Gadil123/esp32-design/docs/30_g_v1_hardware_arrival_space_and_mic_assessment.md

# G-V1 到货第一轮：空间、MIC 与缩宽闸门（2026-10-19）

**第一阶段已完成；第二阶段实体改壳暂缓。机械基线仍是 `ee8ec9d`。不批准打印。** 本次从已合并 PR #3 的 main 新建独立 PR，仅增加实测输入、可复现的精确空间检查和真实 CAD 剖面。冻结前壳、后盖、BOOT/BAT_PWR/RESET、四金属安装件/螺丝、USB/TF、格栅与 E/Pocket OS 均未修改。没有为取得 PASS 删除原有失败工况。

最小决定：保留当前 99.60 × 77.86 × 12.369521mm 外形；保留正面单个 Ø1.5mm 孔为**有几何依据、尚未切入壳体的候选**，不建立导音管或新隔舱。需要先确认 MIC1 声口、完整电池出线包络及扬声器接线/承托，再实施可审查的局部改壳。CAD 能证明主体不碰撞，不能证明这些未知接口已经装得上或收音不退化。

## 依据与证据边界

已阅读 README、报告07/24/27/29及 [Issue #4](https://github.com/Gadil123/esp32-design/issues/4)。截至本次读取，Issue 无评论、无新增声口照片；用户本轮文字测量另列为输入。旧冻结文档保持原样，旧尺寸不被偷偷改写成实测事实。

- 用户电池主体 42.26 × 29.49 × 7.61mm；在统一坐标中取 **X29.49/Y42.26/Z7.61**，中心仍 X48.4/Y14.5。不是完整电池总成或厂家 CAD。
- 用户扬声器主体 30 × 20 × 6.5mm、线长约40mm。端子、出声口、线长量法及胶/泡棉仍未测定。
- 用户实测 Factory V1.1/小智：FRONT 朝用户、PCB下绝缘泡棉，30–40cm清晰，超过2m可对话但减弱；REAR朝用户30–40cm变闷。作为满意的裸板基准，**不是声口朝向证据，也不是可直接量化的装壳性能验收**。
- [官方硬件资料索引](https://docs.waveshare.net/ESP32-C5-Touch-LCD-2.8/Resources-And-Documents/)与只读仓库 `schematic/ESP32-C5-Touch-LCD-2.8.pdf`：MIC1符号标为MIC1，四引脚 VDD/GND/GND/DAT，经网络接到音频电路；没有可识别的实装麦克风料号、封装机械图或 PCB 声学钻孔图。ES8311 是编解码器，不能代替麦克风声口资料。
- 精确原始 STEP：逐层累积 occurrence 位姿后绕 Z 旋转180°，**USB +Y，FRONT +Z，REAR −Z，侧键/TF LEFT −X**。全部723物理实体进入实际 BRep 碰撞检查。电池/扬声器仅有主体尺寸，因此明确使用主体包络；不将它们称为精确配件 CAD。

## MIC1 与单孔候选

| 检查 | 结果与限制 |
|---|---|
| MIC1 实体 | X21.53527…24.13571、Y−0.30619…3.09415、Z−6.60000…−5.60200mm；只有6个平面 |
| 封装/实际声口方向 | 名义六面体安装在 PCB 背侧；**具体型号、内部声口位置、顶/底进声均 UNVERIFIED** |
| PCB声学孔 | 在封装中心 X22.83549/Y1.395 放置半径0.3mm穿板探针，实交体积0.45238916mm³，约等于1.6mm实心板段0.45238934mm³；**STEP中心未建通孔**。不是全区域钻孔扫描，不能据此宣称实物完全无孔 |
| 正面候选孔 | **X27.30/Y1.395，Ø1.5，沿 Z 穿过1.2mm前面板**；板、屏、配件不与孔切削体相交；孔与前壳真实交体积2.120575mm³ |
| 与屏幕关系 | 右侧玻璃名义边 X25.27附近；孔近侧边 X26.55，留约1.28mm横向距离；不是在触摸玻璃上开孔，不挤压玻璃 |
| 自然空气间隙 | Ø0.5几何探针从孔后 X27.3/Z−0.8 沿现有间隙到 Z−7.1，再向 X22.83549，止于 Z−6.85。三段对全部原板实体及实际冻结壳体/候选配件均无实交 |
| 到实际声口 | **UNVERIFIED**：以上仅到封装外侧，未接到已知声口。没有把探针实体做成导音管，也没有把空气连通等同于声学低损耗 |
| 手指遮挡 | 孔在 FRONT、玻璃右侧靠中部；右手拇指/手掌可能覆盖。需握持照片/录音实测，未声称可达性通过 |

因此选择 A 作为待核实的唯一候选，不推进 B。现有证据没有显示需要复杂声道；也不足以把“封装外侧空气可达”当作实际收音通路，**本轮没有盲钻壳体**。

需要补充：统一朝向带比例的 MIC1 正反面与侧面微距、可读顶标；确认封装表面声孔及对应 PCB 正面区域（如被屏幕覆盖则请厂家提供料号/封装与钻孔资料，不要求破坏性拆屏）；确认该孔与 PCB/屏幕间隙的关系。不得根据本轮接近实心的中心探针臆造底孔或断言顶进声。

## 电池 Z 向链与 XY 收益

| 从 REAR 到 FRONT | 数值/状态 |
|---|---:|
| 后盖外表面 Z | −11.35mm |
| 后盖主体 | 1.20mm候选，原版不改 |
| 后盖内底 Z | −10.15mm |
| 胶层 | 0.20mm候选，未实测 |
| 电池主体 Z | −9.95…−2.34mm，厚7.61mm实测 |
| 前舱面板内表面 Z | −0.50mm |
| 主体上方几何净空 | **1.84mm** |
| 原候选膨胀预留 | 1.00mm，非电池厂家规范 |
| 扣除该预留后的剩余量 | **0.84mm** |
| 保护板、焊点、折弯、连接器 | **未知，不填0，不保证能放进剩余量** |

主体和候选膨胀探针均不碰真实壳/原板；主体随旧后盖初次抬角路径也无碰撞。**不是电池完整包装可安装证明**；不能让胶层、公差或软包压缩来“吸收”不足。若保护板叠在主体上，需检查其真实总厚；若从端部伸出，需计入平面及弯线半径。保持现有后盖，未为未知厚度先改整机。

旧34×50mm主体占地1700mm²，新29.49×42.26mm占地1246.2474mm²，约减少26.7%；X节省4.51、Y节省7.74mm。现位置主体 X33.655…63.145、Y−6.63…35.63；这部分空隙可优先用于保护板/接头/线束，而不是直接删掉外壳。旧槽名义内框35×51mm，相对居中的新主体每侧X约2.755mm、Y约4.37mm；实际围框另有开口/截断。因此**旧托盘不再构成贴合定位**，当前检查只覆盖居中姿态，不证明滑移后的安全。后续需按完整配件包络局部缩围框，或验证适合软包的少量固定材料；不能依赖前后壳挤紧电池。

缩宽局部敏感性直接截取**真实右下卡扣接收座**：向内移2mm未碰扬声器/电池/其余前壳；向内移4mm与原扬声器围框相交17.1252mm³，见 `width_local_checks.json`。该测试没有重新设计卡扣、工具释放、止口、托盘或整机路径，**2mm仅局部可研究，不是完整97.6mm窄壳通过**。30mm宽扬声器也已大于新电池29.49mm，电池节省量不是机身收益上限的直接答案。

本轮推荐**实际缩宽0mm**；可先保留约0–2mm的保守后续研究范围，不承诺4mm。2mm仅约2%宽度收益，却需联动右侧扣/座/止口/托盘与拆盖工具，当前未知完整配件包络时不值得先做。待实物接头摆放确定后，可由释放出的平面空隙决定是否值得局部缩宽，不增加长度，也不扩展结构方案搜索。

## 扬声器承托、线束及局部隔离

- 格栅、前侧泡棉候选0.5mm（含胶）、后阻尼候选0.3mm（含胶）保留。扬声器主体6.8改为6.5mm用于评估，前出声面位置不变；新阻尼背面与旧四承托块留 **0.30mm间隙**。不能宣称已固定可靠，后续按实物决定局部承托高度或真实缓冲厚度，不能任意加泡棉挤紧。
- 当前扬声器围框和候选周边泡棉提供局部定位/接触区域，但围框出线缺口存在，PCB区与扩展仓也不是完整气密隔断。扬声器前缘密封若不连续，存在前后声学短路及内部空气耦合至 MIC1 的风险；结构连接也可能传振。**风险存在，程度未经声学实测**，不将开放间隙直接等同于已发生严重失效。
- 旧 MX0→扬声器条件路径的真实圆角中心线约 **79.46mm**，超过到货线长约40mm；原路线不适用于实际40mm引线。旧 MX1 电池路径约86.82mm也只是条件代理。插座−X开口由真实腔体推定；MX0/MX1功能对应、插头/极性、配件端出线点和可用线长未闭环。**不能据旧路线过长判定40mm在任何布置下都不够，也不能宣称已连得上。** 需实物插头照片/配件端位置后做最短实际走线，再验证开盖服务余量。
- 暂不新增完整隔舱或麦克风专用通道。最小后续措施优先核实扬声器真实出声口与完整前缘泡棉接触，再按明确漏声处局部封边/减振；保留出线，避开软包。电池和扬声器之间不增加专门 MIC 声道。没有把 AI Passport 作为内部气密结构证据。

## 自动检查结果及未关闭门槛

复用原整机检查，先确认重新生成前/后壳相对冻结实体对称差均为0mm³；不替换成旧G或E。新主体下：

- 723原板实体对壳与配件静态碰撞为空，安装部件间实交为空。
- 原板完整装入/反向拆出、43块真实后盖分区覆盖及连续拆盖路径、两浅扣单撬片顺序拆卸、四螺丝/工具、独立USB插头/TF卡/RESET针检查保留；名义几何闸门通过。
- **原始侧键失败保留**：止口0.20＋孔隙0.15＋候选打印凸点短0.30mm组合，BAT_PWR/BOOT仍差约0.055722/0.053803mm，`BLOCKED_CONDITIONAL_PRINT_FIT`。不猜开关行程，不改冻结按键。
- 名义最大厚12.369521mm、含既有后盖刚体游隙上界12.386283mm；没有把工艺偏差或电池/线束变形包含在保证里。
- PA12壁厚/凸点/卡扣、螺丝扭矩与蠕变、真实安装件/螺头、反复拆装、真实USB/TF、整体公差均未关闭。静态主体PASS不关闭完整接线、承托、装壳录音与制造门槛。

## 交付、复现及第二阶段退出条件

环境沿用报告24：项目 `.venv`、`requirements.lock.txt`、build123d，无GUI、不改官方文件。一条命令从原厂STEP重做本次评估：

```bash
./scripts/assess-g-v1-hardware.sh
```

输出在 [评估目录](../deliverables/g-v1-hardware-assessment/README.md)：JSON结果、MIC/电池Z剖面、PCB/电池/扬声器剖面、新旧同尺度布局。图来自真实 BRep 剖切；电池/扬声器色块是明确标识的主体包络。另在 `build/g-v1-hardware-assessment/assessment_NOT_RELEASED.step` 生成含完整723实体的查看装配，**不是改壳发行件，也不是可制造整机**。没有复制完整官方STEP进Git历史。查看模型回读727/727实体有效；授权下载命令见交付目录README，实际下载记录见 `download_verification.json`。

阶段二暂不产生“已修订”前后壳STEP/STL，避免把未确认声口/线束包装成已完成模型。原冻结STEP/STL与下载说明28继续有效。补齐以下信息即可定点推进，不需重新搜索结构：

1. MIC1声口和PCB实际通孔/间隙照片或实装料号资料，及推荐孔位置的握持遮挡检查。
2. 电池含保护板/封边/焊点的最大尺寸与出线方向；连接器、线束可用长度、弯折空间和厂家安全余量。
3. 扬声器出声面、端子/线端位置、40mm线长起止、实际插接到哪一个座、泡棉/胶/阻尼实厚及承托试放。
4. 后续实机与裸板在同固件、距离、说话音量/环境下比较 FRONT 30–40cm与>2m录音/对话；再加扬声器播放时串音、常用握持遮孔、开盖服务余量及反复装拆。收音不得明显退化；不凭一次对话或CAD宣布验收。

本次是针对信息缺口的工程闸门结果，不是打印许可；提交独立PR等待Reviewer，无合并、下单、固件或Pocket OS更改。
