Gadil123/esp32-design/docs/29_g_v1_design_freeze_and_hardware_handoff.md

# G-V1 首版 CAD 候选冻结与实物复测交接（2026-10-17）

> **状态：CAD DESIGN BASELINE FROZEN / HARDWARE PENDING / NOT PRINT APPROVED。** 用户认可目前 G-V1 的总体设计，本轮停止进一步按键/机壳外形迭代；待板件、电池和扬声器等实物到货测量后，再做少量有针对性的尺寸修订，尤其确认 MIC1 声学孔。这里的“冻结”只表示**保存可复现的设计基线**，不表示制造、功能、可靠性或最终下单获批准。

## 唯一当前基线（勿混用旧版 G 或方案 E）

- **基线提交：`ee8ec9d`**（PR #3，Task26）。后续此文档/README 的归档性变更不改变基线 CAD。
- **整机架构：** G-V1 深前壳 + 可拆后盖，Waveshare ESP32-C5-Touch-LCD-2.8 旋转到 USB 顶部（USB +Y；屏幕 FRONT +Z；原生侧键和 TF 在 LEFT −X）；屏幕与前框名义齐平，无玻璃压边。
- **按键：** KEY1/BAT_PWR 前壳一体 L 形 PA12 弹片；KEY2/BOOT 前壳一体圆角矩形弹片，参考长13×高3mm、有效梁11mm、厚1.2mm；RESET Ø2.2mm 卡针孔。**没有独立键帽。** 使用方位和局部止挡详见 [报告27](27_t0_g_v1_boot_rectangular_key_revision.md)。
- **固定：** 后盖两处对角浅卡扣 + 非锁定定位止口；四颗候选普通 M2.5×4 机螺丝从 REAR 外侧贯穿 PA12 承力座，连接原厂 PCB 金属 M2.5 螺纹安装件；先卸螺丝、再用一片约0.8mm塑料撬片顺序拆盖。
- **候选实体：** `deliverables/t0-g-v1-boot-rect/front_shell.step` / `.stl` 为**新版前壳**；后盖仍使用**未修改**的 `deliverables/t0-g-v1/rear_shell.step` / `.stl`。不能误用旧 `t0-g` 的12.9mm后盖、独立帽或四隐藏扣。
- **名义装配：** 官方原板 723 物理实体；完整 STEP **739/739 有效**，外包络 XY 99.60×77.86mm，名义厚度12.369521mm，含已建模后盖刚体游隙的上界12.386283mm。**通用制造公差、实物变形或翘曲不包含在这些保证中。**
- **完整 STEP：** 见 [私有下载及 FreeCAD 操作说明28](28_g_v1_private_download_freecad.md)。旧 `e805d38` 完整组装 ZIP `t0-g-v1-review-complete.zip` 与 Task26 新 ZIP `t0-g-v1-boot-rect-task26-viewer.zip` 保留。原板全723实体分组可显隐/视觉分解，GLB/Light STEP 是含代理的快速预览，**不能当精确装配净空证据**。Draft Release 的普通页面曾 404，使用已验证授权命令或服务器 SCP。

## 本轮已收敛 / 不再重复搜索

1. G-V1 结构方向及 BOOT 圆角矩形外形已被用户接受；BAT_PWR 保持 L 形；E/旧 G 等历史 CAD 与失败证据冻结保留。
2. 不继续讨论独立键帽、复杂按钮机构、精确到几十微米的纯软件过度优化、复杂 FEA 或重新开发 Viewer；后续仅由**实际尺寸和装配观察**驱动局部变化。
3. 当前仓库的 CAD 名义验证与 Reviewer 复审可以作为下轮对照基准，但不等于实际产品验收。

## 必须保留的未验证事实

| 条目 | 当前情况 | 到货后处理 |
|---|---|---|
| 两侧键触达 | 后盖止口0.20＋螺孔0.15＋凸点假设短0.30mm的组合下，KEY1/KEY2在参考止挡时尚差约**0.05572/0.05380mm**；`BLOCKED_CONDITIONAL_PRINT_FIT` | 实测按键触发、行程、按力、回弹，必要时局部调整凸点/止挡并重验双向装板，不能直接凭理论尺寸加长0.12mm |
| BOOT 新片 | 同材简化模型刚度约旧片1.5倍；根应变估算2.08%；力与寿命未知 | 实物感受、检查根部及止挡；不宣称 PA12 疲劳已验证 |
| 电池/保护板 | 34×50×5mm、0.2胶层与后盖1mm浅围框均属临时包络 | 实测外形、膨胀余量、保护板、连接器及出线方向 |
| 扬声器 | 30×20×6.8mm、泡棉和前壳围框/后盖支撑为候选 | 实测结构、喇叭出声面、线束与缓冲 |
| **MIC1** | 唯一麦克风；官方 STEP 不证明实际进声孔朝向，**尚未设经过验证的声路** | **先确认实际 MIC1 声孔与 PCB 朝向，录制裸板音频基准，再设计正确位置/形状的声孔或导音道，并装壳对比**，不盲开孔 |
| MJF/螺丝/装配 | 局部0.8–1.2mm薄壁、止口/扣间隙、4×1mm承力座；实物螺丝规格、线束和真实卡扣手感尚未验证 | 厂商审核前后壳 STEP/STL，轻拧实际螺丝、测试单撬片拆盖、真实线束余量和USB/TF插拔 |
| 最终尺寸 | 12.4mm仅设计名义目标，后盖可能受工艺偏差 | 实物验收、按厂家反馈局部修正；勿宣称成品尺寸确定 |

## 到货后如何继续

下一阶段统一跟踪 [Issue #4 · 到货后实测与 MIC1 声孔](https://github.com/Gadil123/esp32-design/issues/4)。请先拍正反面、侧键、MIC、原厂安装件、所购电池/喇叭和接口特写，并记录实际卡尺测量；**先收集实物证据，再开新的小 PR 修改**。保留本版原始 STEP/STL 以便新旧对照。

**此次 Git 归档不代替嘉立创 DFM 审核，不意味着用户已下单，也不触发提醒/未来自动开发。**
