Gadil123/esp32-design/docs/16_t0_d_local_passport_study.md

# T0 D：短边缘卡齿 + 后盖浅窝，局部装配闸门

**结论：BLOCKED，缺少 PCB 朝 FRONT（+Z）的保持反力。** 本轮只提交一个局部短齿配对与四安装位浅窝，不重写整壳、不回退螺丝或旧四弹性夹位。A/B/C、Pocket OS 文档保留；不合并、不打印，交原 PR #3 复审。

依据：[本轮唯一有效实施指令](https://github.com/Gadil123/esp32-design/pull/3#issuecomment-6214796520)，以及此前 C 复审。后者的“先失败就停止”原则仍适用，旧 C 刚性前环台装入失败没有被撤销。

## 一页证据表：仿结构分工，不从照片量尺寸

资料：[EEWorld 拆解](https://bbs.eeworld.com.cn/thread-1367442-1-1.html)、[与非网同一拆解](https://www.eefocus.com/article/2089827.html)。本轮成功读取与非网正文及图注；EEWorld 请求超时、内嵌照片返回拒绝访问，**没有冒充独立数齿或识别隐蔽承力面**。照片特征以本轮 Reviewer 已审阅的描述为依据；正文可以交叉核对免螺丝拆盖事实。

| 证据层次 | 可用事实 | 不能据此推定 | 本轮 CAD 处理 |
|---|---|---|---|
| 拆解正文/图注 | 后盖沿边缘撬开，无螺丝、无封壳胶；边缘有槽与凸台 | 所有槽都是同构卡扣、固定扣数或寿命 | 只建一对短齿/窗，不选整机扣数 |
| Reviewer 已看照片的记录 | 短边缘结构、圆形柱状结构可见 | 五柱均固定 PCB、七处均为弹性扣；柱下隐藏接触关系 | 浅窝仅是 T0 候选，不能写成复刻的原机板固定方式 |
| 工艺/板卡差异 | 原机定制 PCB/注塑；本机完整微雪板/MJF PA12 | 注塑的弹性、公差可直接移植 | 短齿刚体让位与材料能否实现分开报告 |
| 原始 STEP 可量测 | 原板四金属安装件、外周/背面、显示与 PCB 相对位置 | 金属螺纹孔是空 PCB 孔，玻璃可承夹紧力 | 外周浅窝、中心避空；不用玻璃承力 |
| 本轮实建几何 | 1.5mm 竖向短壁、0.7mm 齿、连续搭接边 | 是照片原尺寸；等于原 A 的 12mm 横梁 | 所有候选尺寸集中参数化，旧 A 不改 |

## 一个候选的实际结构与装拆边界

坐标仍是原始 STEP 累计 occurrence 后绕 Z 180°的刚性旋转：**FRONT +Z，REAR −Z，USB +Y**。FRONT 看原生键/TF 在左。名义玻璃/前框 Z=+0.70，后盖外面 −11.70、内面 −10.50；目标外形 99.60×77.86，局部实体最大厚度 12.40mm。这里只建板周开放前框、四个后盖承座块和右边缘一个配对，**没有完整 D 外壳，不能声称整机装配通过**。

短齿位于右边 X≈70.13、Y=−4，避免已保留的侧舱临时配件。接收壁厚 1.5，窗宽 5.6；后盖短壁厚 1.5、宽 5.0，齿向外伸 0.7，搭接间隙 0.3、实际保持重叠 0.4。前壳局部接收件向后延伸至 Z=−7.6，使窗下承力段达到 1.5；后壳对应边退至其后留 0.15 接缝。连续定位边在齿两侧延伸，不是另一组锁扣。

薄撬片候选厚 0.35、宽 2.0，从外侧接收窗接近，向内让齿 0.5；单扣退后局部 2.8 后才允许回弹。检查包括名义配对、退后 0.3 的保持交叠、自由端内移后的扣入/拔出扫掠及外部工具通道。**自由端内移采用刚体让位代理，不表示根部也可以平移，更不等于真实弹性变形已通过。** 根部固定、受力点至根约 4.6mm，简单悬臂估计表面应变约 5.3%；该短厚结构已超出可凭线性估计放行的范围，根部应力、实际扣入力、回弹与寿命均待验证。完整薄盖逐个开扣、保持前一处张缝未验证；不把一个扣的自由端让位升级为整盖可拆。

四浅窝使用原厂外径约 5.5 的金属安装件，背面 Z≈−9.50；后盖到该面仅约 1.00。环形承面中央 R1.6 避空，不插螺纹孔；窝壁厚 1.5、外周包覆高度 0.8，原件后端约 0.2 倒角使有效直壁配合约 0.6。沿用 C 的候选基准余量：左侧两窝径向 0.1、左上沿 Y 再放宽 0.3，右侧径向 0.3。没有过盈、胶粘或未知弹性预压。

## 唯一主要阻断：浅窝没有 +Z 反力

| 自由度/载荷 | 本候选真实作用 | 状态 |
|---|---|---|
| X/Y、绕 Z 转动 | 在金属外周仍位于浅窝内时，两分离左基准限制横向及偏转；右窝避空 | 有限游隙，0.1 配合未获工艺验证 |
| 向 REAR −Z、单侧倾转载荷 | 四环形背面承座提供单向支撑 | 名义接触；不向电池/玻璃施力 |
| **向 FRONT +Z** | **没有前挡或止退接触面；浅窝朝前开放** | **FAIL** |
| 开盖后的 PCB 保持 | 后盖移开即失去这些承座 | 不能声称 PCB 留在前壳可靠定位 |

完整官方模型的 X/Y 包络在开放前框通道内，可连续沿 Z 穿过，避免旧 C 预装前环台挡住屏幕。装入能通行同时也暴露保持问题：**后盖不动，整块 PCB/显示总成仍可向 FRONT 移动 0.4mm**，玻璃随之高出名义齐平面。对固定局部件向 −Z 作连续扫掠，等价检查原板向 +Z 的整个区间，保留环窝/开口真实空腔，不用实心包围盒填掉它们。零碰撞的逃逸反例足以否定“可靠三轴定位”，无需推到完全拔出才判失败。

前壳加挡块会重新涉及装入障碍，改用玻璃、键帽、插座、线束或电池挡住前移也不符合约束。**本轮不提出/搜索补救机构。** 侧键接触依赖板位置，故即使名义附件不碰，也不能关闭原有偏移/固定框风险或保证触发；未知开关行程不赋值。

序列记录在报告中：先置键帽→整板从 REAR 进入开放前框→浅窝随后盖就位→单个短齿扣合→检查闭合后板保持（失败）→局部撬片退齿/取盖与取板。键帽安装及原厂开关穿越、真实线束接插顺序、整盖逐个释放仍未验证。到本闸门停止，未把这个序列写成完整装配 PASS。

## 最小交付与复现

参数：[t0-d-parameters.json](../cad/t0/t0-d-parameters.json)；模型：[t0_d_study.py](../cad/t0/t0_d_study.py)；运行与图纸：[generate_t0_d.py](../cad/t0/generate_t0_d.py)。环境、原始只读 STEP 及 build123d 版本沿用 [T0 工程](11_cad_t0.md)。一条命令：

```bash
./scripts/generate-t0-d-study.sh
```

输出至 `build/t0-d` 和 [交付目录](../deliverables/t0-d/)：一组短齿/窗 CAD 剖面、一组四安装位/放板路径剖面、两份局部 STEP、最小检查报告。没有新小样系列、没有整壳 STL 或完整装配 STEP；有限交付遵循本轮指令。最终构建直接重读官方 STEP；全部原厂实体参与新增结构静态核查，USB/TF/MX、原有键帽、临时电池/扬声器/保护板/胶层/泡棉/阻尼/线束作为保留边界，不由本轮重新设计。

本次原始 STEP 重建完成：723 个原厂 solid 参与核查；新增承座/短齿配对与原板和上述临时附件未检出体积交叠。板周前框只是开放通道参照，尚未完成原生键/TF/USB 的外壳导向与开孔，**不将它计为接口已装配通过**。两份 STEP 回读分别为 2/12 个有效 solid，最大 Z 均为 12.400mm。单扣后拉 0.3mm 的保持交叠约 0.365mm³；退齿后的扣入/退出代理及外部工具净空无交叠。开放板通道四周名义包络余量均为 0.600mm；闭盖前移 0.4mm 的连续反例同样无干涉，因此可靠 Z 定位明确失败。

报告中的局部实体有效/名义净空通过不代表制造通过。黑色 MJF PA12 的 1.2 后盖、0.7 齿突出/0.1 齿尖平台、0.3 搭接间隙及 0.1 定位配合需商家和实物验证；0.3 间隙不能覆盖两个配对件各自的 ±0.3 参考误差。旧 USB 0.88 薄边、保护板 0.23 侧隙、MIC1 音口/录音、MX 身份与真插头、TF 弹出、侧键回弹等门槛保留，不扩大处理范围。

**退出：一个局部候选因缺少 PCB +Z 保持而停止；没有整机可装、可拆或可打印的通过结论。等待 Reviewer，禁止合并与打印。**
