Gadil123/esp32-design/docs/18_t0_g_recessed_full_wrap_cad_task.md

# T0 G：屏幕内沉的全包围深前壳＋嵌入式后盖（开发任务，2026-10-16）

> 用户已批准**开发并展示完整 G 候选**。本任务与 E 并列，不把 E 改成 G；E 的完整名义 CAD 已完成、留作回退与外观对照。对应 [Draft PR #3](https://github.com/Gadil123/esp32-design/pull/3)，本任务发布时 head `552fcf3fdea37b1cf5542549e643d3b19b2becf5`。G 不是已通过的设计，未获打印/合并批准。

## 0. 本轮范围与用户确认的结构

**只建模一条 G 主路线：** 
- **一体打印的深前壳** = 正面连续细边框 + 四周完整侧壁 + 右侧电池/扬声器仓前面板（含原六槽正面扬声器格栅）。盒口在 REAR；屏幕/原板从 REAR 方向垂直装入。
- **正面玻璃比外壳最高面下沉约 0.5mm**（设计目标，具体以真实板件尺寸链校准）。正面薄压边**仅适度盖住屏幕玻璃的非显示黑边**，尽可能形成隐藏黑框观感；不能遮挡有效显示/触控区域，也不能把玻璃作为承重/锁紧硬止挡。若官方 STEP 不包含可视区域边界，标明未证实并用保守候选，**不得凭空断言可盖住多少毫米黑边**。
- **后盖**是嵌入式、尽量平整的一片背板：**四颗从背面拧入原板自带的 M2.5 金属螺纹安装位的机螺丝**把原厂 PCB/屏幕总成锁在后盖局部承力座上。不是塑料自攻螺钉，不另加 M3 嵌件；不让螺丝穿透显示屏，也不把 PCB 作为外壳整体承力梁。
- **壳体合拢**：后盖周缘的浅**止口/插入凸缘**导向、前后壳接缝的**非玻璃承力硬止挡**控制闭合高度；后盖周缘的一体式**短弹性卡舌＋小倒钩**扣入深前壳**内壁卡槽**。外侧不设显眼侧面扣孔；后盖背部靠边留一处可从外部接近的塑料撬片入口。初始选取少量足够覆盖各边的扣位（约 3–4 处），**不要自动复用 E 的 5 短齿或 A 的 7 悬臂梁**；具体数目按真实装配布局确定且要说明。不要多方案搜索。
- **最大厚度硬上限由 E 的 12.4mm 放宽为 G 的 12.9mm**，包括原板、前壳、后盖、螺丝头、按键、临时配件等最大 Z 包络。当前 E 壳宽 `99.60mm`、长 `77.86mm`（侧键向左外伸 1.9mm，整体平面横向包络 101.50mm）保持 G 的尽量不超目标；必要的变化须列出真实原因。不因 0.5mm 内沉擅自再增加总厚。

## 1. 开发顺序：先关键装配闸门，再做完整 G 壳（避免 C1/D 重演）

**使用供应商官方 Waveshare STEP 原始全部 723 solids**，USB +Y、FRONT +Z、FRONT 左侧原生 KEY/TF；不要用 AI 效果图或轻量代理证明干涉合格。

1. **装板与开口：** 完整 LCD+PCB 从深前壳**背部开口进入、直线向 FRONT 落下**，直到 LCD 正面距外壳最外平面约 0.5mm。连续碰撞检查涵盖显示玻璃、原厂四金属件、USB、键、TF、MIC、MX 插座；区分开口非显示黑边薄压边与真实玻璃/可视区域，合理设软性接触缓冲候选，不能靠后盖顶压玻璃来消除游隙。
2. **PCB 与 REAR 螺丝真实夹紧路径：** 先选普通 **M2.5 机螺丝**而非自攻件，四处原金属螺母对准后盖过孔，背面工具可达，实际头部高度/径向承压面和螺杆啮合长度避免碰周边元件/显示屏。C2 曾在 M2.5×4 低头候选下仅得到 **0.8mm 承力 PA12 座**，**此风险不能由于换 0.6mm 超低头螺钉而假装已消失**；用真实可买螺钉的尺寸，检查四处剩余承压环、Z 包络、最薄打印壁，说明力从螺头→后盖承座→原厂金属安装件如何传递，实际抗扭/蠕变保留物理验证。
3. **分清连接功能：** 四颗 M2.5 **只连接 PCB 与后盖**，并不直接锁住深前壳。后盖通过周边卡舌+卡槽+止口接入深前壳。螺丝决定 PCB 在后盖的 Z 位置；前后壳独立硬止挡决定闭合；薄前压边只是遮黑边/保护，不应承担超出缓冲范围的 PCB 轴向预紧。以真实坐标说明 PCB 限位在各方向（尤其 +Z、−Z、绕 X/Y 翘起）如何成立、以及屏幕表面下沉距离的公差。
4. **卡接与拆盖：** 至少一对**真实实体**的后盖弹性卡舌/前壳内壁槽，加上可理解的周缘止口和装配碰止面；验证按下后倒钩进入凹槽、后拉能被保持、用薄塑料撬片可以逐处释放。检查 PA12 让位弯曲根部实际厚度、梁长、应变风险和制造间隙，**不允许仅以刚体移动量几何 PASS 作为五十次装拆寿命证明**。E 原短齿 4.6mm 有效梁、0.5mm 让位时简估应变约 5.3%，不是直接照搬可制造模板。
5. **装配次序检查**（这是必须实际模拟的）：后盖与完整原板先用四螺丝固定 → 将屏幕/PCB/后盖从深前壳 REAR 装入 → 边缘止口/扣舌锁住 → 拆盖时保持屏幕与后盖同行且不挤压前框。**特别核实原厂左侧独立实体键帽的安装顺序**：E 发现键帽先在前壳内会撞 LCD、必须装板后从 REAR 放入，但 G 的后盖预先连 PCB 可能阻断这种顺序；不能漏掉此装配闸门，也不能为方便而直接增设新电子键或封死维修。需要最小顺序变通则具体报告。
6. **右侧舱位/走线：** 前壳仍有正面扬声器、后盖仍可承托临时电池；软包电池不得被后盖锁紧力压迫，扬声器泡棉密封不得被加强筋占用。MX1.25 座朝原板内侧 −X，电池/扬声器和导线目前为临时包络；确认后盖+PCB 整组装入时导线能被安置，不能靠拉扯插头。USB 顶部与 TF 侧向插拔/弹出候选保持，MIC1 未验证声孔不要擅自钻孔。

**STOP 闸门：** 如果全板从背面进不了、四颗螺丝承压座在 12.9mm 下有无法克服的实质空间冲突、侧键无法合理安装，先输出**具体实体/剖面/最小让步**，不要换方案或做一整套失败外壳；已有实质几何通过后才完成 G 全壳模型。

## 2. 强度及外观重点——沿用简单成熟结构，不做 FEA 展开

- **连续前框与深侧壁是一体塑料零件**，四角、左侧 KEY/TF 开口和 USB 薄边注意局部过渡圆角；屏幕窗口边框形成抗外翻闭合截面，但不能声称已具有实测强度。
- **右侧电池舱+扬声器区**优先利用左右分舱隔梁、扬声器支承框和外侧壁形成结构连续性，只有在已知不碰临时配件的位置加必要局部筋；不得压缩软包电池所需余量或声学密封。
- **外观目标：正面没有任何螺丝、正面薄边框只露出显示有效区域（尺寸待核实）、屏幕下沉约 0.5mm、黑色外壳；背面可见四颗低头 M2.5 螺丝及分件接缝，尽量简洁。** 只做几何原生的黑/深灰可读 CAD 预览，不新增橙键着色工艺、装饰线、新外形变体；E 和 G 直接比较时使用**同视角、同 mm 比例**，而非 AI 生图的想象零件。
- **PA12 制造门槛明确**：细薄前框/扣齿、侧键间隙、0.8mm 螺钉承座、后盖薄板翘曲、真实玻璃/原板制造公差。只记录局部风险，不用通用“全部达标”替代真实承压/弹性验收。用户后续可能选择直接打第一套，**但本任务不批准打印**。

## 3. 有限交付：用户要“做一个 G 版本看一下”

- 在现有 `cad/t0/` 和 `deliverables/t0-g/` 新增 **G 独立参数、完整前壳/后盖/三帽 STEP 与 STL（如果几何闸门通过）**；四颗螺丝的真实模型/BOM 条目及可复现轻量装配 STEP/GLB；含真实全部官方 solids 的整机 STEP 尽量提交 review 压缩附件而非塞进 Git。
- 最少需要的**原生 CAD 图纸**：**FRONT、REAR、LEFT、ISO FRONT、屏幕薄压边与 0.5mm 下沉剖面、四螺丝承压与 Z 尺寸链剖面、后盖卡舌/内槽/止口配对及撬开示意、装配顺序图**。图中标注 FRONT/REAR/USB 方向，屏幕有效区待核实必须标 `UNVERIFIED`。
- 提交 **G vs E 单页对照**：外形（含侧键）、厚度 12.9 vs E 12.4、屏幕露出/隐藏黑边、背面螺丝/接缝、材料和卡舌数量、装配难点、PA12 风险；**不是“G 必定优于 E”结论**。
- 极简几何 gate/report：装入连续路径、四孔机螺钉及支撑/玻璃保护、后盖合盖/释放、USB/TF/键帽/右舱主要干涉、STEP solids 有效性/最大厚度。不再新增 14 件局部测试件，不做大规模材料仿真，不构造虚假零件测试集。

## 4. 操作与范围边界

- **E 是“完整名义几何成熟候选”并冻结保留**，A/B/C/D 和旧交付、Pocket OS 软件文档不变；不覆盖、改写已有 E CAD，不合并现有 Draft PR。
- 只做上面这**一种** G 深前壳 + 后盖螺丝固定板 + 止口/隐藏短扣方案；如果重大障碍 STOP 并拿剖面报告征询，不擅自追加两颗外壳自攻螺丝或重建 E。
- 不购买、不订料、不下单嘉立创、不批准打印；禁止 SHA 校验和无必要的大型测试框架。

**成功交付的表述：** `G full nominal assembly CAD complete; geometry reviewed; material/functional acceptance pending`，不可写 `manufacturing approved`。
