Gadil123/esp32-design/deliverables/t0-g-v1-integrated/README.md

# 任务23 局部装拆闸门

只针对两颗一体PA12侧键、真实止挡及官方完整板屏总成。未按/候选/止挡剖面、偏移见证、装入图、STEP/STL和报告可审查。局部模型不是整壳厚度证明。

完成整壳见 [G-V1](../t0-g-v1/README.md)，复现及边界见 [报告24](../../docs/24_t0_g_v1_integrated_pa12_assembly.md)。完整官方局部装配及最差偏移见证在私有Draft release新资产 `t0-g-v1-integrated-local-review.zip`；不提交原厂完整STEP至Git。

模型接触只证明几何可及；原生开关活动头、行程、PA12按力/回弹/寿命未实测。不打印、不下单。
