Gadil123/esp32-design/deliverables/g-v1-hardware-assessment/MIC_and_battery_XZ_sections.png

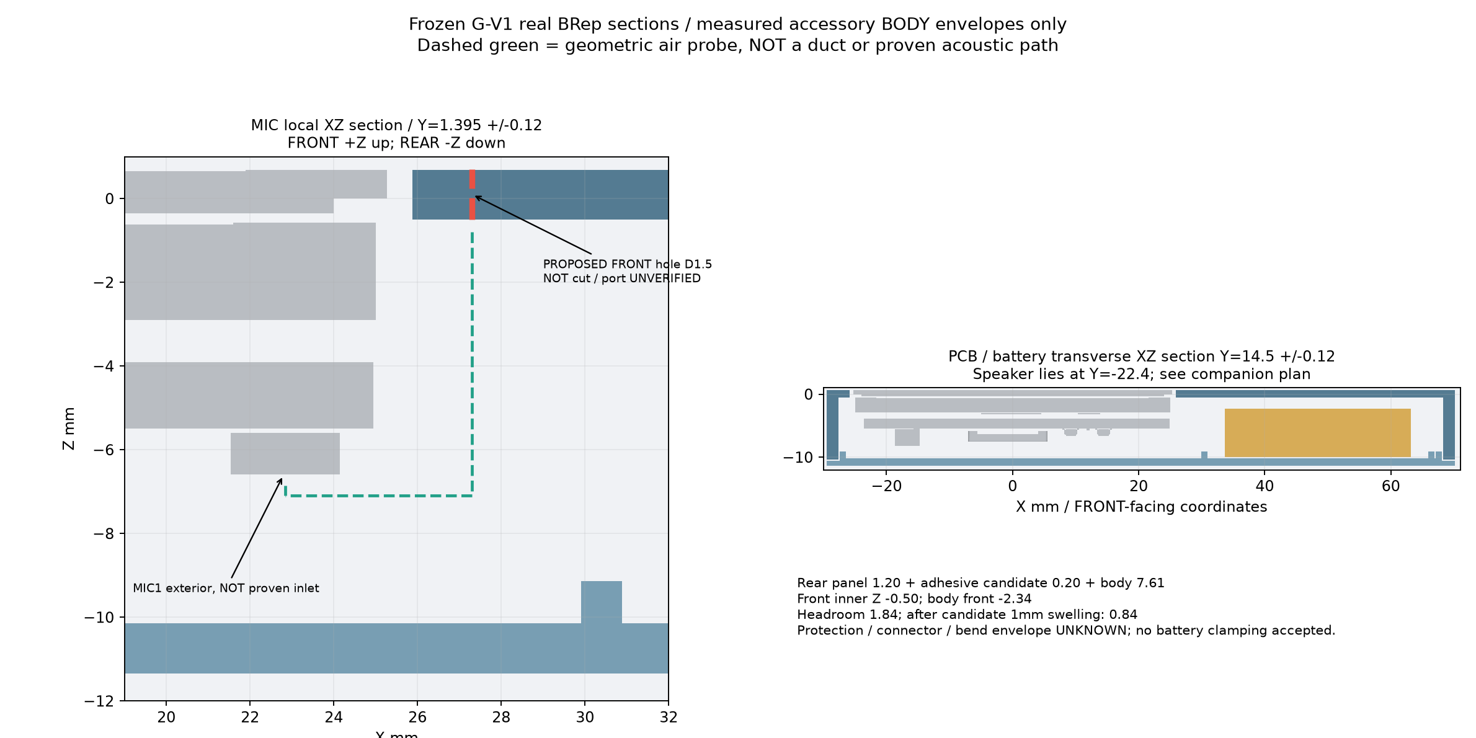
deliverables/g-v1-hardware-assessment/MIC_and_battery_XZ_sections.png
