Gadil123/esp32-design/deliverables/g-v1-hardware-assessment/PCB_battery_speaker_sections.png

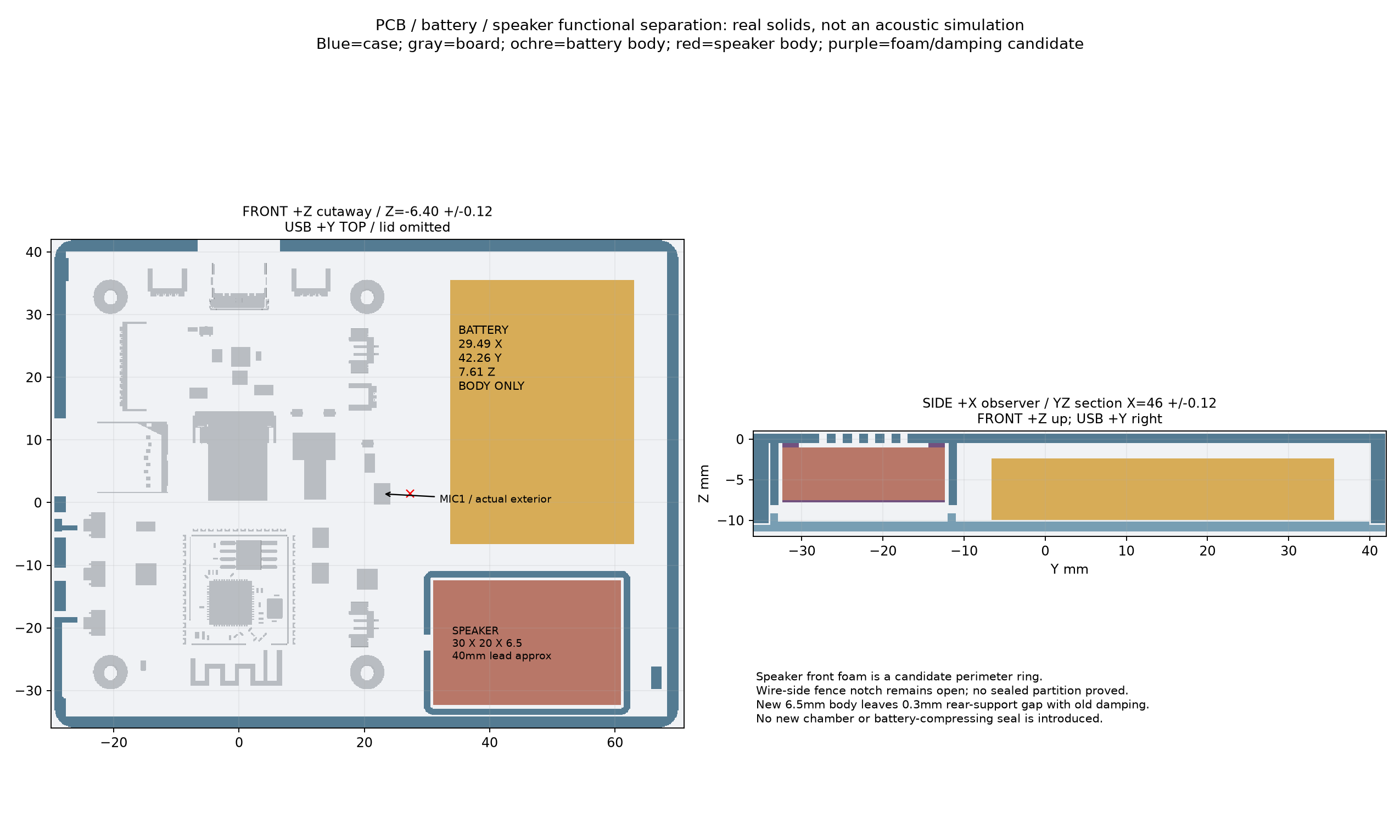
deliverables/g-v1-hardware-assessment/PCB_battery_speaker_sections.png
