Gadil123/esp32-design/deliverables/t0-a/12_4mm/connection_sections.png

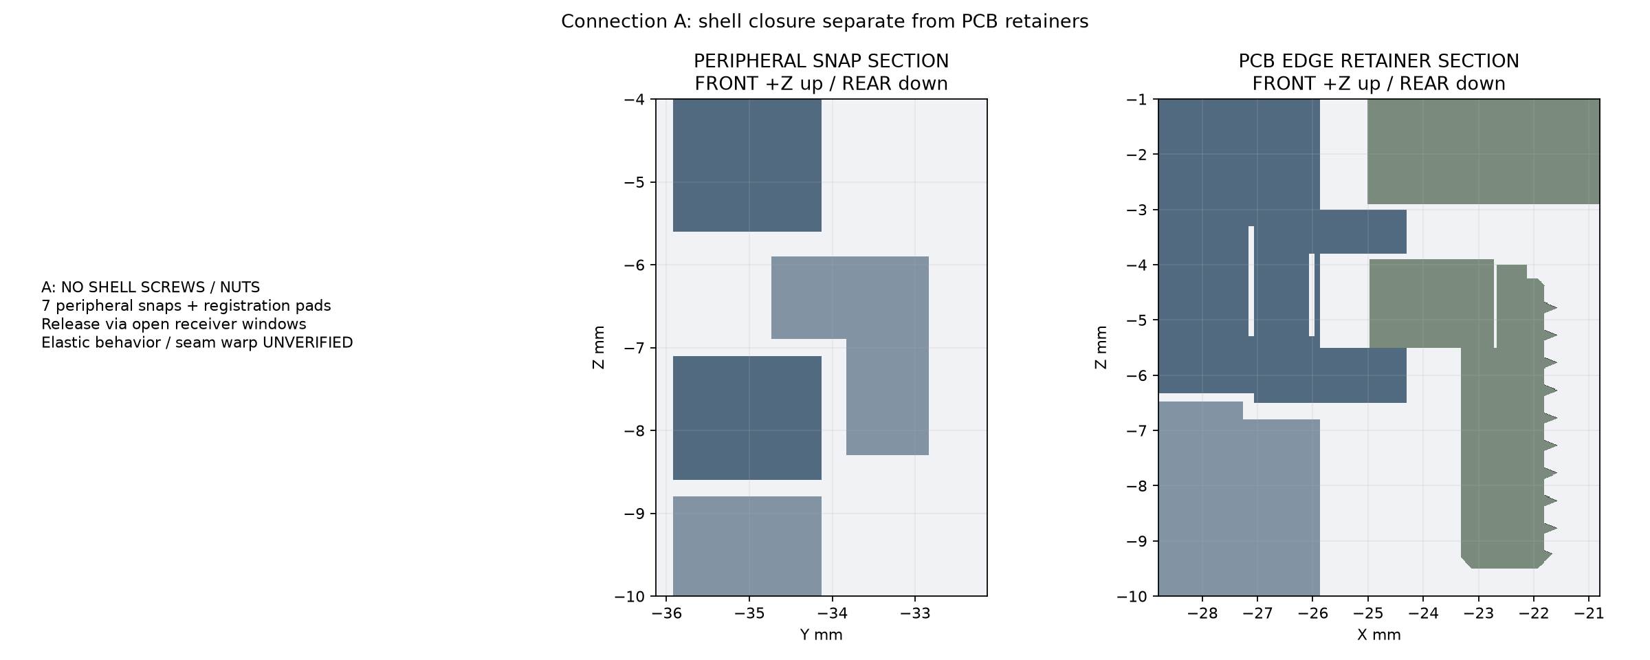
deliverables/t0-a/12_4mm/connection_sections.png
