Gadil123/esp32-design/deliverables/t0-a/12_4mm/orthographic.png

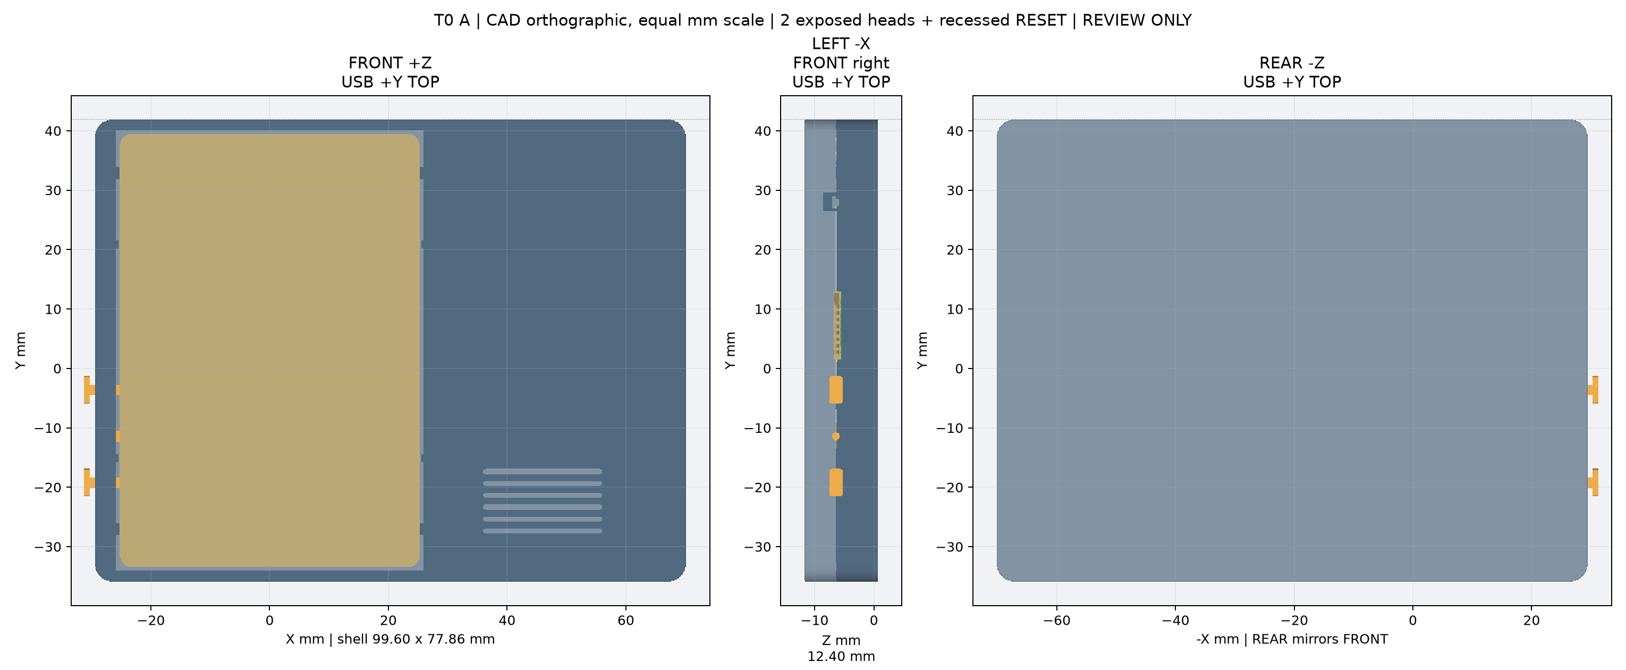
deliverables/t0-a/12_4mm/orthographic.png
