Gadil123/esp32-design/deliverables/t0-a/key-study/B_1_9mm/orthographic.png

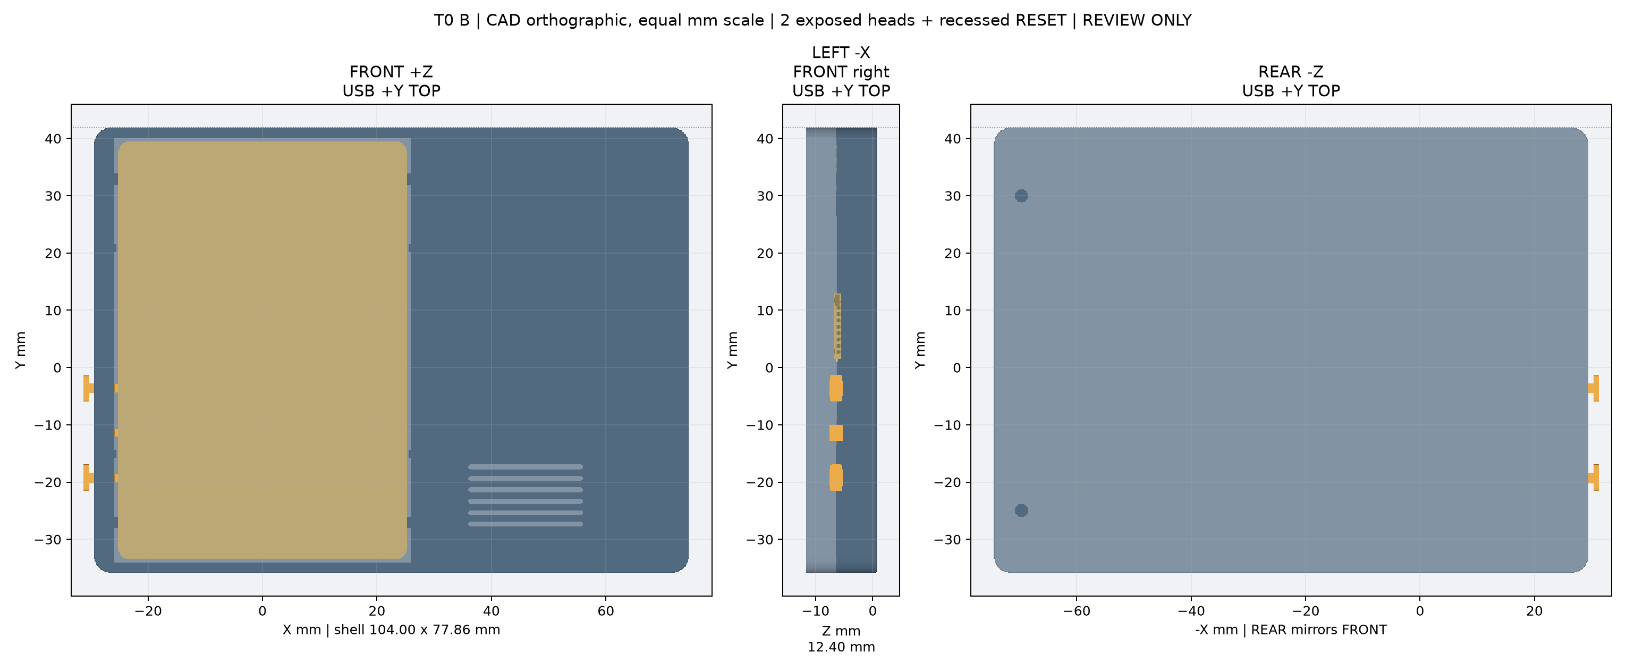
deliverables/t0-a/key-study/B_1_9mm/orthographic.png
