Gadil123/esp32-design/deliverables/t0-c/four_latch_release_plan.png

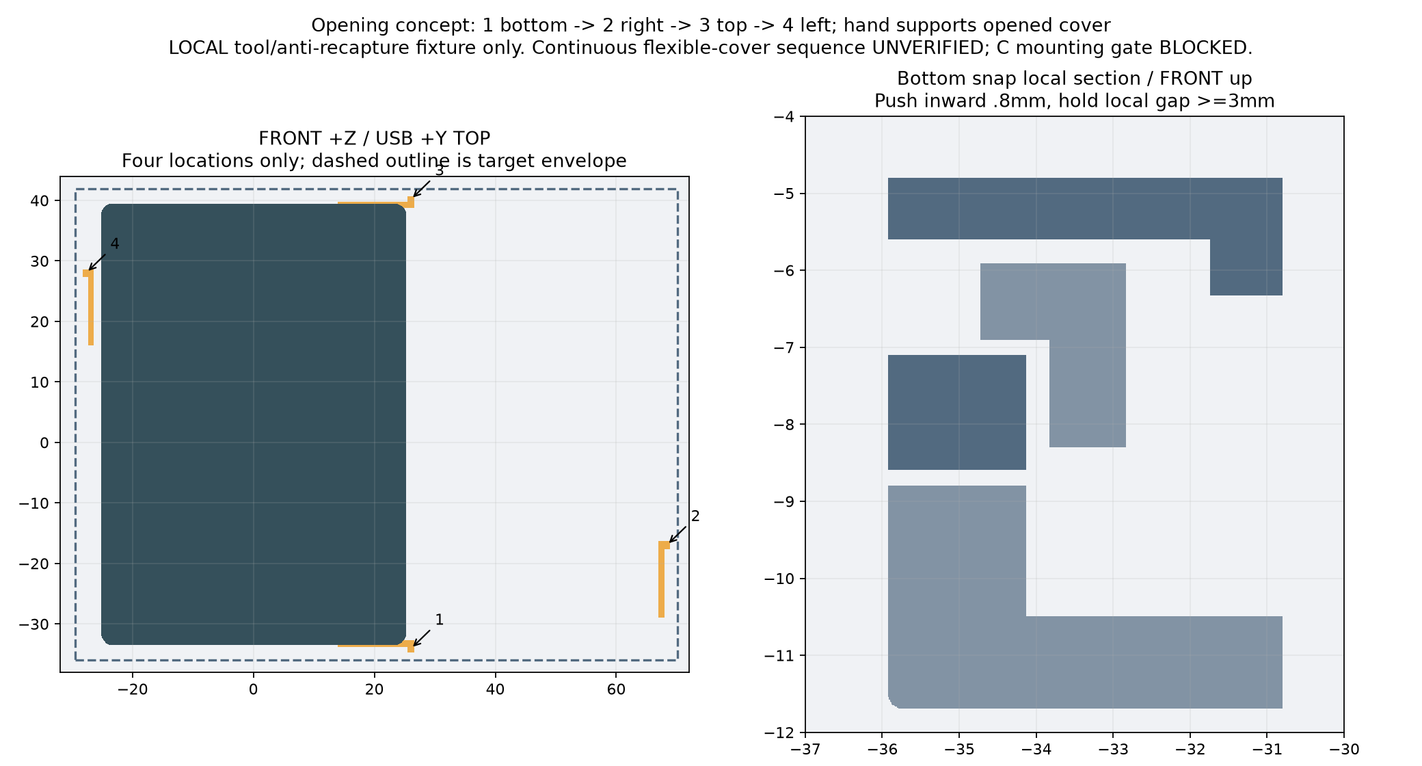
deliverables/t0-c/four_latch_release_plan.png
