Gadil123/esp32-design/deliverables/t0-c/key_sample_sections.png

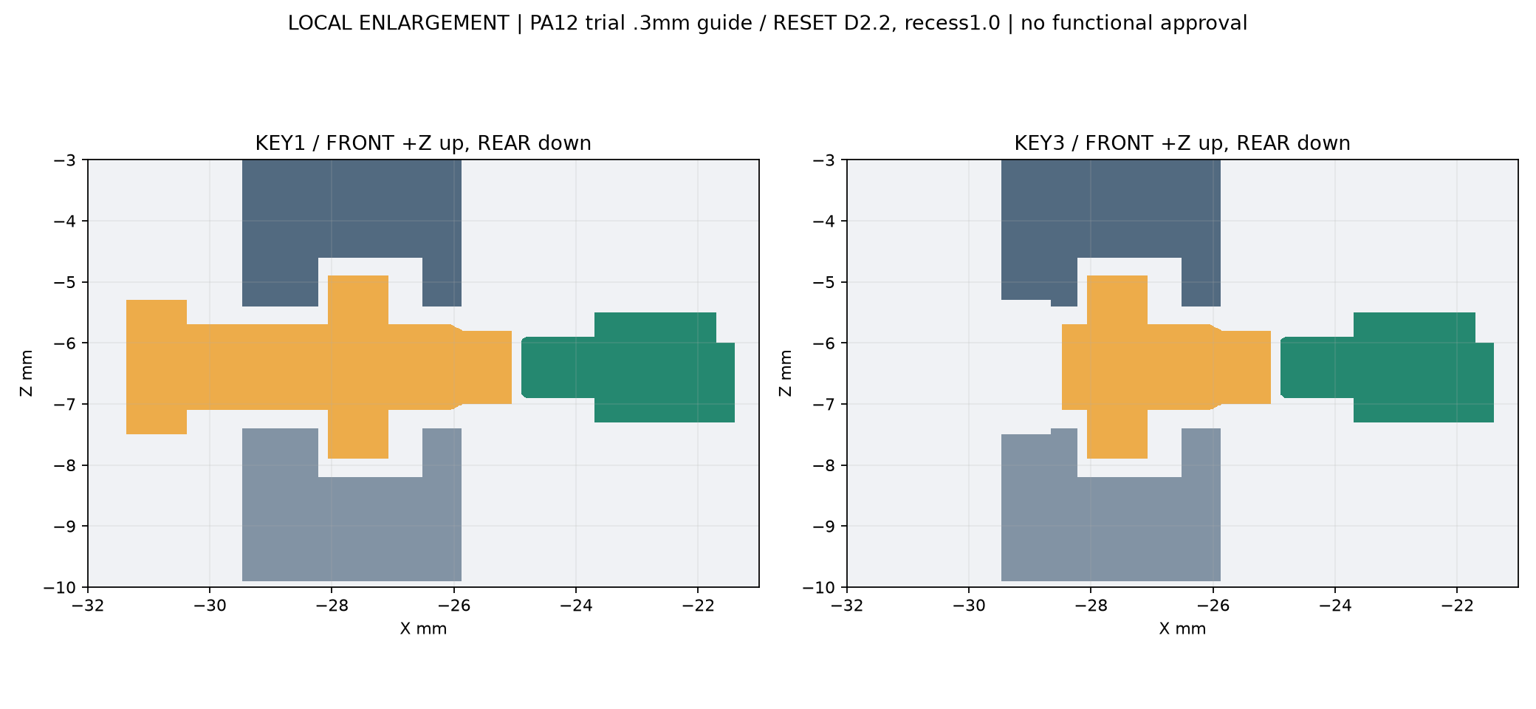
deliverables/t0-c/key_sample_sections.png
