Gadil123/esp32-design/deliverables/t0-c/mount_orthographic.png

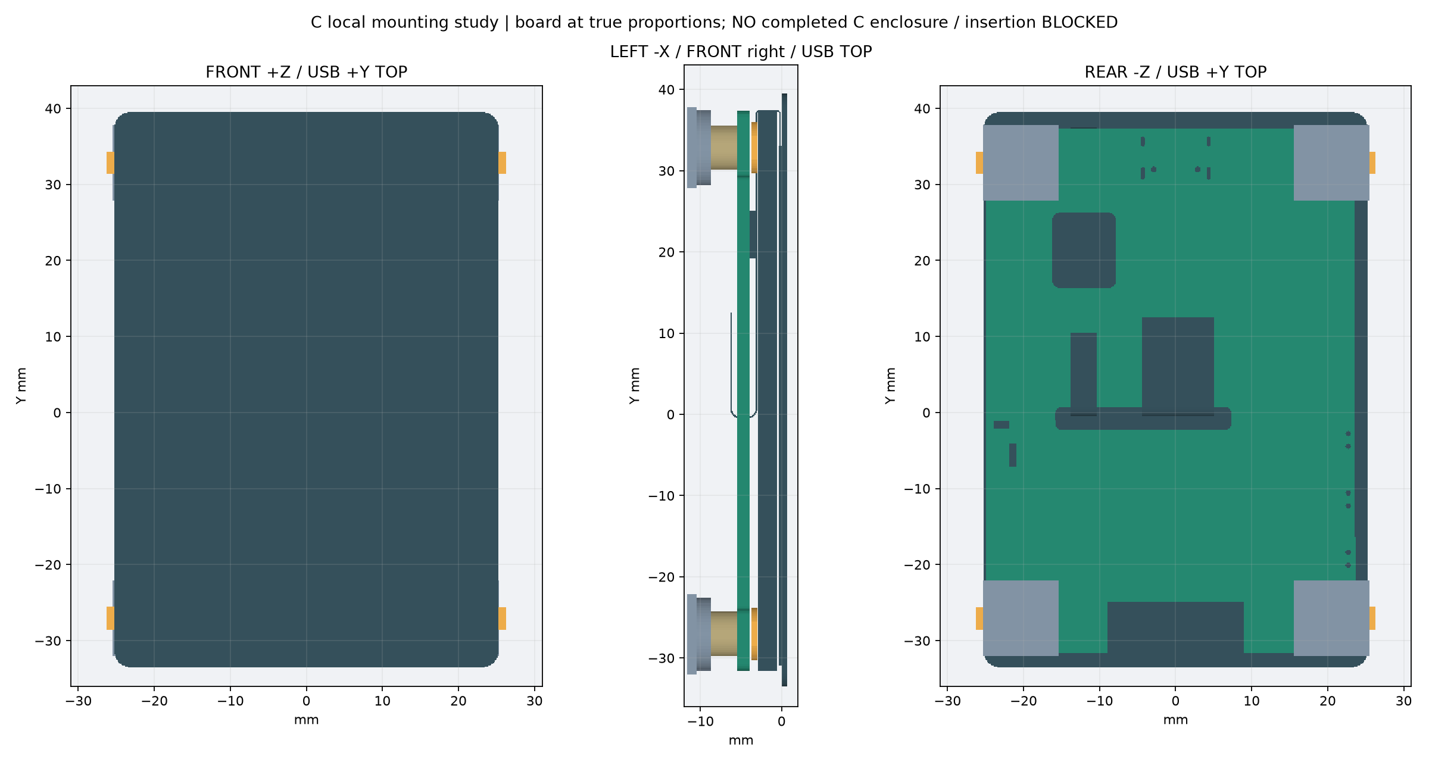
deliverables/t0-c/mount_orthographic.png
