Gadil123/esp32-design/deliverables/t0-c/usb_local.png

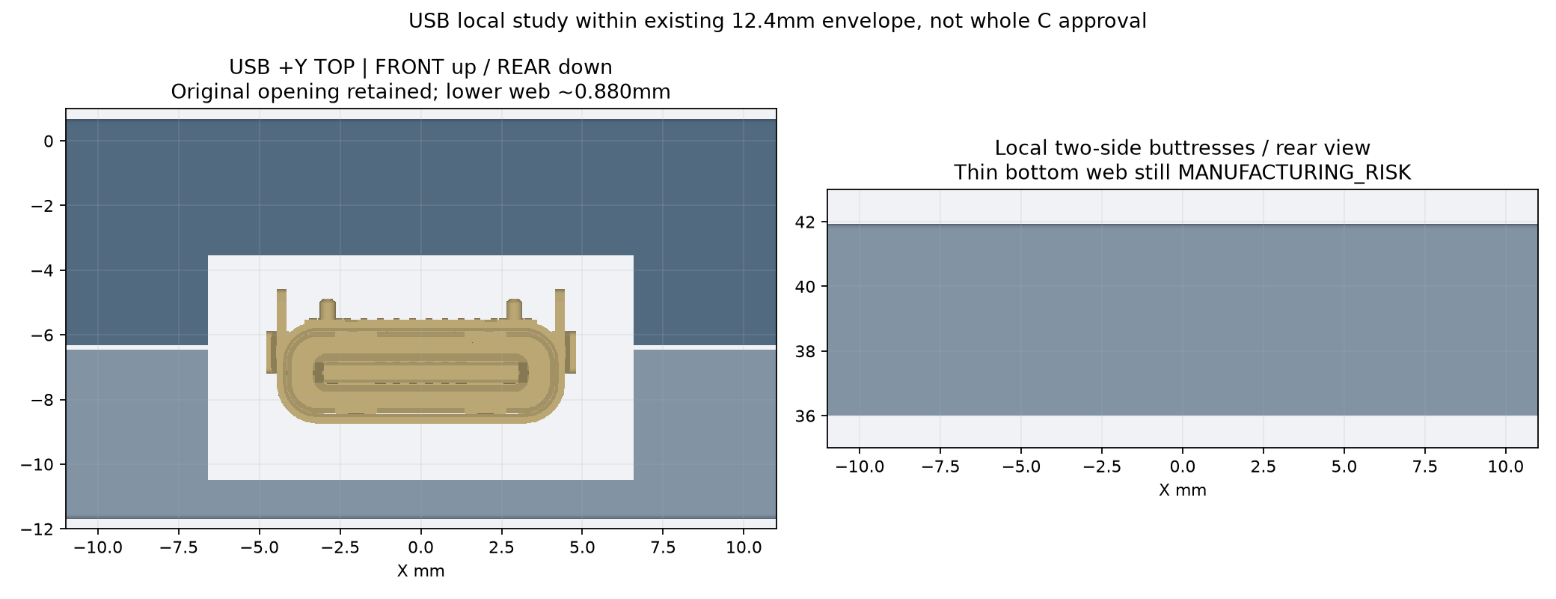
deliverables/t0-c/usb_local.png
