Gadil123/esp32-design/deliverables/t0-g-v1-boot-rect/BOOT_complete_module_insertion.png

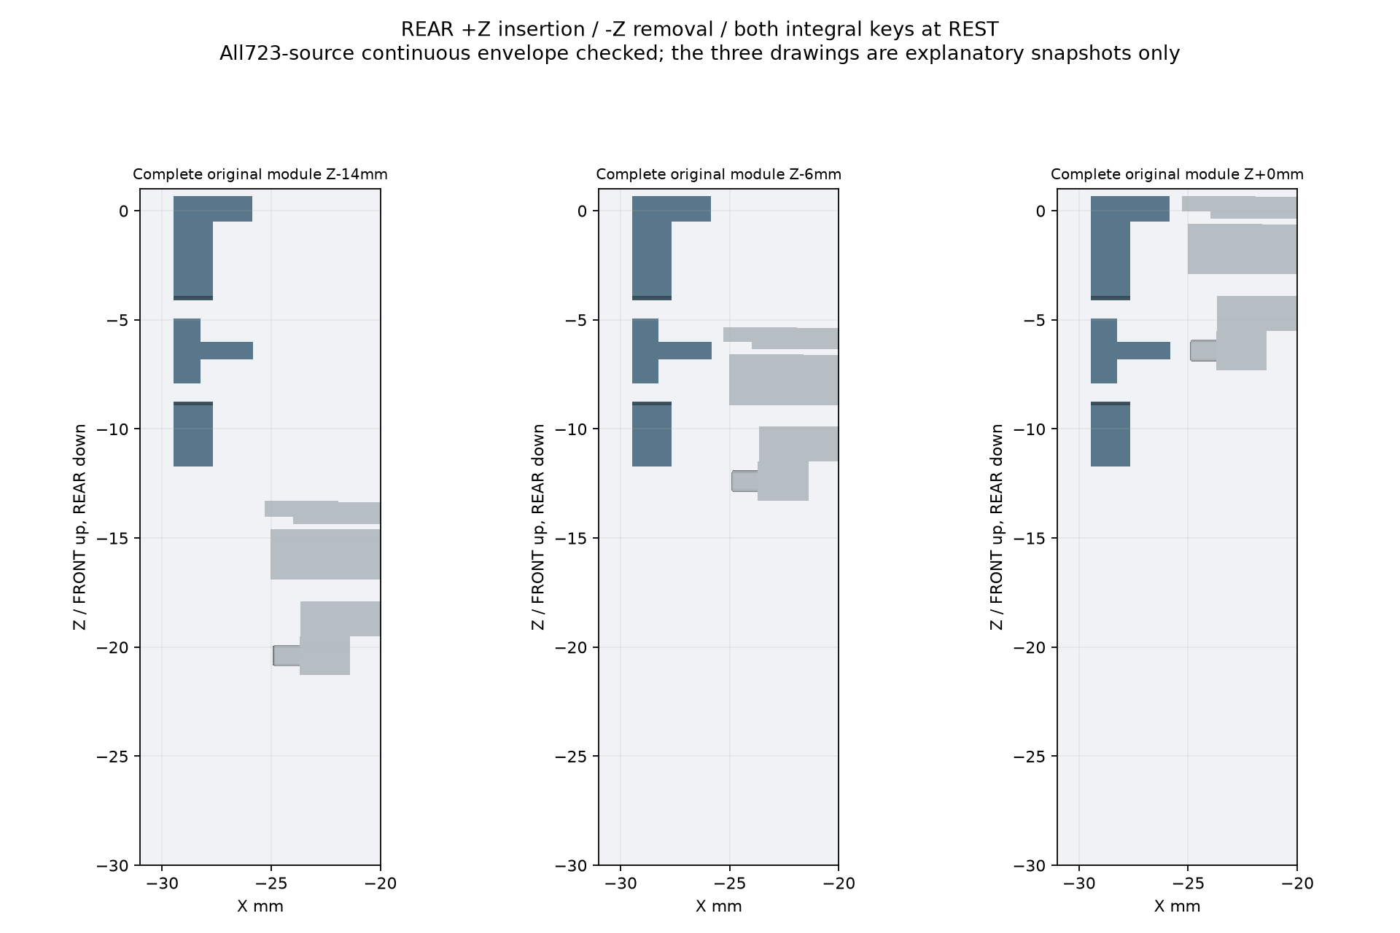
deliverables/t0-g-v1-boot-rect/BOOT_complete_module_insertion.png
