Gadil123/esp32-design/deliverables/t0-g-v1-boot-rect/BOOT_states_and_return_section.png

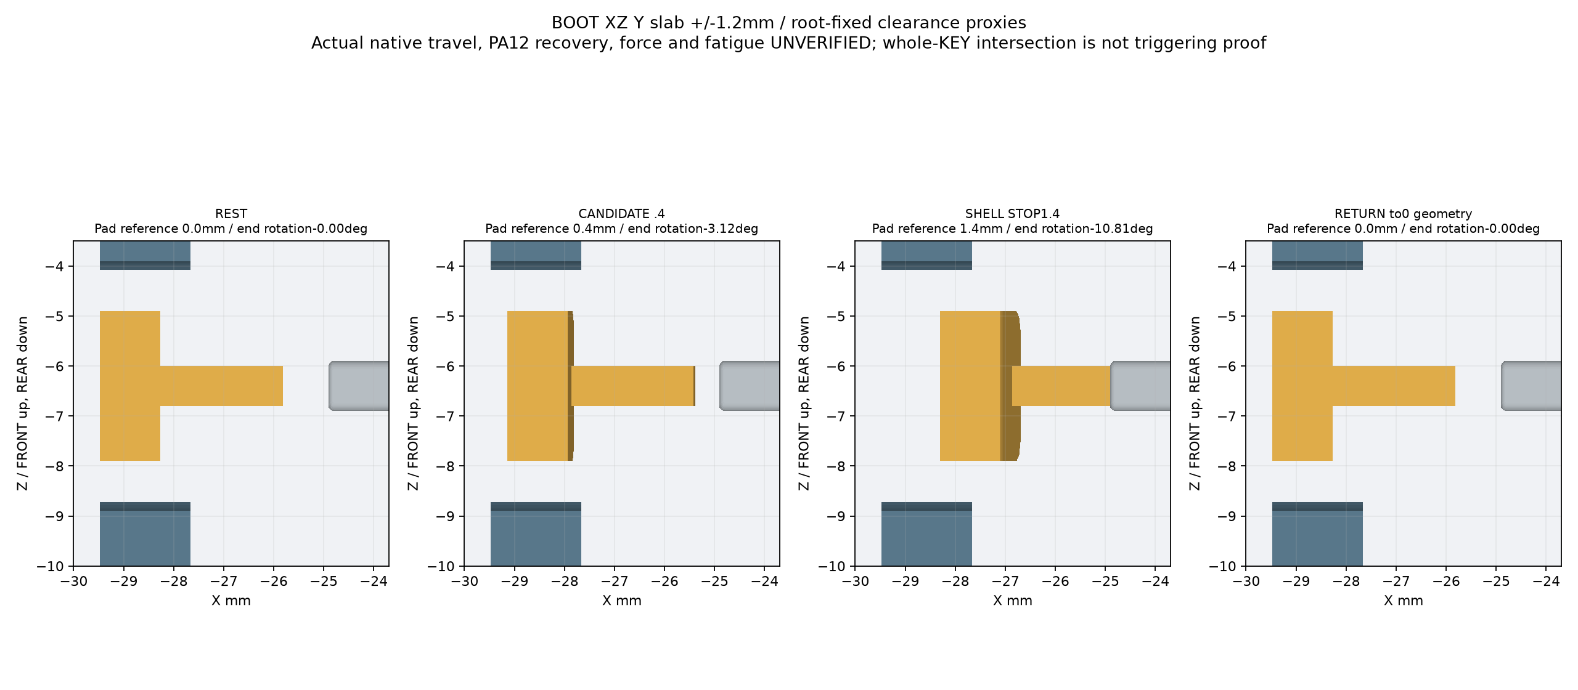
deliverables/t0-g-v1-boot-rect/BOOT_states_and_return_section.png
