Gadil123/esp32-design/deliverables/t0-g-v1-gate/E_vs_G_V1_gate_same_scale.png

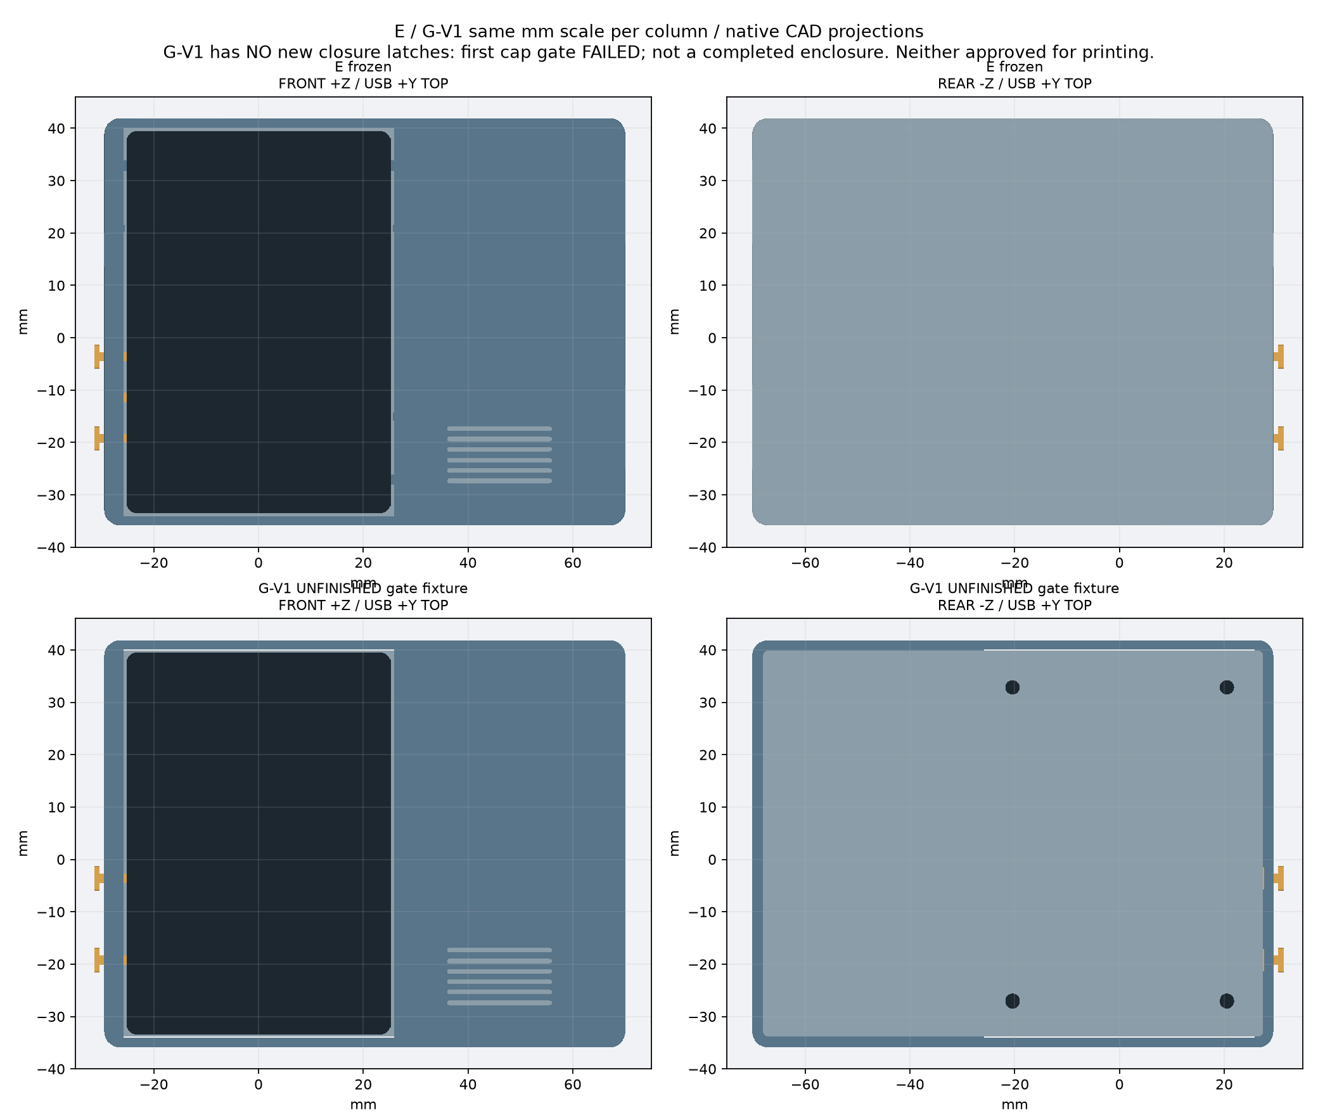
deliverables/t0-g-v1-gate/E_vs_G_V1_gate_same_scale.png
