Gadil123/esp32-design/deliverables/t0-g-v1-gate/flush_gate_section.png

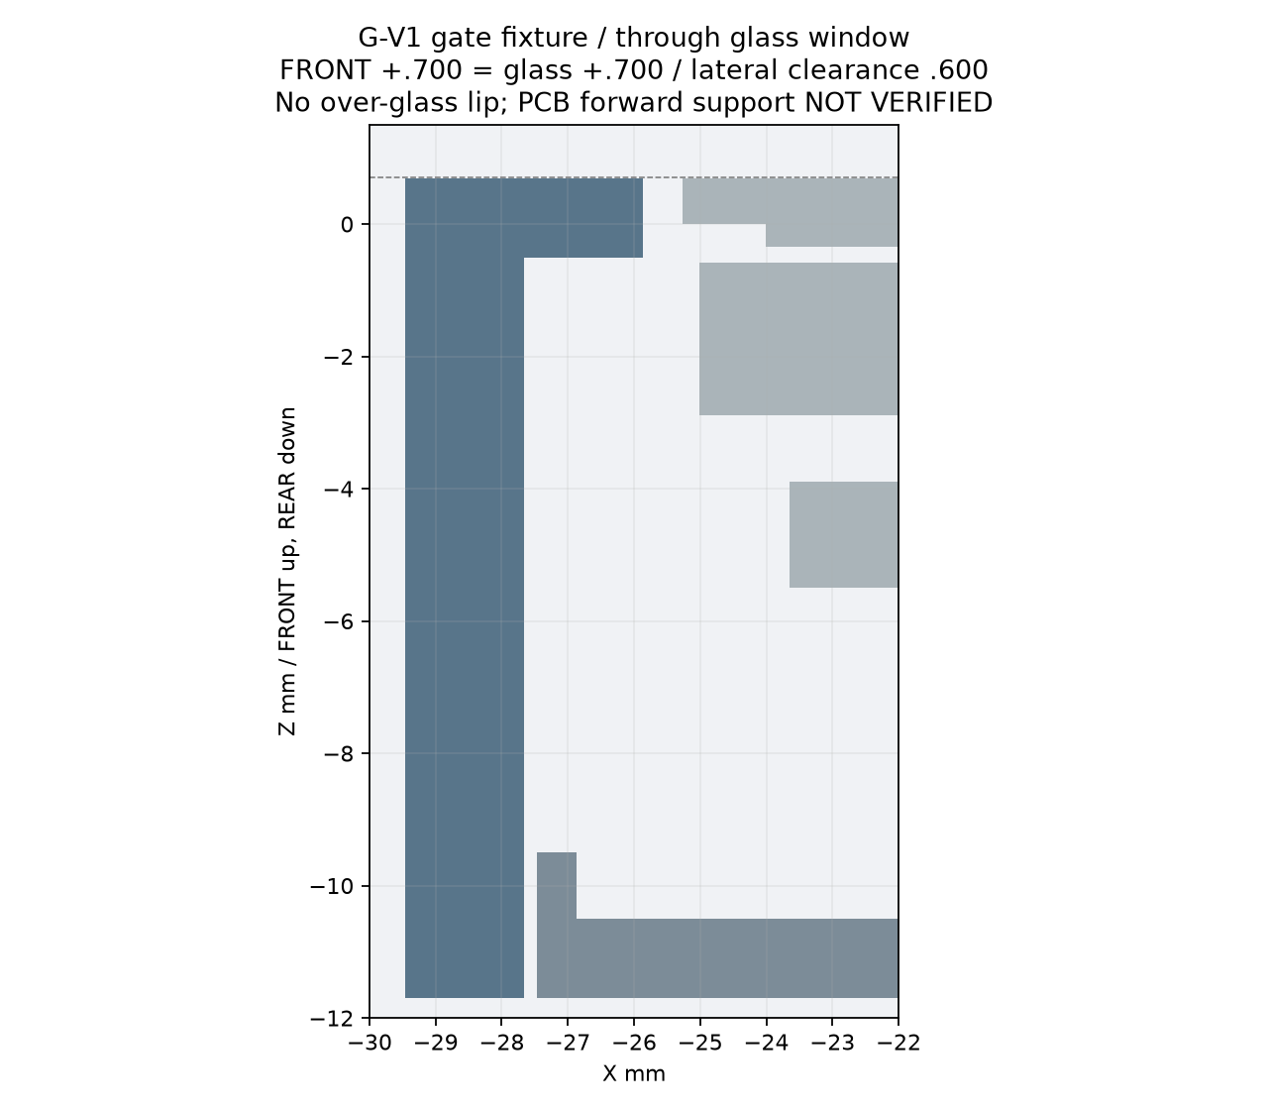
deliverables/t0-g-v1-gate/flush_gate_section.png
