Gadil123/esp32-design/deliverables/t0-g-v1-gate/preliminary_screw_section.png

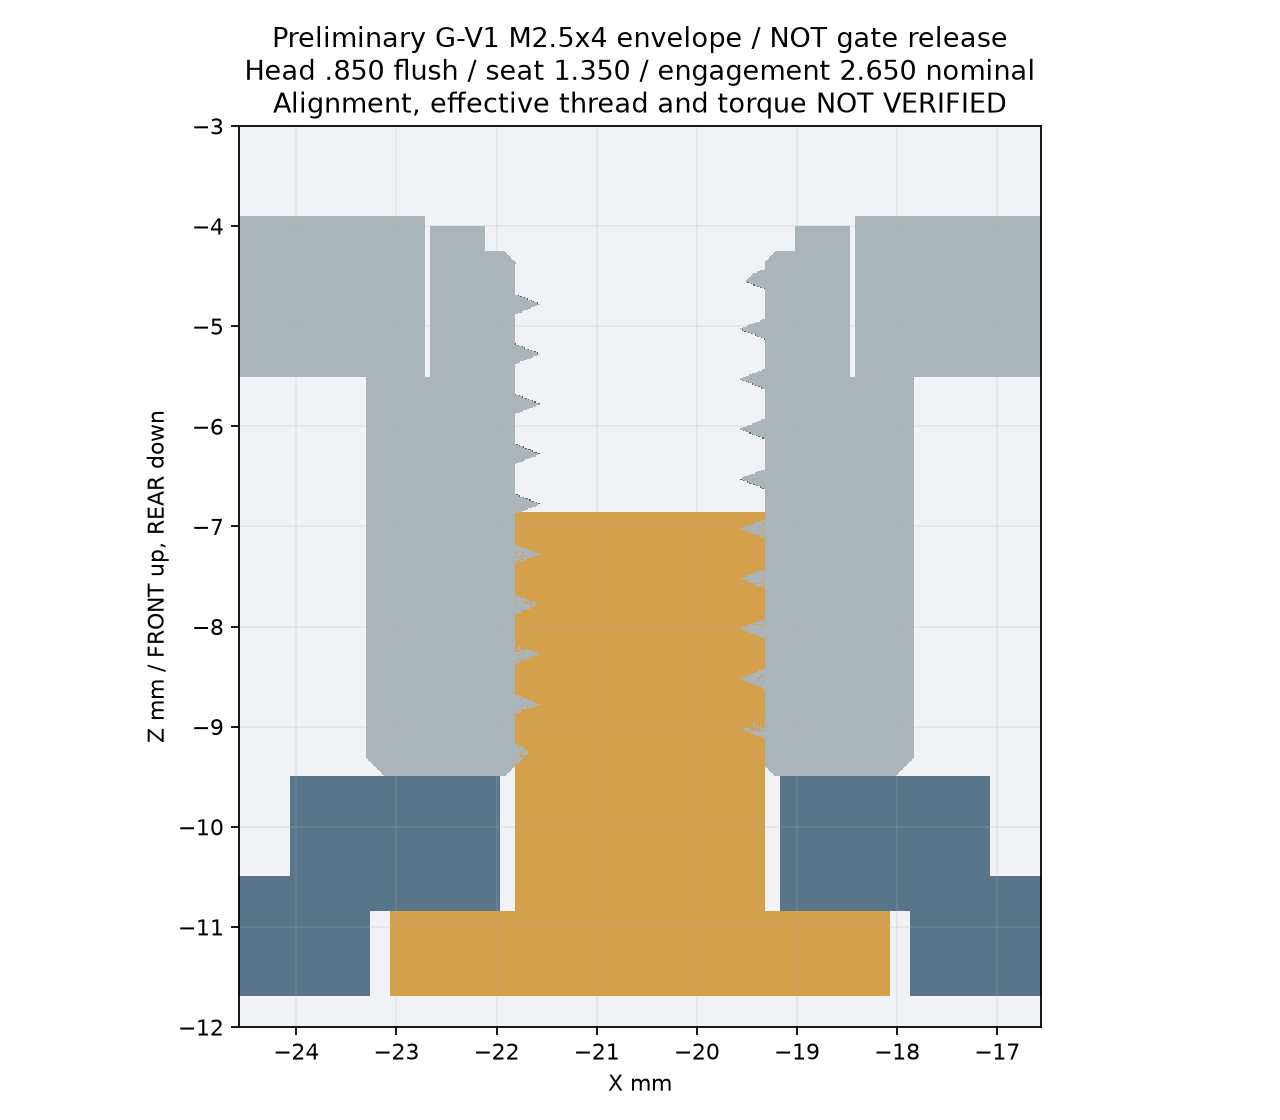
deliverables/t0-g-v1-gate/preliminary_screw_section.png
