Gadil123/esp32-design/deliverables/t0-g-v1-integrated/complete_module_insertion.png

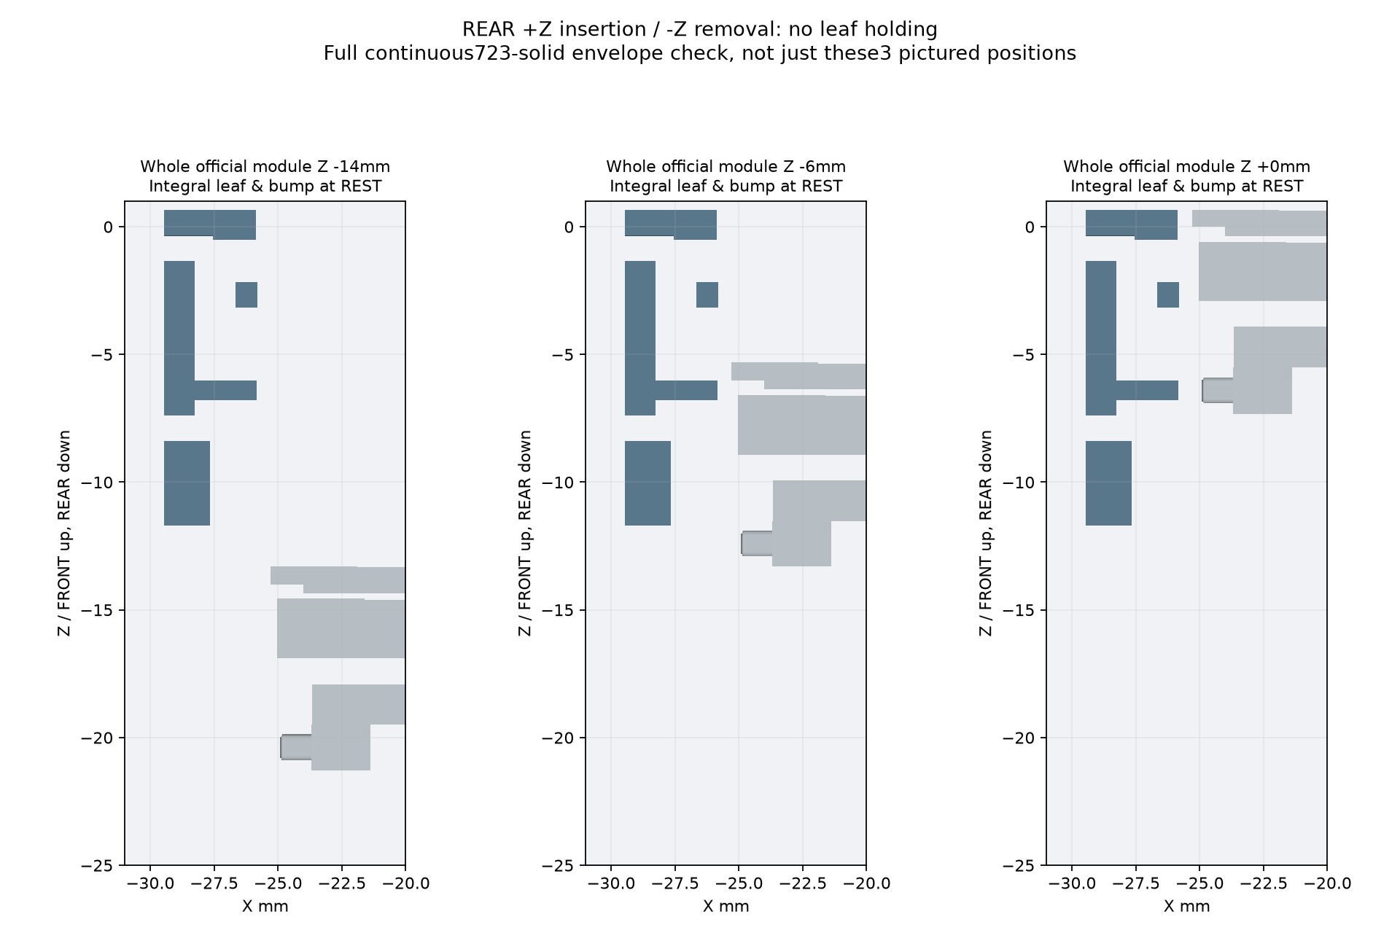
deliverables/t0-g-v1-integrated/complete_module_insertion.png
