Gadil123/esp32-design/deliverables/t0-g-v1-integrated/integral_key_layout_LEFT.png

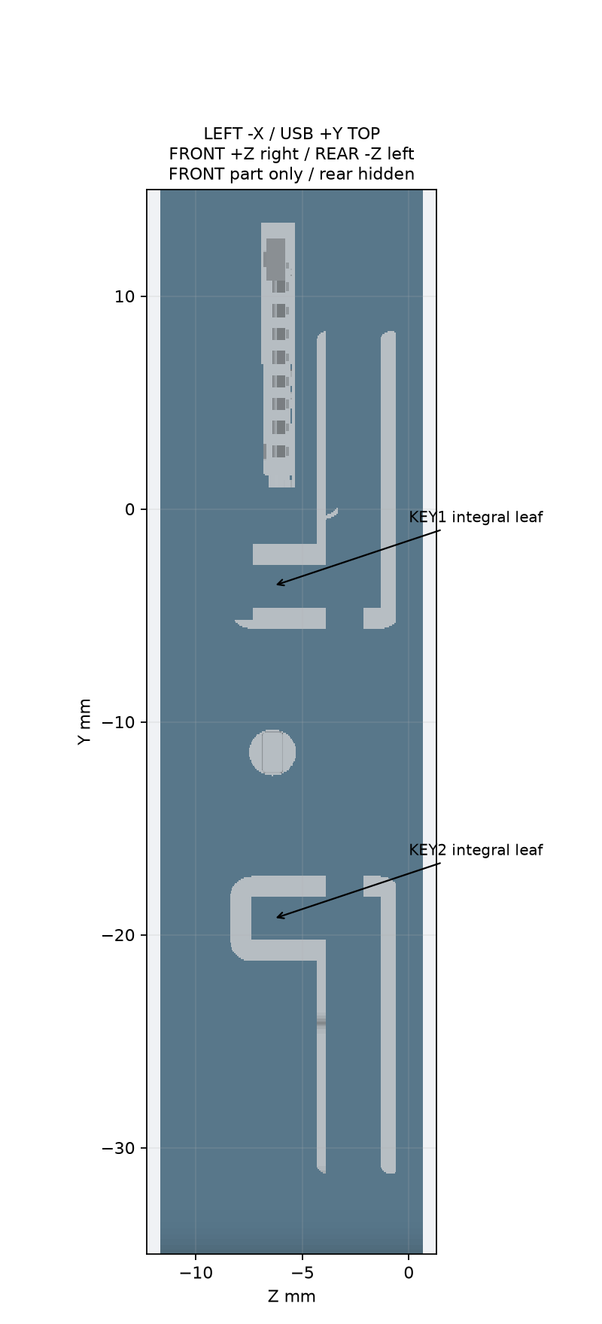
deliverables/t0-g-v1-integrated/integral_key_layout_LEFT.png
