Gadil123/esp32-design/deliverables/t0-g-v1-integrated/key1_tolerance_reach.png

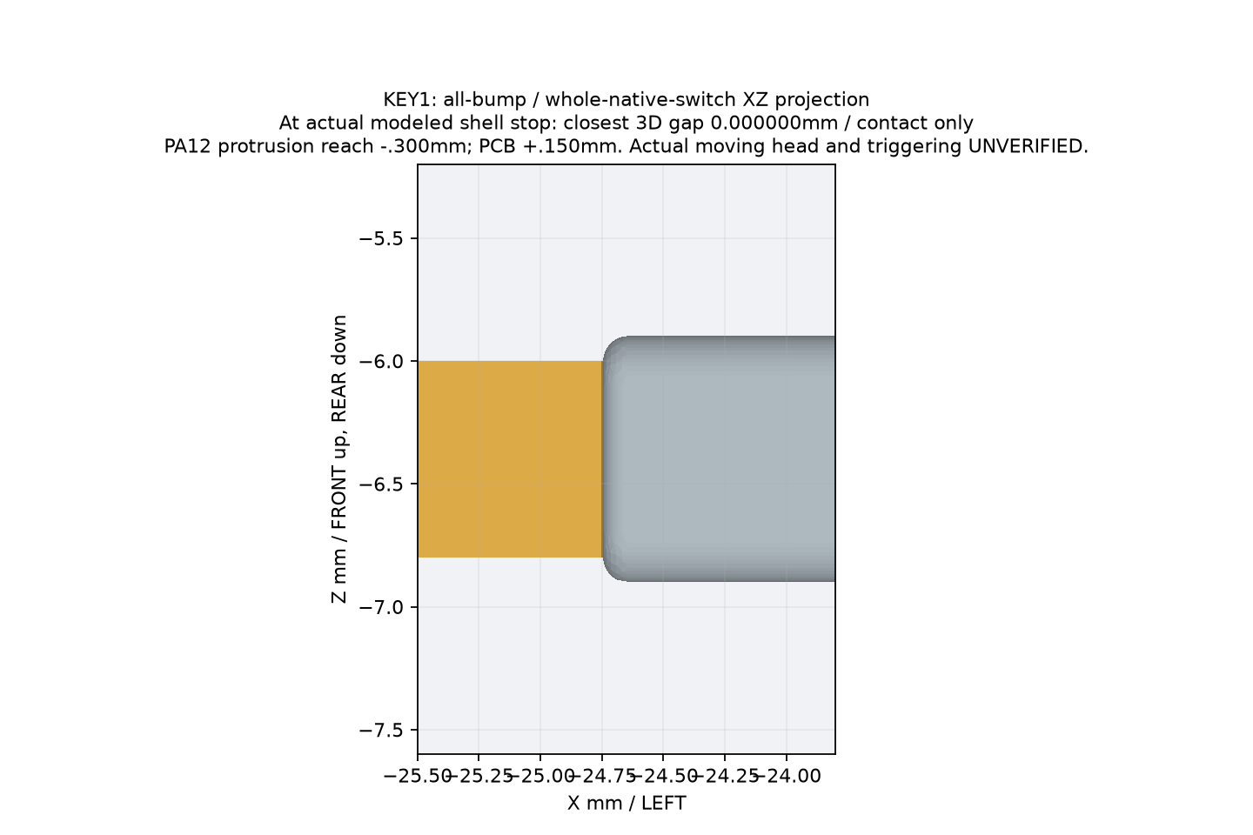
deliverables/t0-g-v1-integrated/key1_tolerance_reach.png
