Gadil123/esp32-design/deliverables/t0-g-v1-integrated/root_and_wall_sections.png

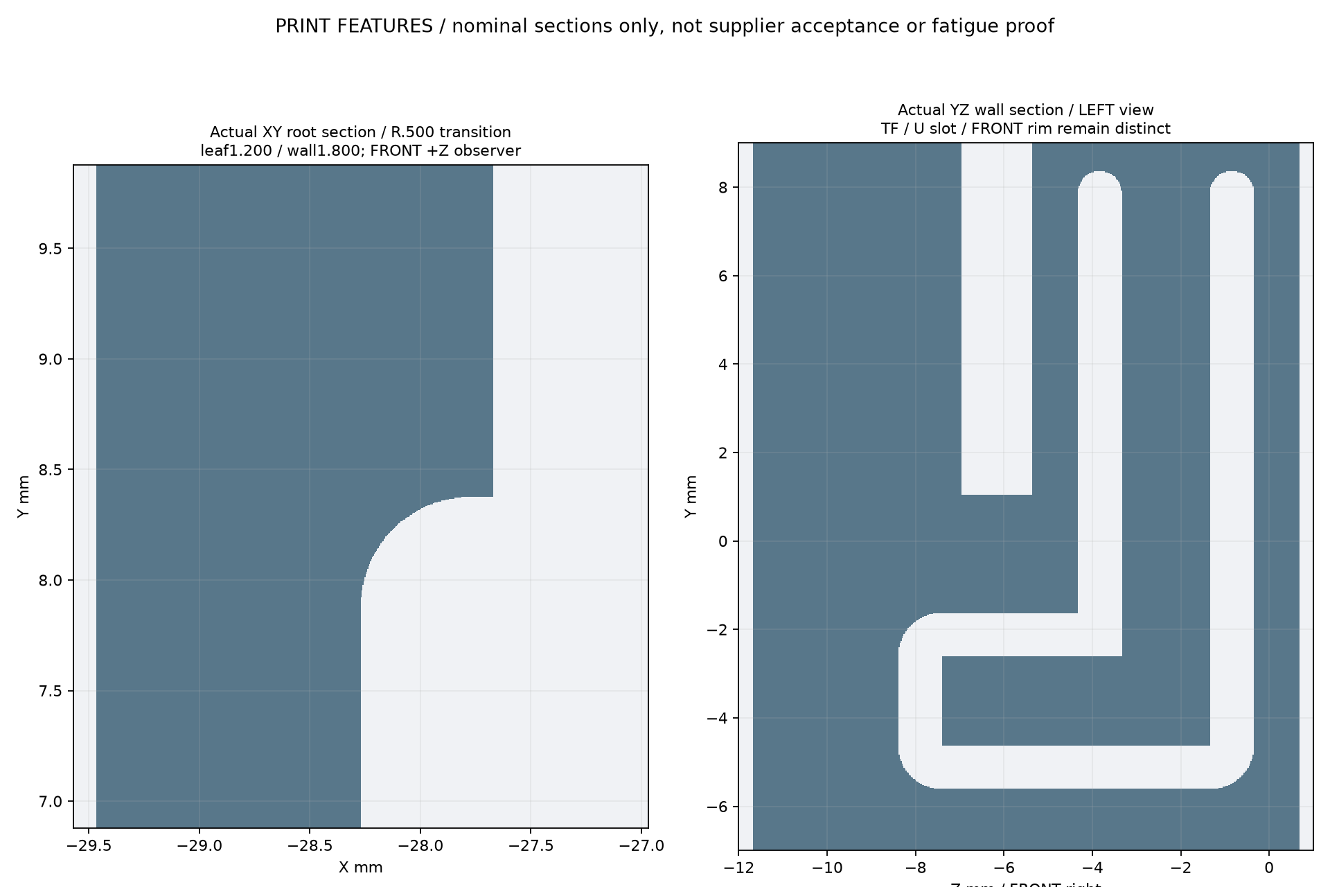
deliverables/t0-g-v1-integrated/root_and_wall_sections.png
