Gadil123/esp32-design/deliverables/t0-g-v1/connector_and_accessory_layout.png

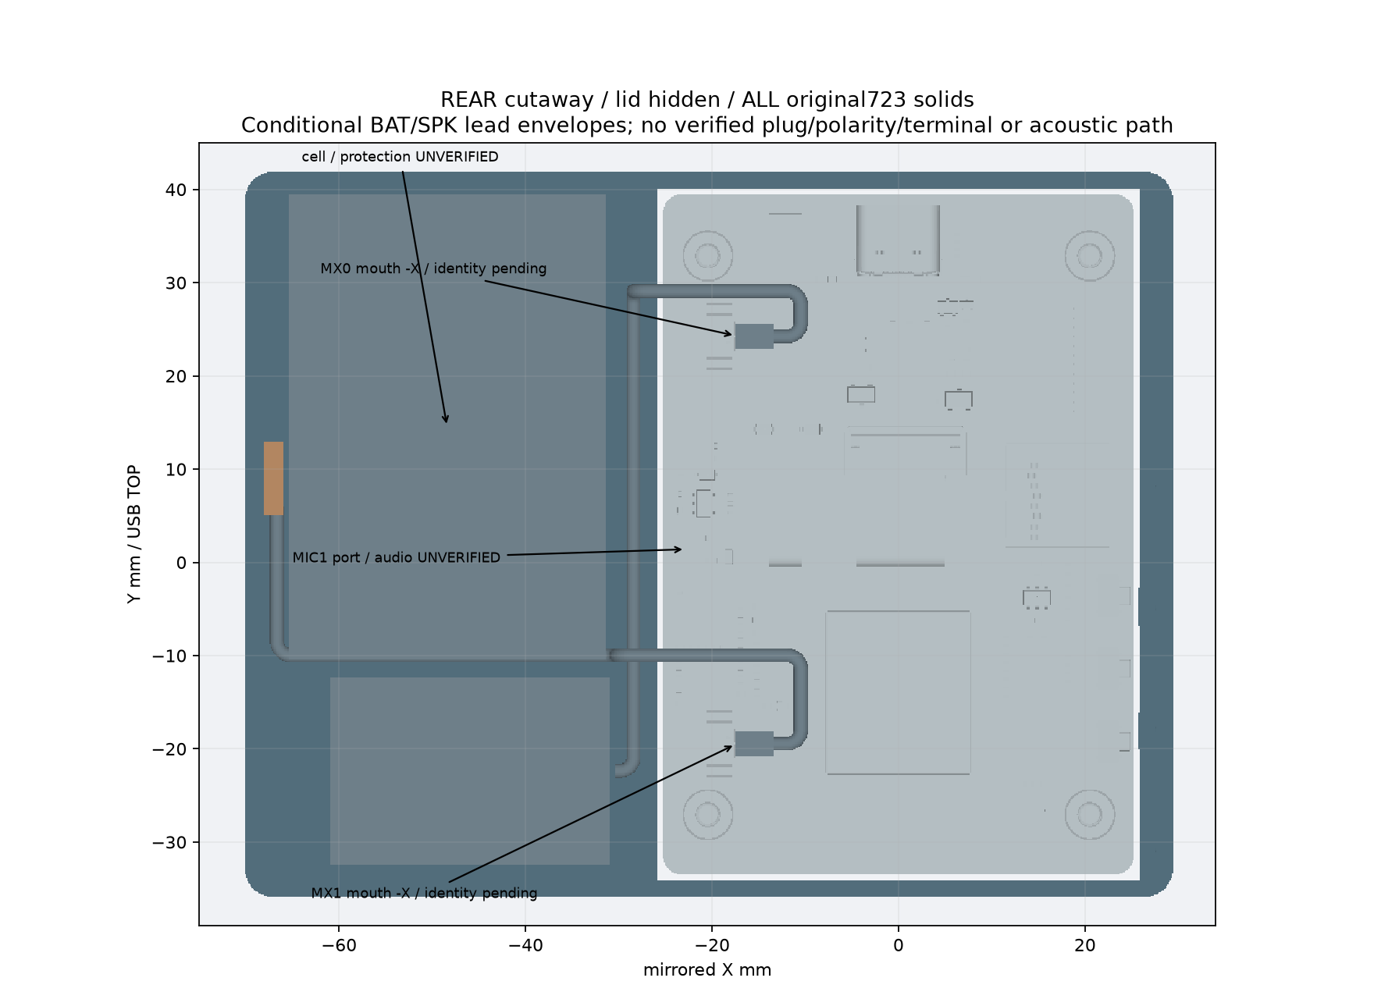
deliverables/t0-g-v1/connector_and_accessory_layout.png
