Gadil123/esp32-design/deliverables/t0-g-v1/flush_and_thickness_sections.png

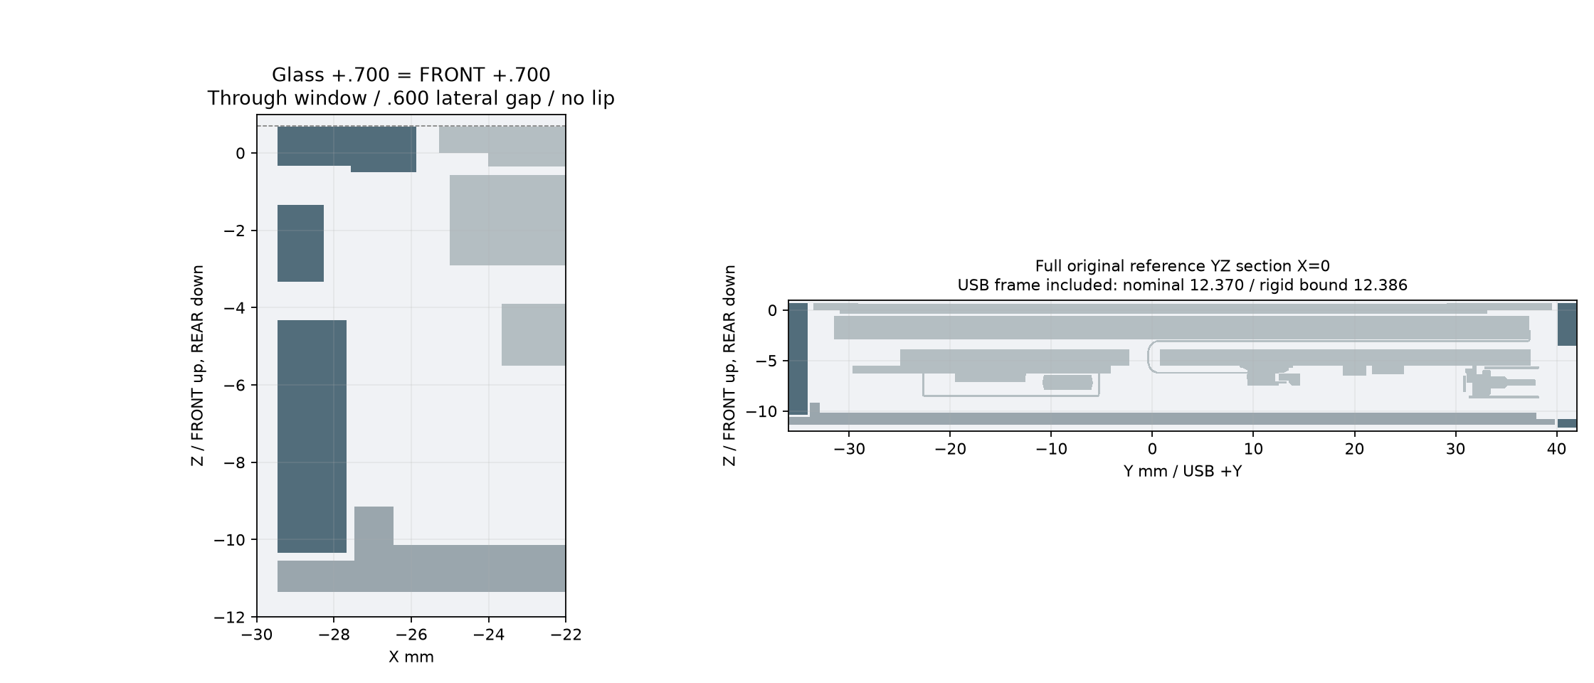
deliverables/t0-g-v1/flush_and_thickness_sections.png
