Gadil123/esp32-design/deliverables/t0-g-v1/four_screw_load_section.png

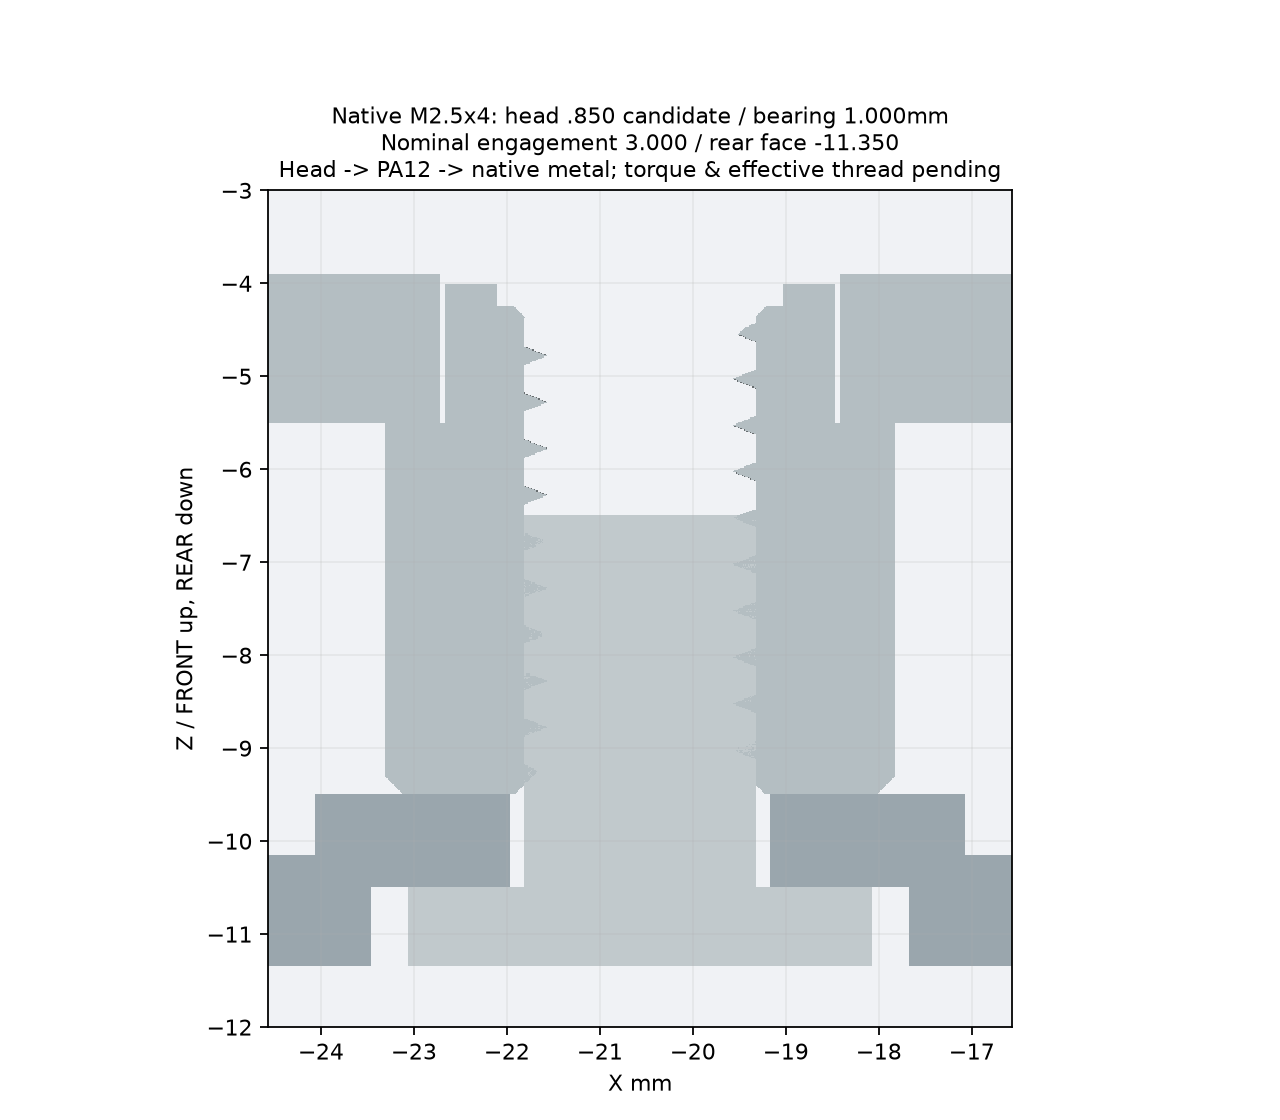
deliverables/t0-g-v1/four_screw_load_section.png
