Gadil123/esp32-design/deliverables/t0-g-v1/native_interfaces.png

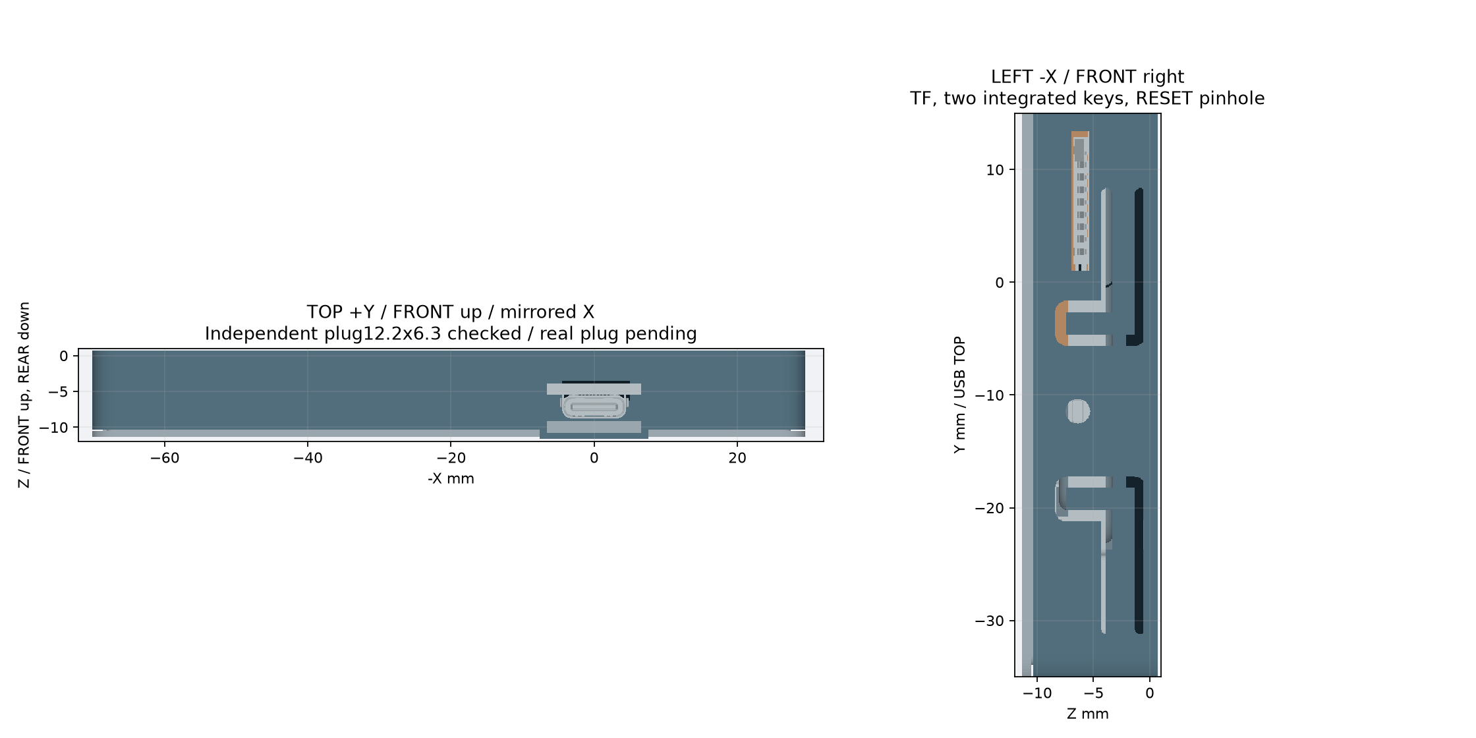
deliverables/t0-g-v1/native_interfaces.png
