Gadil123/esp32-design/deliverables/t0-g-v1/shallow_latch_sections.png

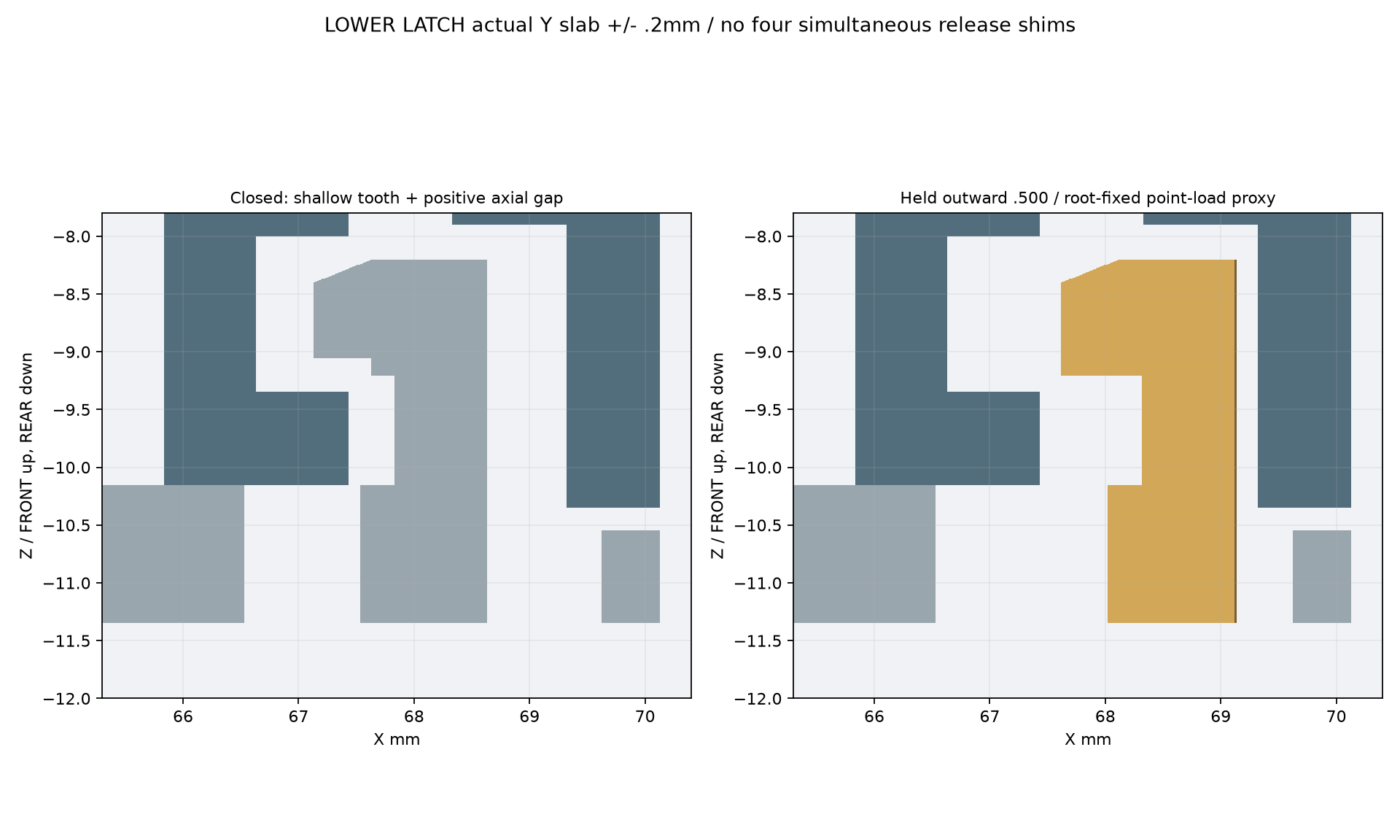
deliverables/t0-g-v1/shallow_latch_sections.png
