Gadil123/esp32-design/deliverables/t0-g-v1/single_pick_opening_sequence.png

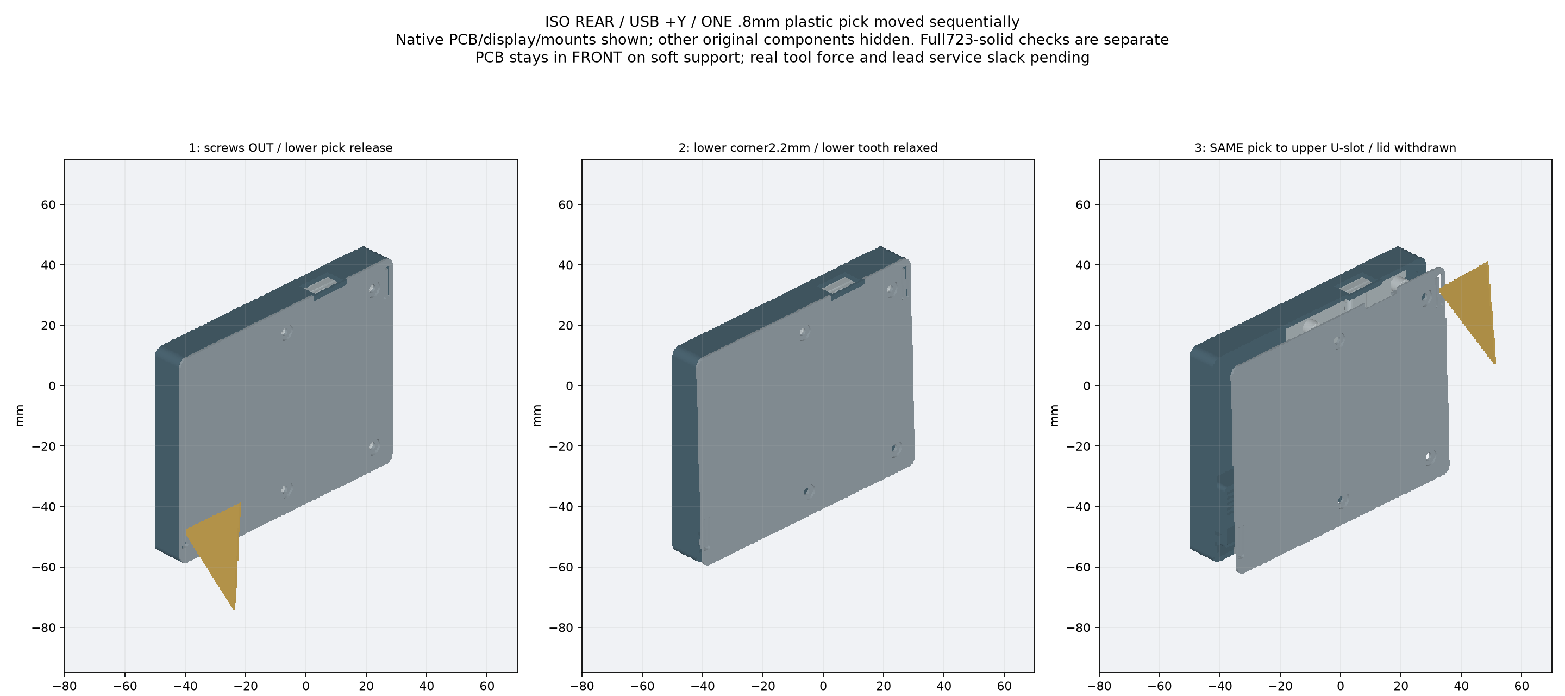
deliverables/t0-g-v1/single_pick_opening_sequence.png
