Gadil123/esp32-design/deliverables/t0-g/connector_and_bay_layout.png

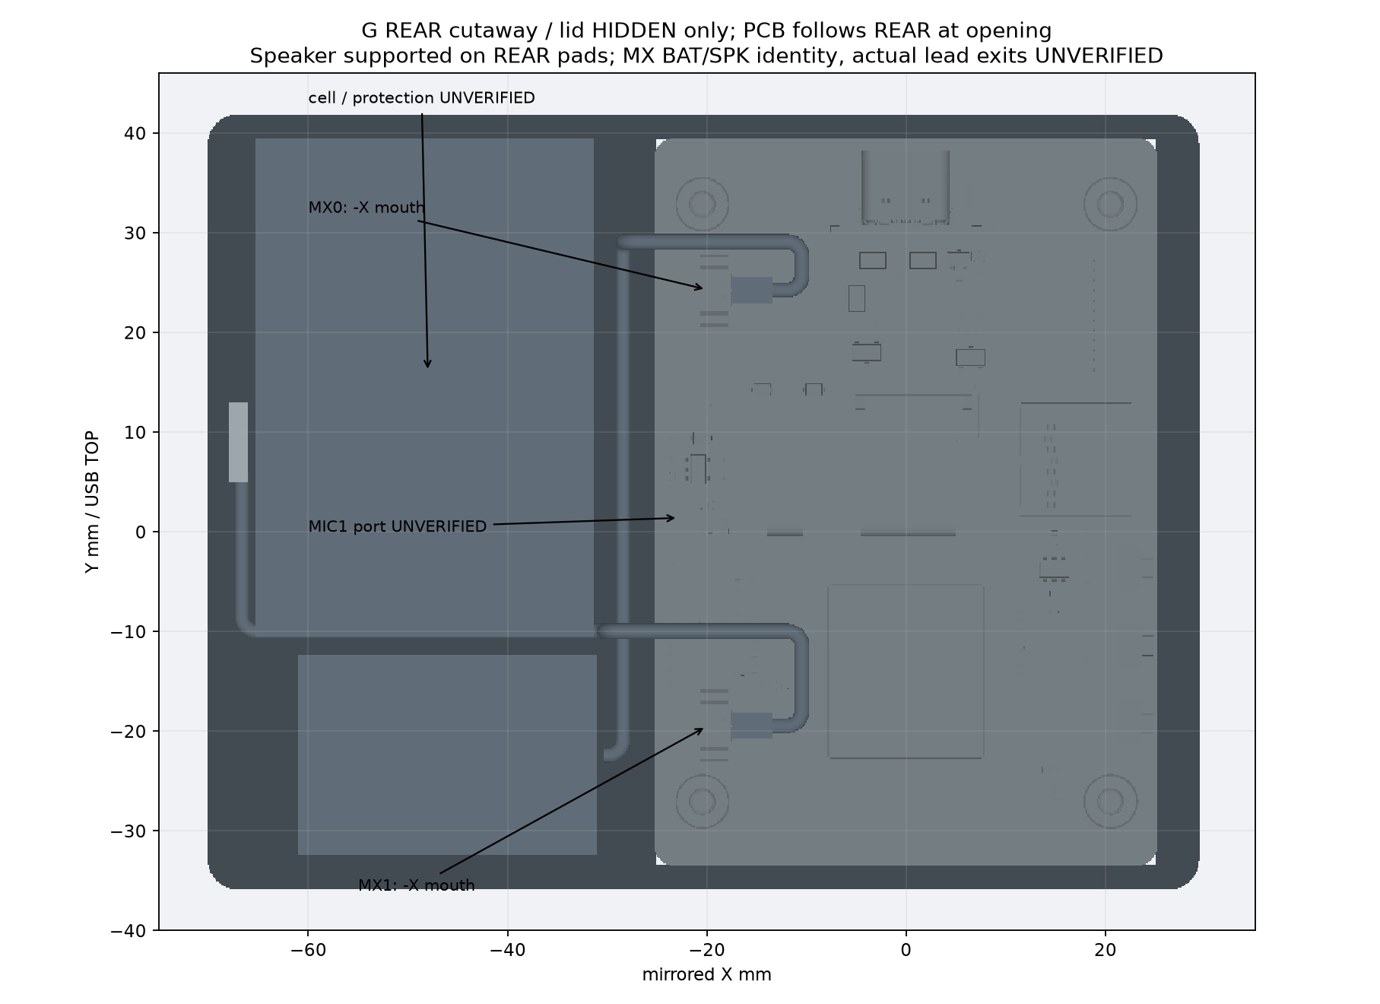
deliverables/t0-g/connector_and_bay_layout.png
