Gadil123/esp32-design/deliverables/t0-g/iso_front.png

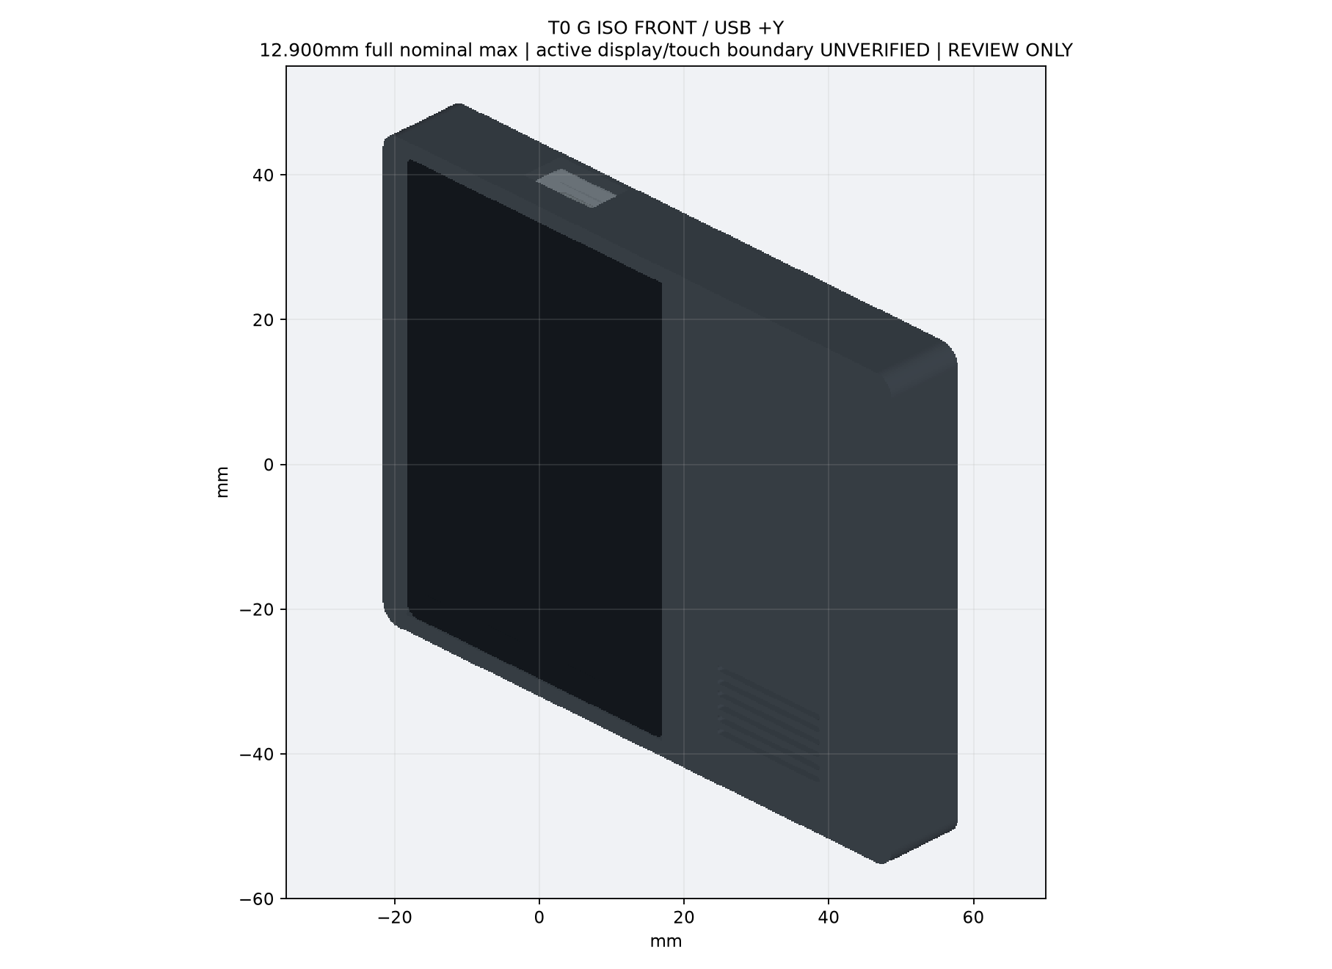
deliverables/t0-g/iso_front.png
