Gadil123/esp32-design/deliverables/t0-g/rear_shim_lane.png

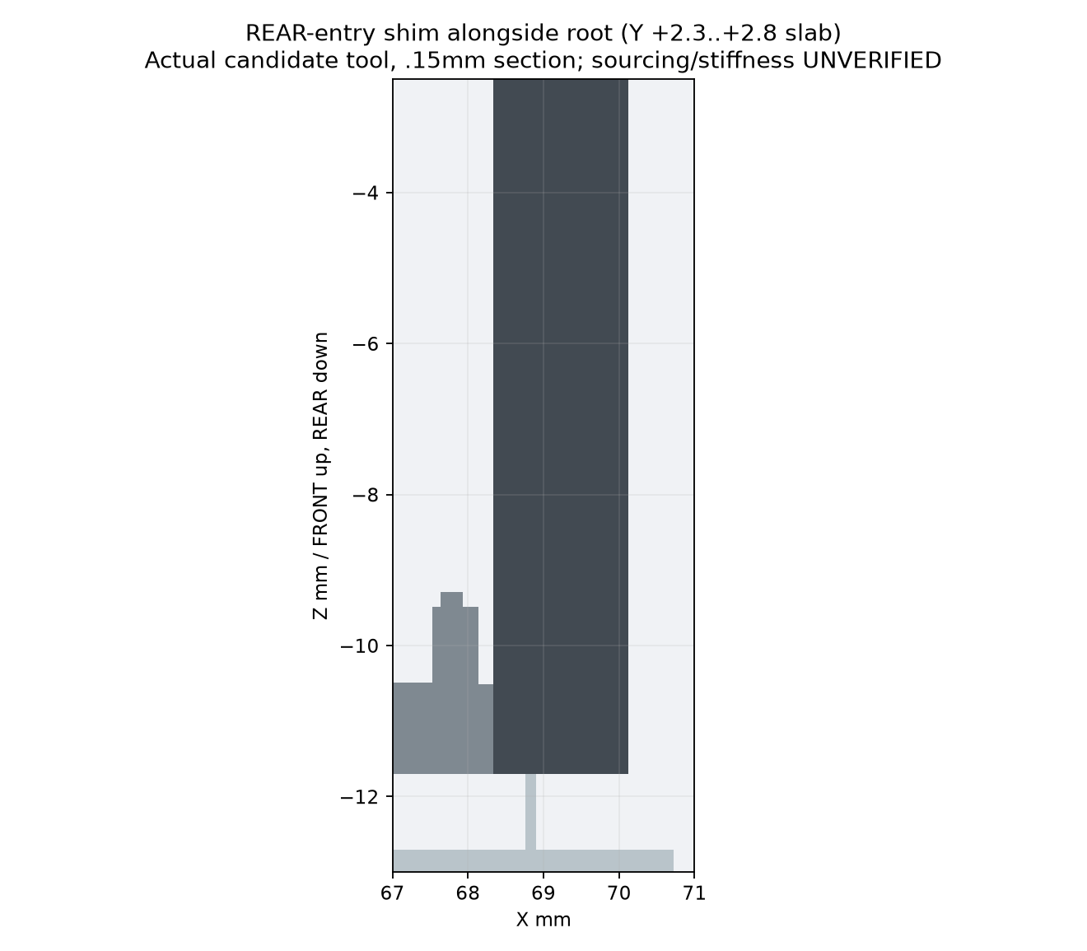
deliverables/t0-g/rear_shim_lane.png
