Gadil123/esp32-design/deliverables/t0-a/12mm/assembly_light.step

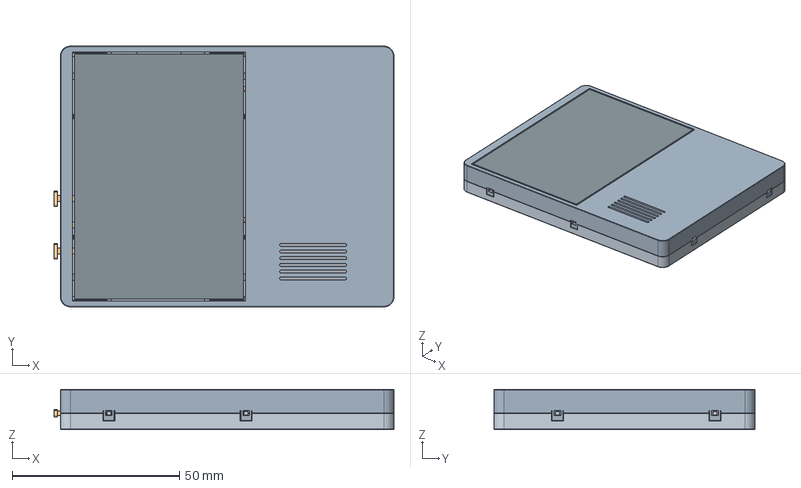
[picture p65: CAD file, 2026-10-17]
deliverables/t0-a/12mm/assembly_light.step
101.5 x 77.9 x 12.0 mm
DISPLAY_ENVELOPE_NOT_DETAIL
J2_USB_SIDE_ENVELOPE_NOT_DETAIL
KEY1_ENVELOPE_NOT_DETAIL
KEY2_ENVELOPE_NOT_DETAIL
KEY3_ENVELOPE_NOT_DETAIL
MIC1_ENVELOPE_NOT_DETAIL
FRONT_T0_FLUSH
REAR_T0_1_2mm
KEY1_CAP_TRAVEL_UNVERIFIED
KEY2_CAP_TRAVEL_UNVERIFIED
KEY3_CAP_TRAVEL_UNVERIFIED
BATTERY_UNVERIFIED
SPEAKER_UNVERIFIED
FOAM_UNVERIFIED
DAMPING_UNVERIFIED
ADHESIVE_UNVERIFIED
PROTECTION_UNVERIFIED
MX0_PLUG_UNVERIFIED
MX1_PLUG_UNVERIFIED
MX0_WIRE_0_UNVERIFIED
MX1_WIRE_0_UNVERIFIED
