Gadil123/esp32-design/deliverables/t0-e/assembly_light.step

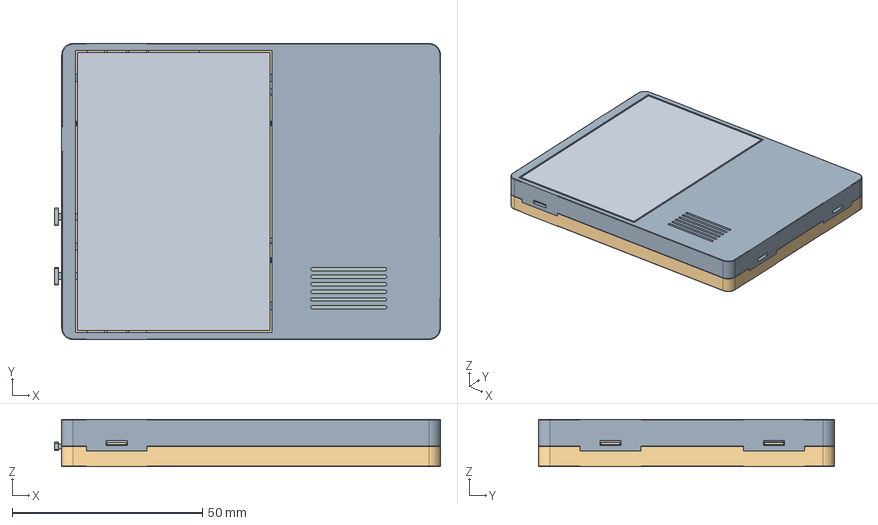
[picture p66: CAD file, 2026-10-17]
deliverables/t0-e/assembly_light.step
101.5 x 77.9 x 12.4 mm
DISPLAY_REFERENCE_ENVELOPE
J2_USB_SIDE_REFERENCE_ENVELOPE
KEY1_REFERENCE_ENVELOPE
KEY2_REFERENCE_ENVELOPE
KEY3_REFERENCE_ENVELOPE
MIC1_REFERENCE_ENVELOPE
front_T0_E
rear_T0_E
KEY1_UNVERIFIED
KEY2_UNVERIFIED
KEY3_UNVERIFIED
battery_UNVERIFIED
speaker_UNVERIFIED
protection_UNVERIFIED
adhesive_UNVERIFIED
foam_UNVERIFIED
damping_UNVERIFIED
MX0_UNVERIFIED
MX1_UNVERIFIED
MX0_wire_0_UNVERIFIED
MX1_wire_0_UNVERIFIED
