Gadil123/esp32-design/deliverables/t0-g-v1-boot-rect/assembly_light.step

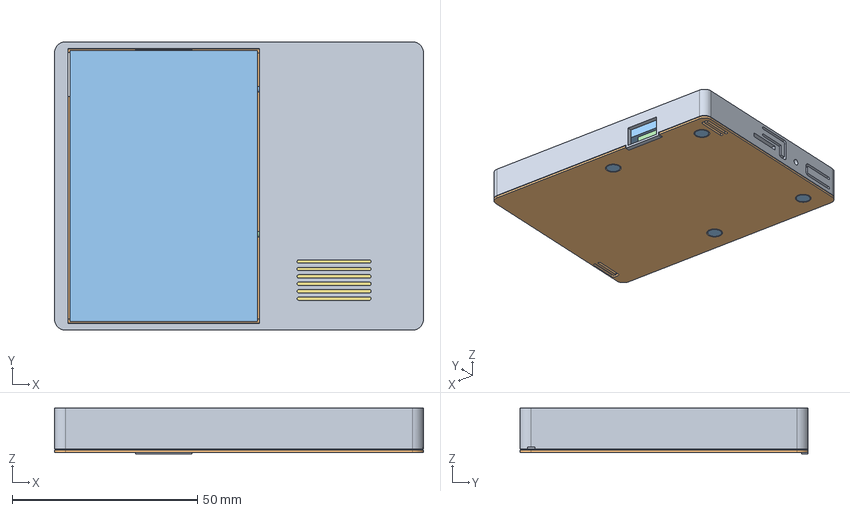
[picture p67: CAD file, 2026-10-17]
deliverables/t0-g-v1-boot-rect/assembly_light.step
99.6 x 77.9 x 12.4 mm
DISPLAY_PROXY_NOT_FOR_CLEARANCE
J2_USB_SIDE_PROXY_NOT_FOR_CLEARANCE
KEY1_PROXY_NOT_FOR_CLEARANCE
KEY2_PROXY_NOT_FOR_CLEARANCE
KEY3_PROXY_NOT_FOR_CLEARANCE
TF_PROXY_NOT_FOR_CLEARANCE
MIC1_PROXY_NOT_FOR_CLEARANCE
MX0_PROXY_NOT_FOR_CLEARANCE
MX1_PROXY_NOT_FOR_CLEARANCE
FrontShell_BOOT_RECT_BAT_PWR_L
RearShell_UNCHANGED
Four_M2_5_CANDIDATE_SCREWS
UNVERIFIED_ACCESSORIES_PLUGS_WIRES
