Gadil123/esp32-design/deliverables/t0-g/assembly_light.step

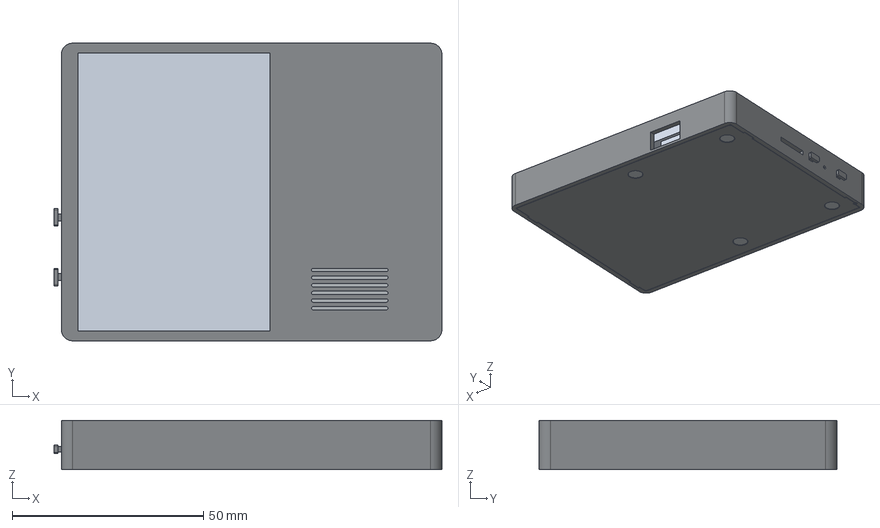
[picture p68: CAD file, 2026-10-17]
deliverables/t0-g/assembly_light.step
101.5 x 77.9 x 12.9 mm
DISPLAY_REFERENCE_ENVELOPE
J2_USB_SIDE_REFERENCE_ENVELOPE
KEY1_REFERENCE_ENVELOPE
KEY2_REFERENCE_ENVELOPE
KEY3_REFERENCE_ENVELOPE
MIC1_REFERENCE_ENVELOPE
G_front_shell
G_rear_shell
G_key1_cap
G_key2_cap
G_key3_cap
G_screw_0
G_screw_1
G_screw_2
G_screw_3
G_battery
G_speaker
G_protection
G_adhesive
G_foam
G_damping
G_MX0
G_MX1
G_MX0_wire_0
G_MX1_wire_0
