Gadil123/esp32-design/deliverables/t0-a/key-study/key1_low_candidate.step

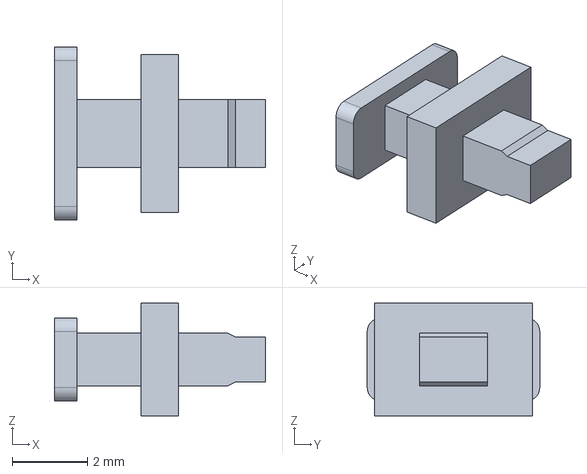
[picture p71: CAD file, 2026-10-17]
deliverables/t0-a/key-study/key1_low_candidate.step
5.63 x 4.60 x 3.00 mm
