Gadil123/esp32-design/deliverables/t0-c/coupons/RESET_hole_2_0.step

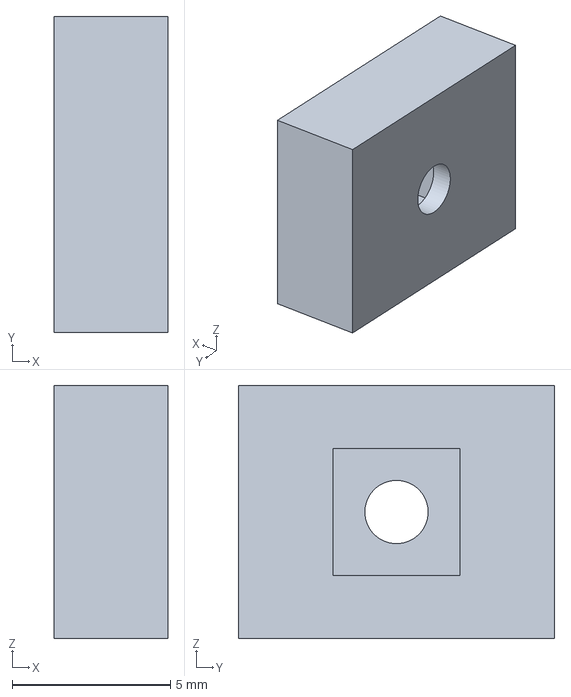
[picture p72: CAD file, 2026-10-17]
deliverables/t0-c/coupons/RESET_hole_2_0.step
3.60 x 10.0 x 8.00 mm
