Gadil123/esp32-design/deliverables/t0-c/key_fixture_0_4_context_NOT_PRINT.step

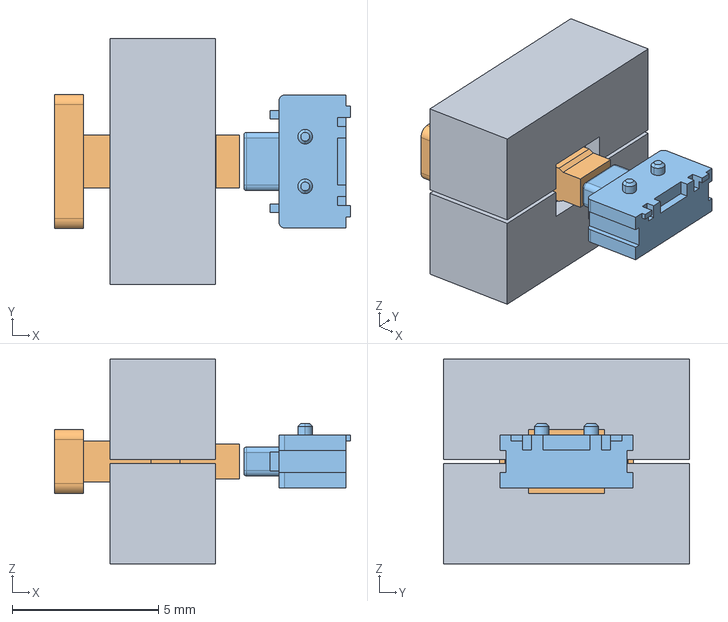
[picture p73: CAD file, 2026-10-17]
deliverables/t0-c/key_fixture_0_4_context_NOT_PRINT.step
10.1 x 8.40 x 7.00 mm
