Gadil123/esp32-design/deliverables/t0-d/D_one_short_tooth_pair_LOCAL.step

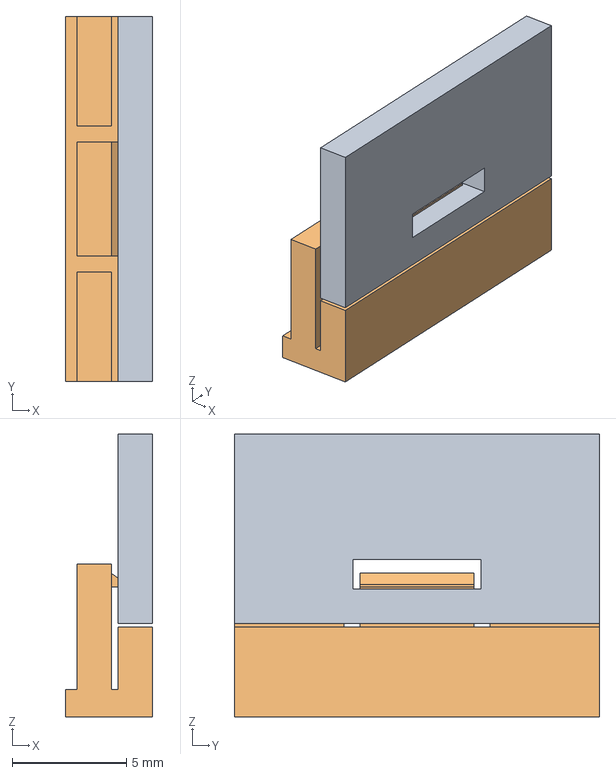
[picture p74: CAD file, 2026-10-17]
deliverables/t0-d/D_one_short_tooth_pair_LOCAL.step
3.80 x 16.0 x 12.4 mm
