Gadil123/esp32-design/deliverables/t0-g-v1-integrated/front_integrated_GATE_ONLY.step

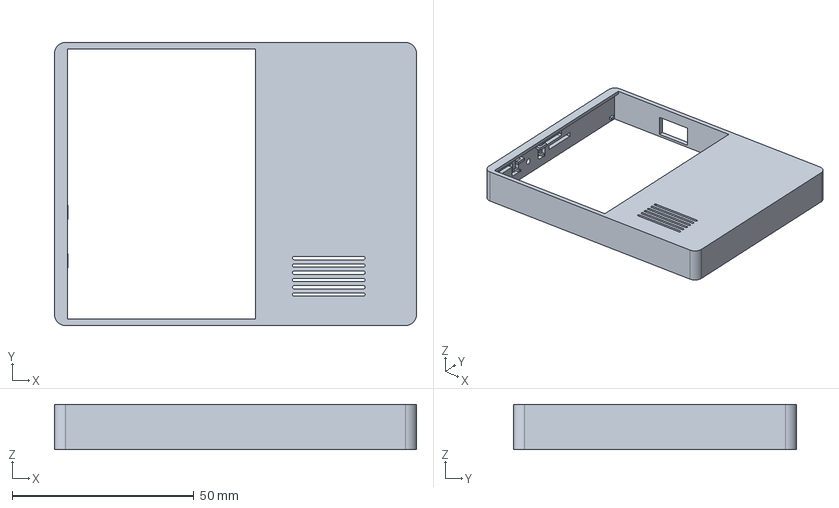
[picture p75: CAD file, 2026-10-17]
deliverables/t0-g-v1-integrated/front_integrated_GATE_ONLY.step
99.6 x 77.9 x 12.4 mm
