Gadil123/esp32-design/deliverables/t0/front_shell.step

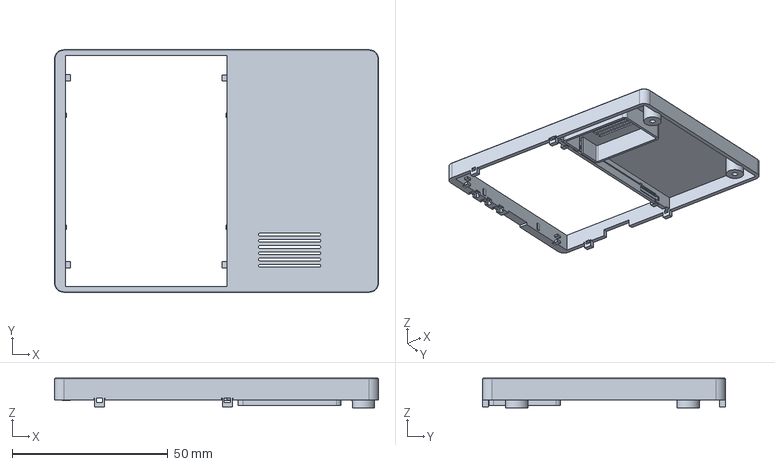
[picture p76: CAD file, 2026-10-17]
deliverables/t0/front_shell.step
104.0 x 77.9 x 9.50 mm
