Gadil123/esp32-design/deliverables/t0-a/12_4mm/front_shell.step

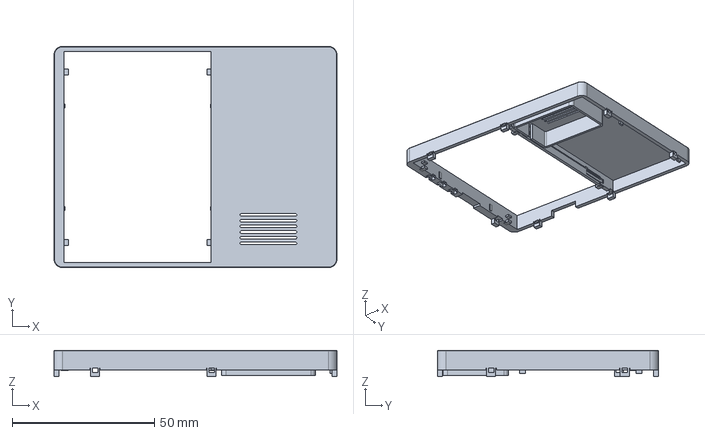
[picture p77: CAD file, 2026-10-17]
deliverables/t0-a/12_4mm/front_shell.step
99.6 x 77.9 x 9.30 mm
