Gadil123/esp32-design/deliverables/t0-d/D_four_nests_open_frame_BLOCKED.step

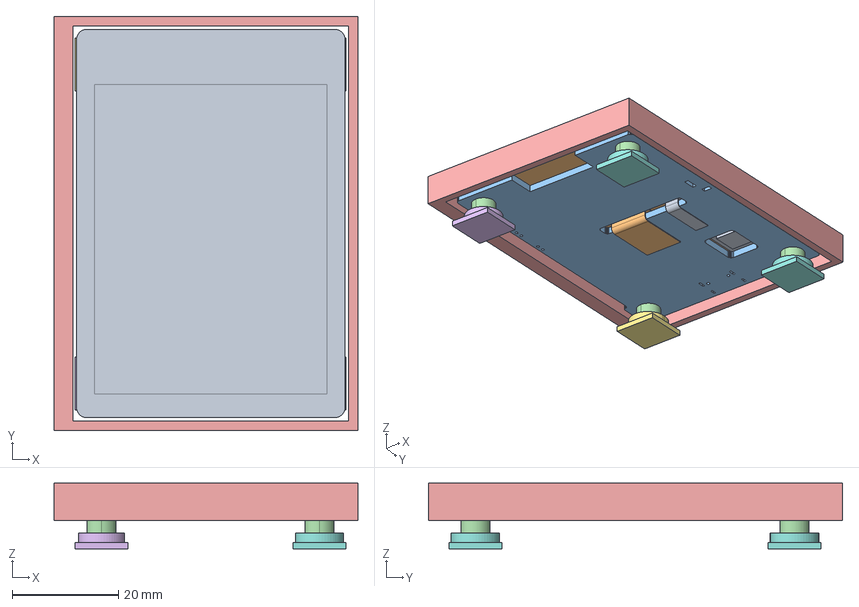
[picture p78: CAD file, 2026-10-17]
deliverables/t0-d/D_four_nests_open_frame_BLOCKED.step
57.1 x 77.9 x 12.4 mm
