Gadil123/esp32-design/deliverables/t0-e/front_shell.step

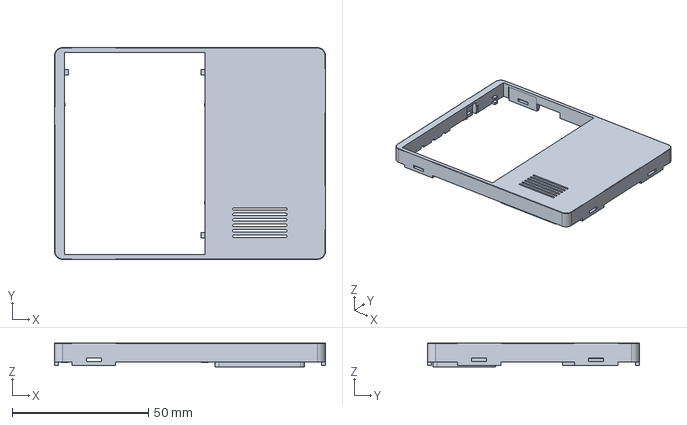
[picture p79: CAD file, 2026-10-17]
deliverables/t0-e/front_shell.step
99.6 x 77.9 x 8.80 mm
