Gadil123/esp32-design/deliverables/t0-g-v1-gate/rear_seats_GATE_ONLY.step

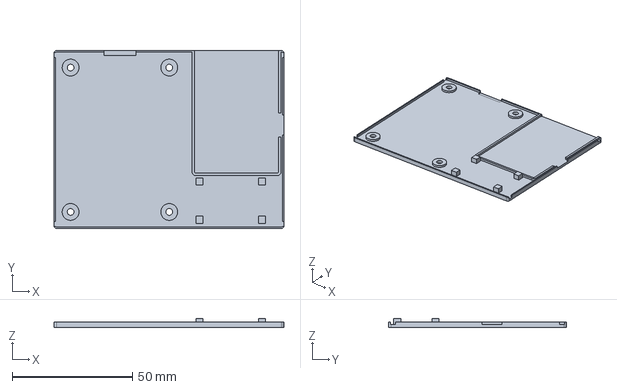
[picture p80: CAD file, 2026-10-17]
deliverables/t0-g-v1-gate/rear_seats_GATE_ONLY.step
95.6 x 73.9 x 3.60 mm
