Gadil123/esp32-design/deliverables/t0-g-v1-integrated/key1_rest_section.step

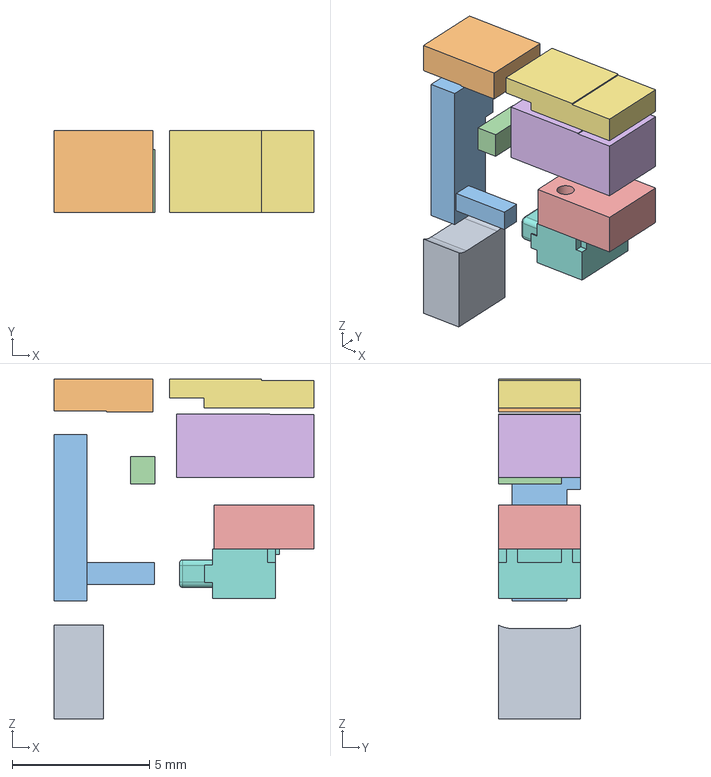
[picture p81: CAD file, 2026-10-17]
deliverables/t0-g-v1-integrated/key1_rest_section.step
9.47 x 3.00 x 12.4 mm
