Gadil123/esp32-design/deliverables/t0/rear_shell.step

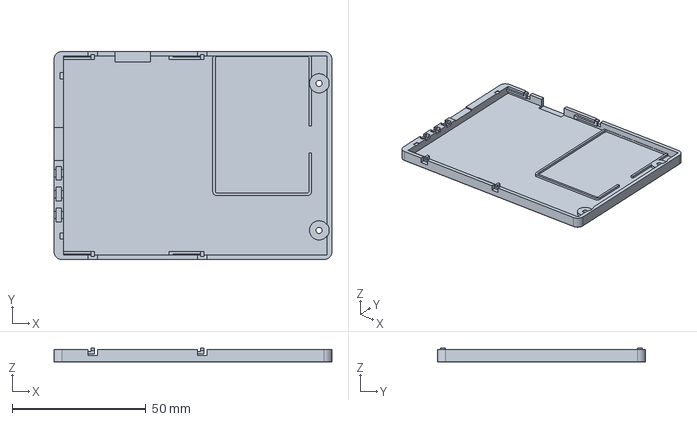
[picture p84: CAD file, 2026-10-17]
deliverables/t0/rear_shell.step
104.0 x 77.9 x 5.40 mm
