Gadil123/esp32-design/deliverables/t0-c/C1_four_mount_static_BLOCKED.step

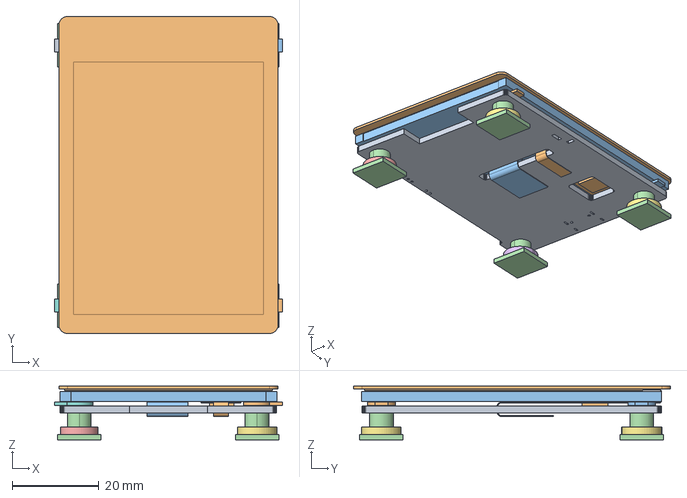
[picture p86: CAD file, 2026-10-17]
deliverables/t0-c/C1_four_mount_static_BLOCKED.step
52.6 x 73.1 x 12.4 mm
