Gadil123/esp32-design/deliverables/t0-c/coupons/shell_snap_REAR_beam.step

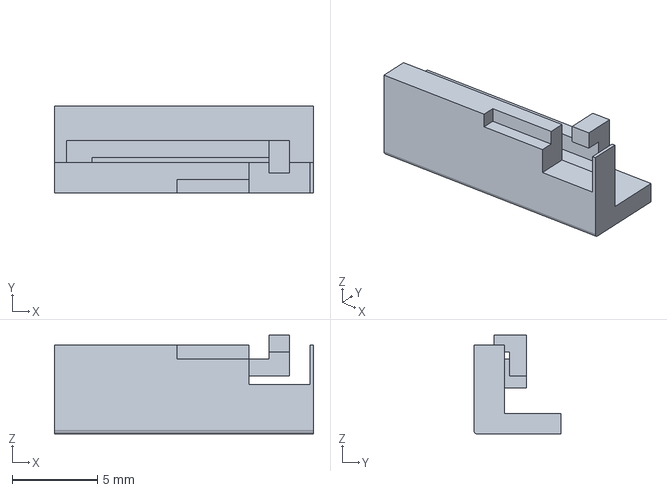
[picture p87: CAD file, 2026-10-17]
deliverables/t0-c/coupons/shell_snap_REAR_beam.step
15.2 x 5.13 x 5.80 mm
