Gadil123/esp32-design/deliverables/t0-e/rear_shell.step

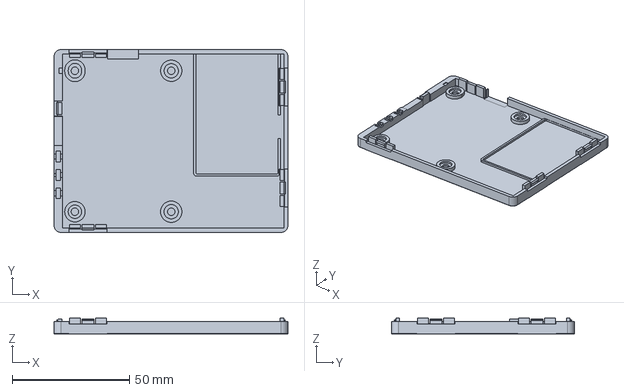
[picture p88: CAD file, 2026-10-17]
deliverables/t0-e/rear_shell.step
99.6 x 77.9 x 6.70 mm
