Gadil123/esp32-design/deliverables/t0-g/rear_shell.step

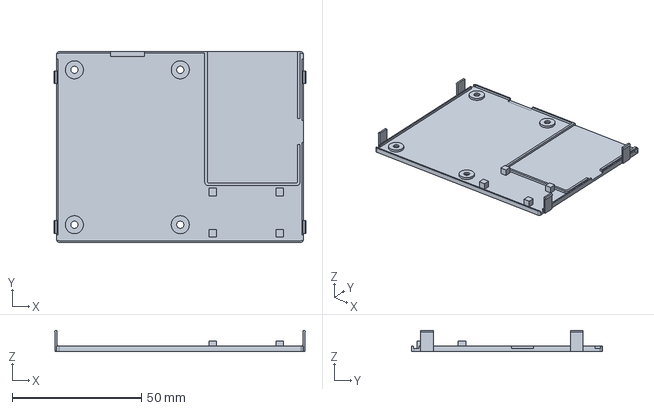
[picture p90: CAD file, 2026-10-17]
deliverables/t0-g/rear_shell.step
97.6 x 73.9 x 8.20 mm
