Gadil123/esp32-design/deliverables/t0/key1_cap.step

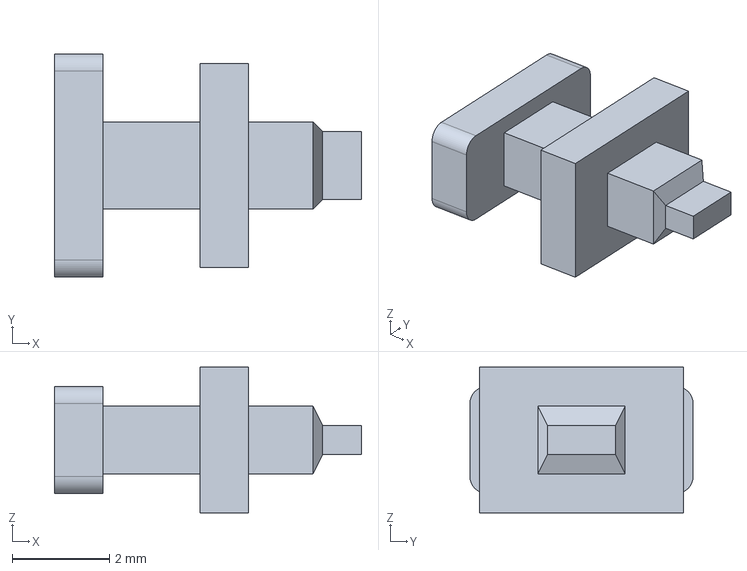
[picture p91: CAD file, 2026-10-17]
deliverables/t0/key1_cap.step
6.33 x 4.60 x 3.00 mm
