Gadil123/esp32-design/deliverables/t0-a/12_4mm/rear_shell.step

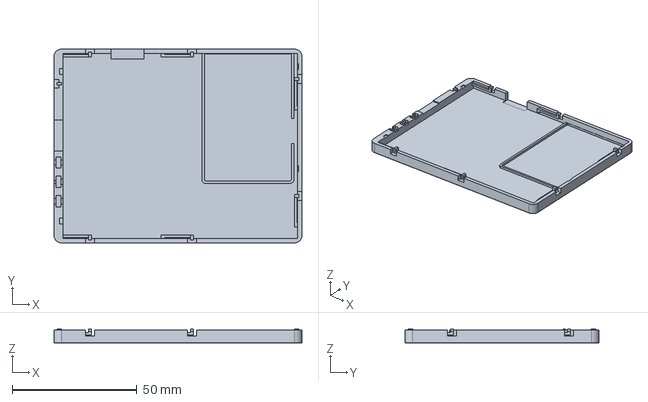
[picture p92: CAD file, 2026-10-17]
deliverables/t0-a/12_4mm/rear_shell.step
99.6 x 77.9 x 5.80 mm
