Gadil123/esp32-design/deliverables/t0-c/USB_two_side_ribs_local.step

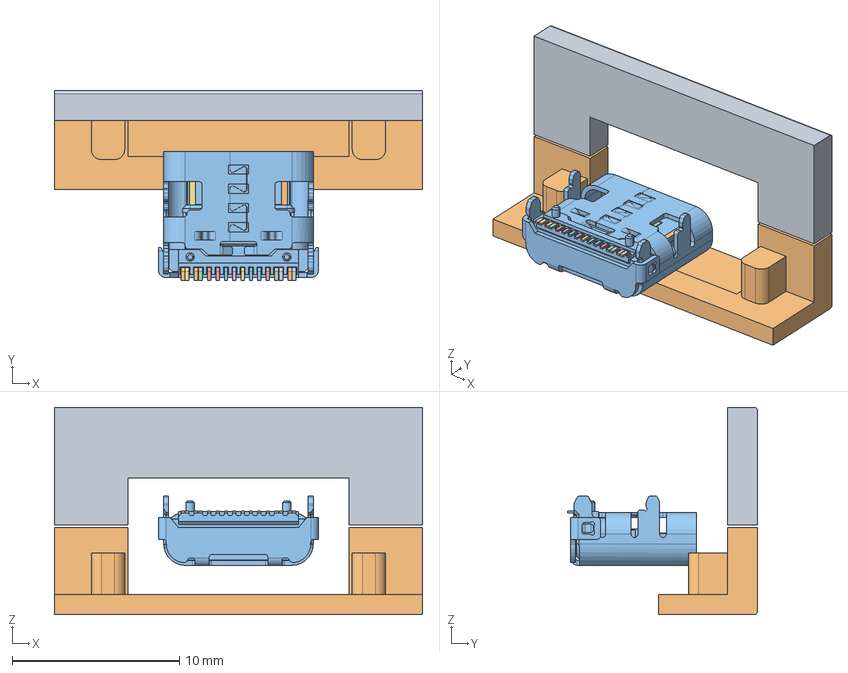
[picture p93: CAD file, 2026-10-17]
deliverables/t0-c/USB_two_side_ribs_local.step
22.0 x 11.4 x 12.4 mm
