Gadil123/esp32-design/deliverables/t0-c/coupons/key_guide_0_2_REAR.step

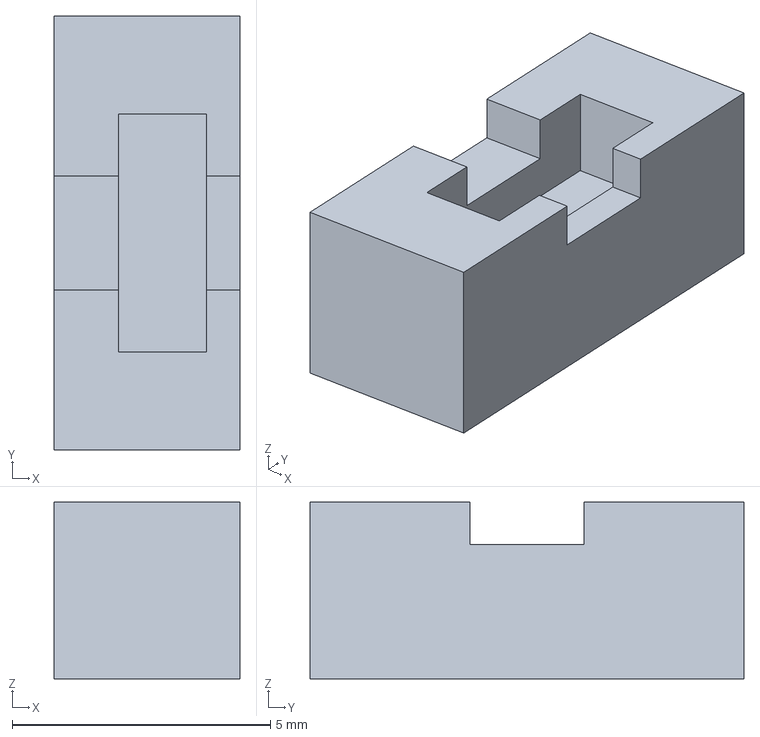
[picture p95: CAD file, 2026-10-17]
deliverables/t0-c/coupons/key_guide_0_2_REAR.step
3.60 x 8.40 x 3.42 mm
