Gadil123/esp32-design/deliverables/t0-g-v1-gate/key1_blocked_section.step

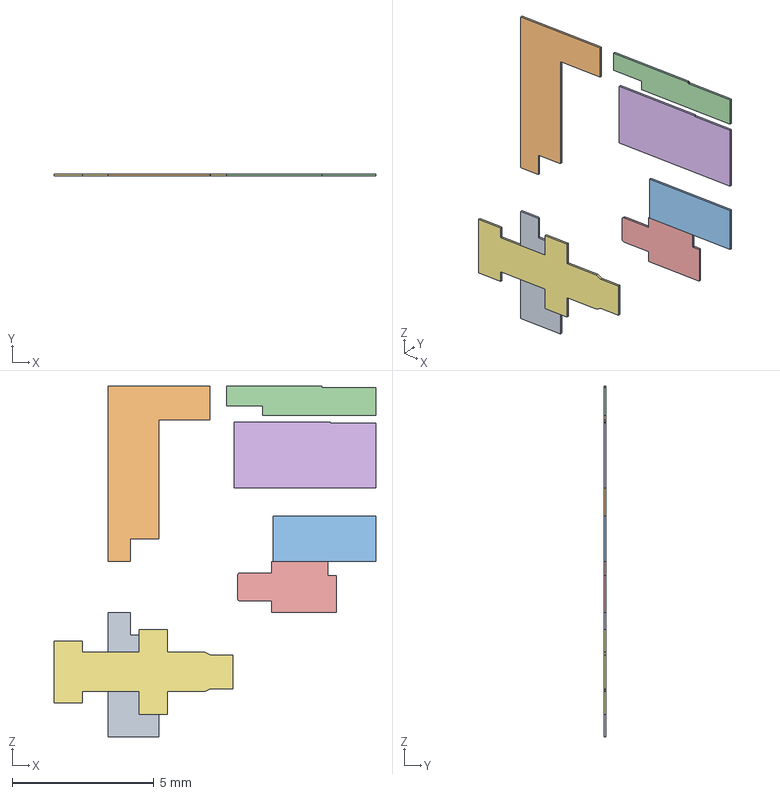
[picture p96: CAD file, 2026-10-17]
deliverables/t0-g-v1-gate/key1_blocked_section.step
11.4 x 0.08 x 12.4 mm
