Gadil123/esp32-design/deliverables/t0-g/four_NBK_SSH_M2_5_4_envelopes.step

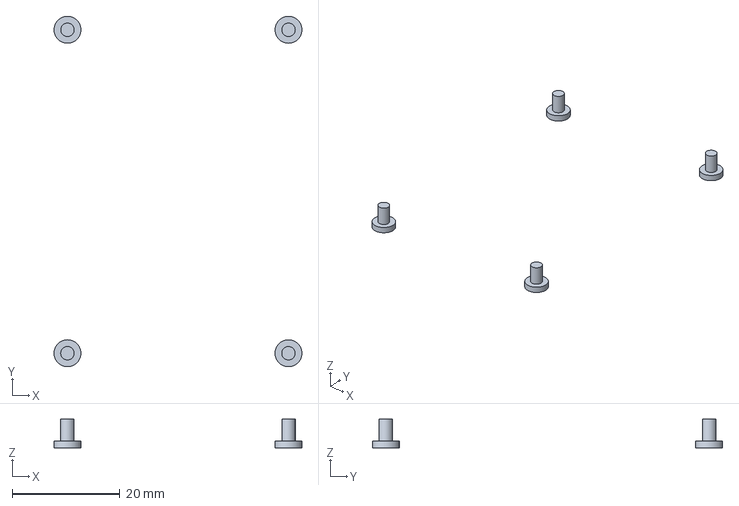
[picture p97: CAD file, 2026-10-17]
deliverables/t0-g/four_NBK_SSH_M2_5_4_envelopes.step
46.0 x 65.0 x 5.30 mm
