Gadil123/esp32-design/deliverables/t0/key3_cap.step

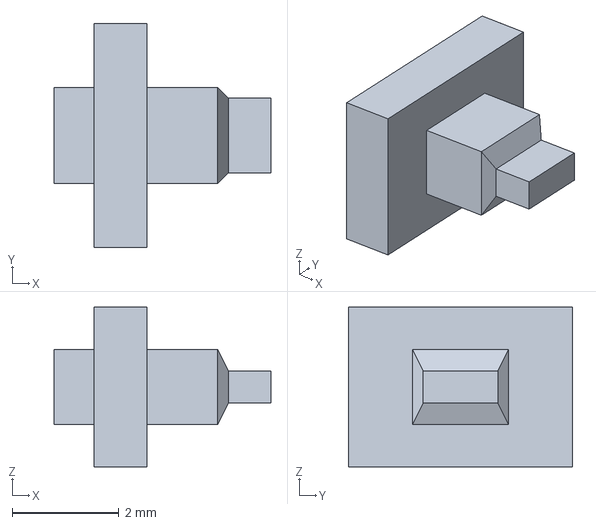
[picture p98: CAD file, 2026-10-17]
deliverables/t0/key3_cap.step
4.07 x 4.20 x 3.00 mm
