Gadil123/esp32-design/deliverables/t0-c/C2_two_native_M2_5_REAR_local_ONLY.step

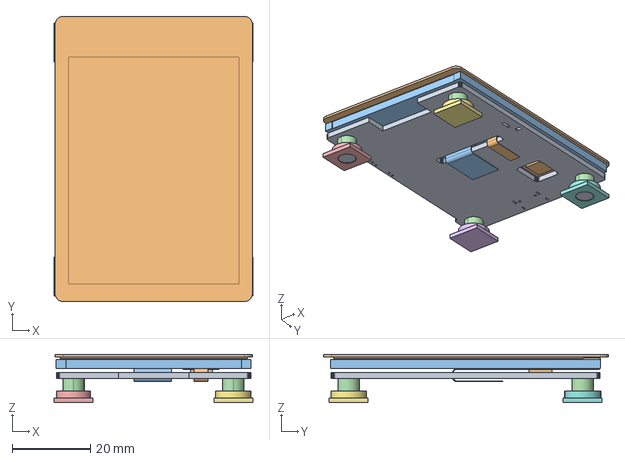
[picture p99: CAD file, 2026-10-17]
deliverables/t0-c/C2_two_native_M2_5_REAR_local_ONLY.step
51.0 x 73.1 x 12.4 mm
