Gadil123/esp32-design/deliverables/t0-c/coupons/RESET_recessed_pusher_candidate.step

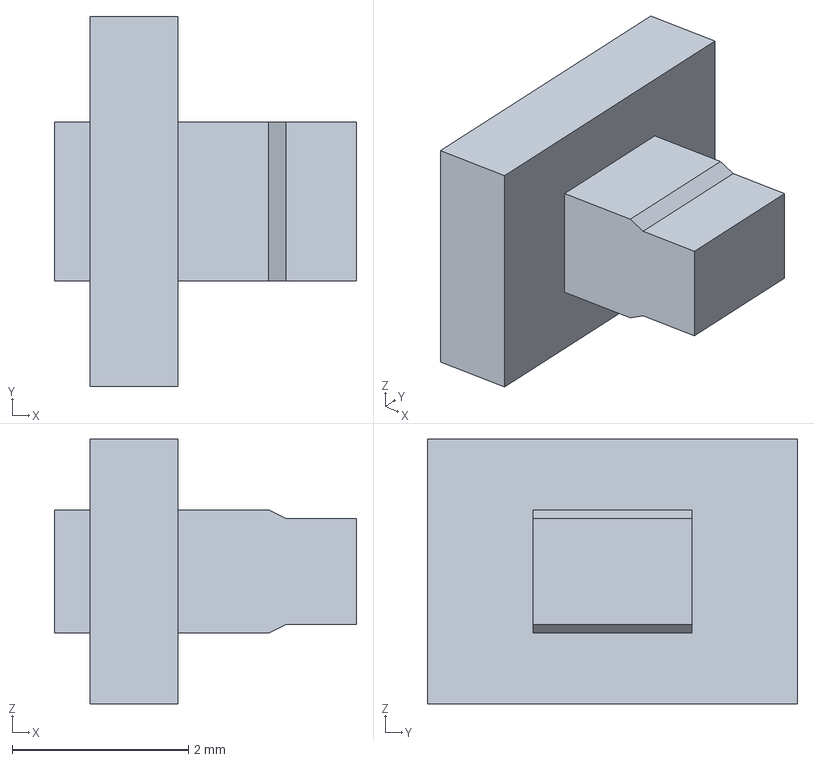
[picture p100: CAD file, 2026-10-17]
deliverables/t0-c/coupons/RESET_recessed_pusher_candidate.step
3.42 x 4.20 x 3.00 mm
