Gadil123/esp32-design/deliverables/t0-c/RESET_2_2_fixture_context_NOT_PRINT.step

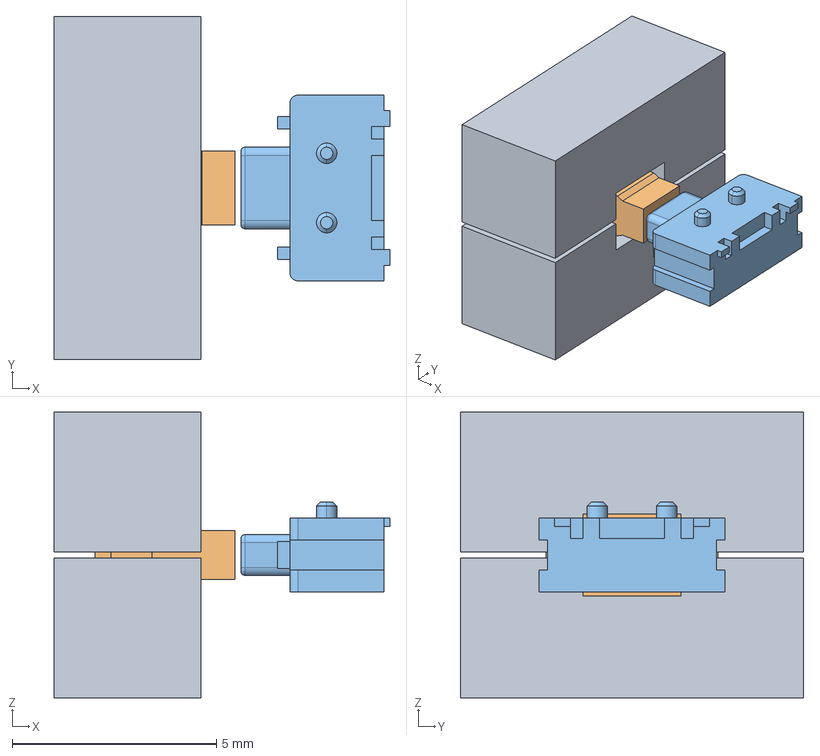
[picture p101: CAD file, 2026-10-17]
deliverables/t0-c/RESET_2_2_fixture_context_NOT_PRINT.step
8.22 x 8.40 x 7.00 mm
