Gadil123/esp32-design/deliverables/t0-c/snap_pair_context_NOT_PRINT.step

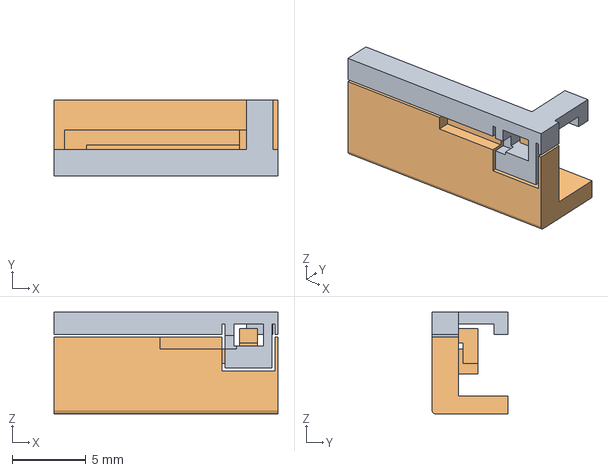
[picture p102: CAD file, 2026-10-17]
deliverables/t0-c/snap_pair_context_NOT_PRINT.step
15.2 x 5.13 x 6.90 mm
