Gadil123/esp32-design/deliverables/t0-c/coupons/shell_snap_FRONT_receiver.step

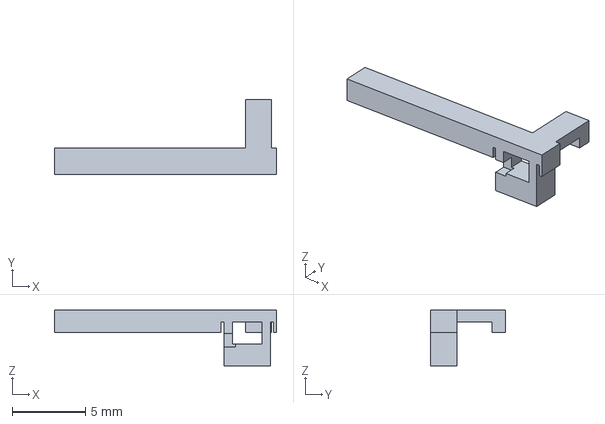
[picture p103: CAD file, 2026-10-17]
deliverables/t0-c/coupons/shell_snap_FRONT_receiver.step
15.2 x 5.13 x 3.80 mm
