Gadil123/esp32-design/deliverables/t0-c/coupons/native_mount_female_nest.step

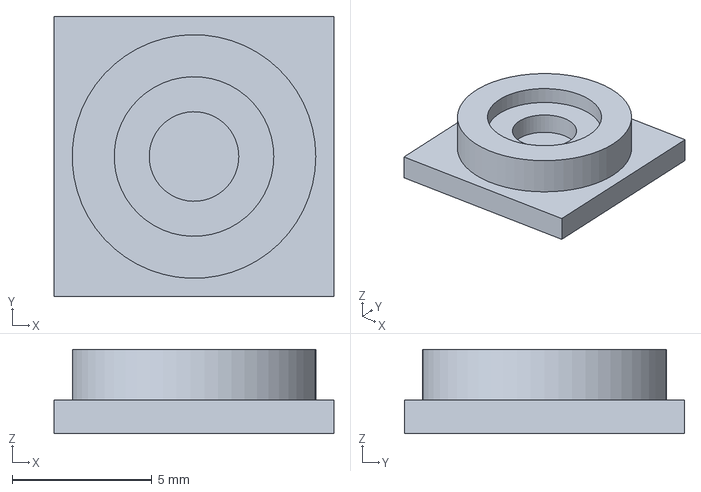
[picture p104: CAD file, 2026-10-17]
deliverables/t0-c/coupons/native_mount_female_nest.step
10.0 x 10.00 x 3.00 mm
