Gadil123/esp32-design/(list of files, cad)

Other CAD files:
deliverables/t0-g-v1/assembly_light.step
deliverables/t0-a/12_4mm/assembly_light.step
deliverables/t0-g-v1-gate/key1_cap.step
deliverables/t0-a/12mm/key1_cap.step
deliverables/t0-a/key-study/key2_low_candidate.step
deliverables/t0-c/coupons/RESET_hole_2_2.step
deliverables/t0-c/key_fixture_0_2_context_NOT_PRINT.step
deliverables/t0-g-v1-boot-rect/front_local_GATE_ONLY.step
deliverables/t0-a/12_4mm/key2_cap.step
deliverables/t0-a/key-study/key3_low_candidate.step
deliverables/t0-g-v1-gate/key2_cap.step
deliverables/t0-g-v1-integrated/key2_rest_section.step
deliverables/t0-g-v1/front_shell.step
deliverables/t0-a/12mm/key2_cap.step
deliverables/t0-c/coupons/RESET_hole_2_5.step
deliverables/t0-e/key3_cap.step
deliverables/t0-g-v1-gate/deep_front_GATE_ONLY.step
deliverables/t0-g/key2_cap.step
deliverables/t0-c/key_fixture_0_3_context_NOT_PRINT.step
deliverables/t0-e/key1_cap.step
deliverables/t0-a/12_4mm/key3_cap.step
deliverables/t0-a/12mm/front_shell.step
deliverables/t0-e/key2_cap.step
deliverables/t0-g-v1-gate/key2_blocked_section.step
deliverables/t0-g/key3_cap.step
deliverables/t0/key2_cap.step
deliverables/t0-c/coupons/key_guide_0_3_FRONT.step
deliverables/t0-g/key1_cap.step
deliverables/t0-c/coupons/key_guide_0_2_FRONT.step
deliverables/t0-c/coupons/key_guide_0_3_REAR.step
deliverables/t0-c/coupons/key_cap_COMMON.step
deliverables/t0-c/coupons/key_guide_0_4_FRONT.step
deliverables/t0-c/coupons/key_guide_0_4_REAR.step
deliverables/t0-a/12_4mm/front_shell.stl
deliverables/t0-a/12_4mm/key1_cap.stl
deliverables/t0-a/12_4mm/key2_cap.stl
deliverables/t0-a/12_4mm/key3_cap.stl
deliverables/t0-a/12_4mm/rear_shell.stl
deliverables/t0-a/12mm/front_shell.stl
deliverables/t0-a/12mm/key1_cap.stl
deliverables/t0-a/12mm/key2_cap.stl
deliverables/t0-a/12mm/key3_cap.stl
deliverables/t0-a/12mm/rear_shell.stl
deliverables/t0-a/key-study/key1_low_candidate.stl
deliverables/t0-a/key-study/key2_low_candidate.stl
deliverables/t0-a/key-study/key3_low_candidate.stl
deliverables/t0-c/coupons/RESET_hole_2_0.stl
deliverables/t0-c/coupons/RESET_hole_2_2.stl
deliverables/t0-c/coupons/RESET_hole_2_5.stl
deliverables/t0-c/coupons/RESET_recessed_pusher_candidate.stl
deliverables/t0-c/coupons/key_cap_COMMON.stl
deliverables/t0-c/coupons/key_guide_0_2_FRONT.stl
deliverables/t0-c/coupons/key_guide_0_2_REAR.stl
deliverables/t0-c/coupons/key_guide_0_3_FRONT.stl
deliverables/t0-c/coupons/key_guide_0_3_REAR.stl
deliverables/t0-c/coupons/key_guide_0_4_FRONT.stl
deliverables/t0-c/coupons/key_guide_0_4_REAR.stl
deliverables/t0-c/coupons/native_mount_female_nest.stl
deliverables/t0-c/coupons/shell_snap_FRONT_receiver.stl
deliverables/t0-c/coupons/shell_snap_REAR_beam.stl
deliverables/t0-e/front_shell.stl
deliverables/t0-e/key1_cap.stl
deliverables/t0-e/key2_cap.stl
deliverables/t0-e/key3_cap.stl
deliverables/t0-e/rear_shell.stl
deliverables/t0-g-v1-boot-rect/front_shell.stl
deliverables/t0-g-v1-gate/deep_front_GATE_ONLY.stl
deliverables/t0-g-v1-gate/key1_cap.stl
deliverables/t0-g-v1-gate/key2_cap.stl
deliverables/t0-g-v1-gate/rear_seats_GATE_ONLY.stl
deliverables/t0-g-v1-integrated/front_integrated_GATE_ONLY.stl
deliverables/t0-g-v1/front_shell.stl
deliverables/t0-g-v1/rear_shell.stl
deliverables/t0-g/front_shell.stl
deliverables/t0-g/key1_cap.stl
deliverables/t0-g/key2_cap.stl
deliverables/t0-g/key3_cap.stl
deliverables/t0-g/rear_shell.stl
deliverables/t0/front_shell.stl
deliverables/t0/key1_cap.stl
deliverables/t0/key2_cap.stl
deliverables/t0/key3_cap.stl
deliverables/t0/rear_shell.stl
