Gadil123/esp32-design/docs/19_t0_g_recessed_assembly.md

# T0 G：深前壳、四原厂螺丝与嵌入式后盖

> **历史G记录保留。** 最新G-V1按[21](21_t0_g_v1_flush_easy_assembly_revision_brief.md)恢复齐平；[22首闸门报告](22_t0_g_v1_first_gate_stop.md)发现两键后装真实壁干涉，已STOP，未完成G-V1整壳。下文12.9mm旧G结果不适用于G-V1。

执行 [G 任务书](18_t0_g_recessed_full_wrap_cad_task.md) 和 [PR #3 最新授权](https://github.com/Gadil123/esp32-design/pull/3#issuecomment-6217644907)。只开发这一条 G 路线；E 的源码、交付及其余版本保持不变，Pocket OS 文档不变。

**G full nominal assembly CAD complete; geometry reviewed; material/functional acceptance pending.** 本文的“通过”仅指下面明确列出的名义几何及路径。没有批准打印、采购或合并；尤其不能将 0.074mm 键帽间隙、0.8mm 承座或理想弹性姿态解释为 PA12 实际可装配保证。

**定位容差闸门：BLOCKED_PCB_XY_LOCATION。** 螺孔许可横移会消耗键帽/玻璃余量，已用真实LCD重现负向证据。指定XY位置的名义路径通过，但没有证明任意螺孔落位都能装入；本轮交出完整候选与风险，不擅自增加定位结构或新方案。

## 复现与交付

沿用 [T0 环境说明](11_cad_t0.md)：Linux、Python 3.13、独立 `.venv`，`requirements.lock.txt` 中的 build123d 0.13.0/OCP；官方仓库与本仓库并列且只读。

```bash
./scripts/setup-t0-reference.sh
python3.13 -m venv .venv
.venv/bin/python -m pip install -r requirements.lock.txt
./scripts/generate-t0-g.sh
```

一条生成命令直接读取官方 `dimensions/ESP32-C5-Touch-LCD-2.8.stp`，累计原装配父级位姿、绕 Z 180°，不读取开发缓存、不缩放或拆开原显示/PCB 总成。全部 **723 个官方 solids** 参与检查；原始非实体参考曲面保留在完整 STEP。坐标：**FRONT +Z、REAR −Z、USB +Y；FRONT 看原生键/TF 在左 −X**。现有测量 CSV 只作坐标回核，不重新猜规格。

参数在 `cad/t0/t0-g-parameters.json`；沿用 A 的已确认板卡接口/配件临时参数及原三帽尺寸。G 独立模型、检查、图纸和入口分别为 `t0_g_model.py`、`t0_g_gate.py`、`t0_g_drawings.py`、`generate_t0_g.py`。复用已有几何函数，不改写 E。

小型文件见 [G 交付目录](../deliverables/t0-g/README.md)：两壳/三帽 STEP、STL，四螺钉外包络 STEP、轻量 STEP/GLB、原生 CAD 图纸、`checks.json`。轻量参考件有明确代理标签，**不用来证明干涉通过**。完整原板 STEP 在 `build/t0-g/assembly_complete_12_9mm.step`，压缩附件为 `t0-g-review-complete.zip`，放到 PR 使用的原私有草稿 Release，不把完整官方几何写进 Git。

```bash
gh release download t0-cad-review-20261016-9ec1022 \
  --repo Gadil123/esp32-design --pattern t0-g-review-complete.zip
```

检查失败会非零退出并保留报告，不导出声称成功的整壳。完整 STEP 导出后重新导入，检查每个实体及真实最大 Z；零件另作 STEP 回读与独立 STL 闭合、包络/体积核对。

## 12.9mm 尺寸链与承力

| 基准/特征 | G 名义值（mm） | 含义 |
|---|---:|---|
| 壳体 X/Y 外形 | 99.60 × 77.86 | 与 E 相同，X −29.47..70.13，Y −35.93..41.93 |
| 原帽静态横向外包络 | 101.50 | 外伸1.9，未改变两颗日常帽外观 |
| 三帽外停靠时最大宽度 | **101.80** | 包含0.3装配/导向浮动，未隐去临时外凸 |
| 最高 FRONT / 玻璃正面 | +1.20 / +0.70 | 屏幕下沉0.50 |
| 薄压边下面 / 玻璃间隙 | +0.95 / 0.25 | 压边厚0.25，不压玻璃 |
| 候选压边盖玻璃量 | 0.15 / **UNVERIFIED** | STEP无有效显示/触控区证据；不是已确认可遮黑边量 |
| 原 PCB 基体前/后 | 约−3.90 / −5.50 | 保留官方真实微小转角及原件关系 |
| 原厂金属件后承面 | 约−9.50 | 四处后盖座直接承托金属件，不在玻璃上加前挡环 |
| 后盖内面 / 外面 | −10.50 / −11.70 | 主体厚1.20 |
| 头底 / 头下承面 | −11.60 / −10.30 | 真实头高1.30，外表凹入0.10 |
| 头下至原金属件承压座 | **0.800** | C2的薄座风险仍存在；没有换虚构0.6mm头 |
| 完整最大厚度 | **12.900** | 包含所有原厂实体、两壳、三帽、四螺钉、配件/胶/泡棉/阻尼、插头/线束；回读值见报告 |

候选采购件 **4 × NBK SSH-M2.5-4**：M2.5、螺杆4、头 Ø5×1.3，依据 [NBK 原尺寸表](https://www.nbk1560.com/images/en-US/product/lowsmallheadscrew/SSH/SSH_1.pdf)。后盖过孔 Ø2.8、头窝 Ø5.4。螺钉 CAD 为完整外部体积包络，不是精细螺纹/六角穴模型；工具以独立 Ø1.6 包络从 REAR 检查，只对该预期工具/头部配合豁免，不吞掉周边元件碰撞。不得用此候选件替代实板螺纹深度/实配扭矩测量。

每个头的有效承压环面积约13.477mm²，径向环宽1.1；名义螺杆伸入金属背面3.20、端部Z−6.30。只在螺钉检查中明确排除四个匹配的原厂内螺纹实体，其他原板 solids 全部保留；没有把预期螺纹啮合算成“零碰撞”。承座对原金属面有正面积接触探针证据，背面工具路径无名义碰撞。孔径/螺纹、低头强度、3.2是否全长有效啮合、拧紧扭矩、PA12压溃与蠕变仍 **UNVERIFIED**；厂家金属螺钉扭矩不能直接用于薄塑料座。

载荷链是 **螺头 → 后盖局部承座 → 原厂金属安装件**。四处非共线座承面限制相对Z/绕X/Y；四螺杆/过孔名义径向余量0.15限制横向浮动，夹紧摩擦不是已实测定位精度。螺钉只把板锁到后盖，不连接前壳。前壳四处独立肩面接触后盖，在原厂件后方保留空隙；额外+0.05闭合诊断已先触发外围肩面，玻璃距薄压边仍有0.20名义间隙。没有拿玻璃、PCB基体或电池承受前后壳夹紧力。

## 必须采用的装配顺序

1. 在打开的深前壳中放入原三帽，**整机 LEFT 朝下**。让三帽依靠重力落在导向的外侧硬限位：相对旧名义位置−X 0.30。PCB＋后盖随后沿 **+Z 水平直线**进入，拆卸沿−Z退出，仍保持 LEFT 朝下。
2. 在壳外将完整原板四个金属位与后盖座对正，四颗 M2.5 从 REAR 拧入；用开盖空间先接真实核准的连接器。临时电池胶层0.2、保护板、扬声器/阻尼和候选线束放在后盖组上，线束不靠拉插头张紧。
3. 整组直线送入。浅止口辅助XY导向，肩面决定闭合高度；四舌的端部让位后倒钩进入内壁盲槽。几何检查使用根部固定的让位形态及整个回位包络，不能当成实际扣入力预测。
4. 拆盖先从 REAR 左下边缘的一处起撬缺口开始，细片沿扣舌根部旁的槽进入，到自由端后再向内顶。逐处让位并保持四处释放；**四个外部保持片需要随模块退出至少8.3mm，再放松倒钩**。不让带玻璃的后盖局部剥起，不通过弯玻璃或拉线来先开一边。

**侧键是最紧的装配公差门槛。** 重现了旧名义帽位置在模组Z−6时三处与真实 LCD 约0.08mm³相交；外停靠后完整原板的连续包络距三帽分别约0.074/0.076/0.075。G 仅给 RESET 原帽后身增加0.3外移导向避空，因此正面维护孔后的局部面料由0.8减至 **0.5mm**，孔径仍沿用1.3、原帽与电子开关不变。停靠时 RESET 鼻仅内缩约0.05；隐藏维护防误触、细鼻、重力是否克服摩擦、向外限位是否可靠均需实物验证。不能把小于常见打印误差的净空解释成生产裕量；不将0.4候选帽运动当成未知开关真实行程。图/检查同时包含外停靠与0.4向内候选运动。

原厂 STEP 将每个 KEY 合并为单一实体，不能分辨真实运动件。[C 局部研究](15_t0_c_pa12_feasibility.md) 已记录固定框代理与偏心按压风险；G 沿用接触头和导向，不据“键帽对塑料壳的净空通过”关闭该风险。真实开关行程、框体、按偏时是否卡住及回弹仍需实物验证。

**这也不是已通过的定位容差设计。** Ø2.8后盖孔与Ø2.5杆允许0.15径向游隙，已经大于0.074玻璃余量，且头窝也允许该横移。检查另保留原板相对后盖朝−X偏0.10、装入Z−6的真实LCD碰撞反例；它仍在螺杆/头窝许可范围内。四螺钉的名义夹紧位置有可行路径，但不能保证任意拧紧位置都能装入；必须在拧紧前核对XY定位，是否可用简单工装可靠保持尚未验证。G本轮不擅自增设精密定位件或修改帽结构来宣称这一风险已解决。

量化下界：朝键侧的PCB/后盖定位误差必须小于约0.074，或在当前帽停靠基础上再让出至少约0.076，才仅能覆盖现有0.15孔隙并达到零碰撞边界，**尚未含外壳止口/扣槽配合游隙或任何工艺/实板误差余量**。后一数值也会进一步削弱RESET面料，不能作为已接受修正；这里只给Reviewer最小几何缺口，不继续搜索/实现别的结构。

## 四隐藏舌、盲槽和拆卸限制

四位在左右长边、FRONT Y=−28与+30附近，形成接近四角的矩形分布。它们避开左侧TF/三键和顶部USB，右侧避开保护板/扬声器及电池边界。没有复制E五齿位置/几何，也没有增加侧面接收通孔。

每舌根部Z−9.3，自由端−3.5，有效长5.8、厚0.8、宽5，倒钩高0.7、突出0.4，端部候选让位0.45。梁向腔内放置，在盲槽外保留约 **0.95mm** 壁，倒钩后向保持面与独立闭合肩面之间为**零名义轴向游隙**。原先0.1余隙会允许后盖后移，使厚度由12.9变成13.0，不能保留。现在增加后拉0.01的真实保持反例，并将允许的轴向游隙纳入最大厚度检查；另外从导出STEP的前后向微移接触取得两组接触凸包，核查秩3及正面积交叠，以约束刚体Z/俯仰/滚转；零间隙并不具备PA12制造公差保证。1.0高、0.6宽浅止口在电池上沿及保护板处中断，避免侵入软包/保护板；板卡限位不依靠止口或前压边。

报告保留负向保持证据：未释放向 REAR 拉0.3即与盲槽承面相交；让位后整段进入/退出无名义碰撞。**开缝1mm即回弹仍会卡住**，不是通过项；至少退到8.3后才可回弹。根部固定 smoothstep 姿态的简化应变约 **3.21%**，不是材料允许值、实际应力或五十次寿命。外部候选释放片的导入薄段0.15，末端与倒钩斜面相配；顺序检查先入槽、再内顶，不能用两动作的笛卡尔组合虚构“碰根部”。释放片是外部工具包络，不是新增产品零件。

**工具操作仍是未放行门槛：** 0.15薄片是否可取得、刚度/根部摩擦、同时保持四处且随后盖/原板平移8.3、实际扣入/释放力以及薄板翘曲未获实物证据。此处只证明有明确实体、接触/让位包络和连续路径，不声称一把普通撬片即可轻松拆机。若Reviewer认为这不够简单，应先收敛这一项，不擅自搜索新机构。

## 右舱、接口与检查范围

电池34×50×5、扬声器30×20×6.8、保护板/胶层/泡棉/阻尼均保持 **unverified** 参数。电池浅定位槽修整到深壳腔体内，上端浅止口中断；未缩电池，未加长机身。扬声器增加四处后盖支承垫，支在0.3阻尼下面，使其随模块进入前壳定位围框；正面0.5泡棉包含胶层，名义接触无压缩量；后方0.3阻尼总成也包含胶层，入壳前需将扬声器暂固定到四托垫，防止LEFT朝下时滑落或吊在线上。该粘接/侧向保持、最终泡棉压缩和实际出声口均待测。六条正面槽保留。

USB原生口和独立12.2×6.3插头通道保留；下薄边约0.880。TF保留−X外部11×1候选卡片通道，未伪造真实座入/弹出行程。MIC1不新增声孔，不能确认进声方向；ES8311仍仅是codec。右舱和线束不碰MIC实体，不代表其拾音声路已打通，裸板/装壳录音对照仍是V1门槛。

MX0/MX1原厂插口均朝−X；候选4mm插头和Ø1.5线束随整个后盖模块进入。连续线束检查先用真实BRep沿Y按路径/围框缺口边界分片，再以各片连续Z包络验证，并校核分片体积覆盖；没有把稀疏采样当连续证明，也没有忽略弯头。实际BAT/SPK位号映射、极性、插头鼻、出线位置和长度仍待实物。线端只到等待区，不宣称真正电气连接已完成。

最终机器报告分别列明原板全部solids、最终静态配对、整组连续插入、三帽停靠/运动、四承座/工具、四舌保持/完整让位与释放工具、外围止挡、USB/TF和回读实体/包络。检查不是制造资格。

完整STEP回读 **742/742有效实体**，最大Z包络 **12.900mm**；两壳和三帽各为单实体，五个STL非流形边均0。导出STEP实际局部截面量得后盖1.200、螺座0.800、前压边0.250、RESET面0.500、右下槽外壁0.950、自由梁0.800、USB下边0.880mm。这是所列截面的测量，不是全局最薄壁算法或PA12加工放行。

## E / G 对照与 PA12 风险

对照图使用冻结的E零件STEP和G导出STEP、相同投影向量、相同mm坐标范围、相同行列画布尺寸及颜色；不是概念效果图。FRONT/REAR/ISO每列E/G比例一致，显示/触控边界均标UNVERIFIED。E与G的扬声器/泡棉位置按各自真实高度绘制。

| 项目 | E 保留候选 | G 本轮候选 |
|---|---|---|
| 名义主体 / 最大厚度 | 99.6×77.86 / 12.4 | 相同主体 / 12.9；帽外停靠宽101.8 |
| 屏幕/正面 | 齐平，宽玻璃开口 | 下沉0.5，0.25薄压边，遮黑边量未核准 |
| PCB保持 | 三A边夹＋四浅窝 | 四原金属位M2.5锁后盖 |
| 壳连接 | 五外部短齿窗口 | 四内壁盲槽短舌、浅止口与独立肩面 |
| 背面 | 无板卡螺钉 | 可见四低头螺钉与嵌入后盖接缝 |
| 装拆 | 板先装，帽从REAR后装 | LEFT向下帽外停靠，整组装入；四释放片保持至退8.3 |
| 主要PA12风险 | 夹位/短齿、左壁及顺序开盖 | .8承座、.8梁、.95槽外壁、.25前压边、.5 RESET面及.074装配净空 |

G没有被判定优于E。依据原 [嘉立创通用设计参考](https://www.jlc-3dp.cn/technicalColumnsDetails/27832.html) 的薄壁/细特征与公差提醒，以上局部尺寸、公差和大薄板均需供应商针对选定材料/方向审查；[材料列表](https://www.jlc-3dp.cn/model) 中的PA12工艺条目不能代替订单规格。[PA12说明文章](https://www.jlc-3dp.cn/technicalColumnsDetails/59512.html) 涉及SLS，不能套作MJF保证。材料尚未验收，无实测回弹、根部圆角/打印方向方案、扭矩、翘曲、疲劳或声学数据。本轮不做FEA、新小样套件或新的结构方案搜索。
