Gadil123/esp32-design/deliverables/t0-c/mount_assembly_sections.png

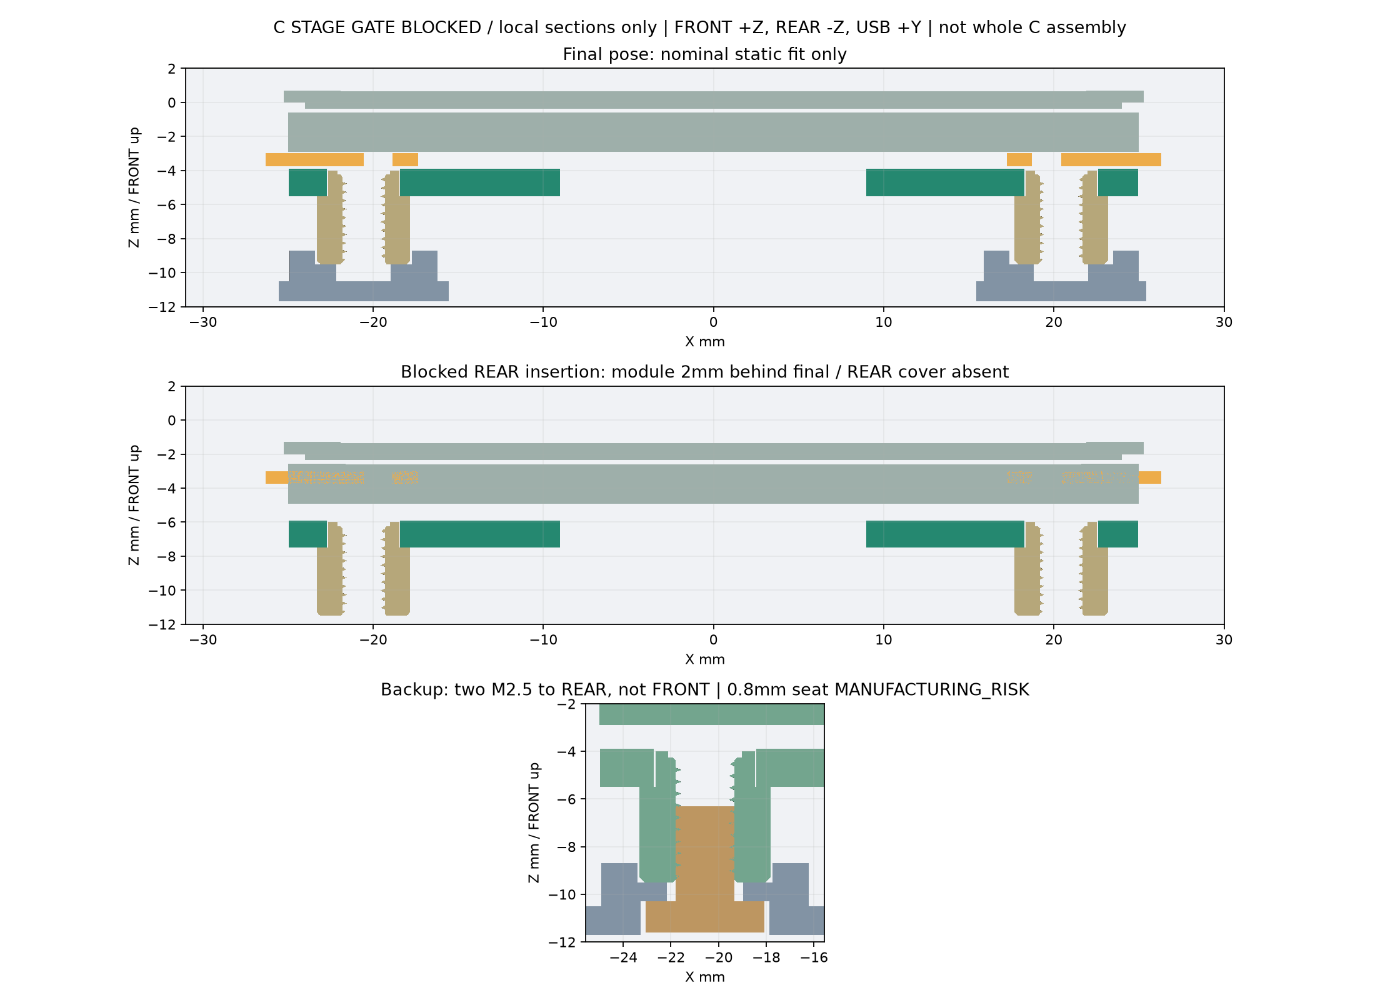
deliverables/t0-c/mount_assembly_sections.png
