Gadil123/esp32-design/deliverables/t0-g-v1/combined_register_bore_print_reach.png

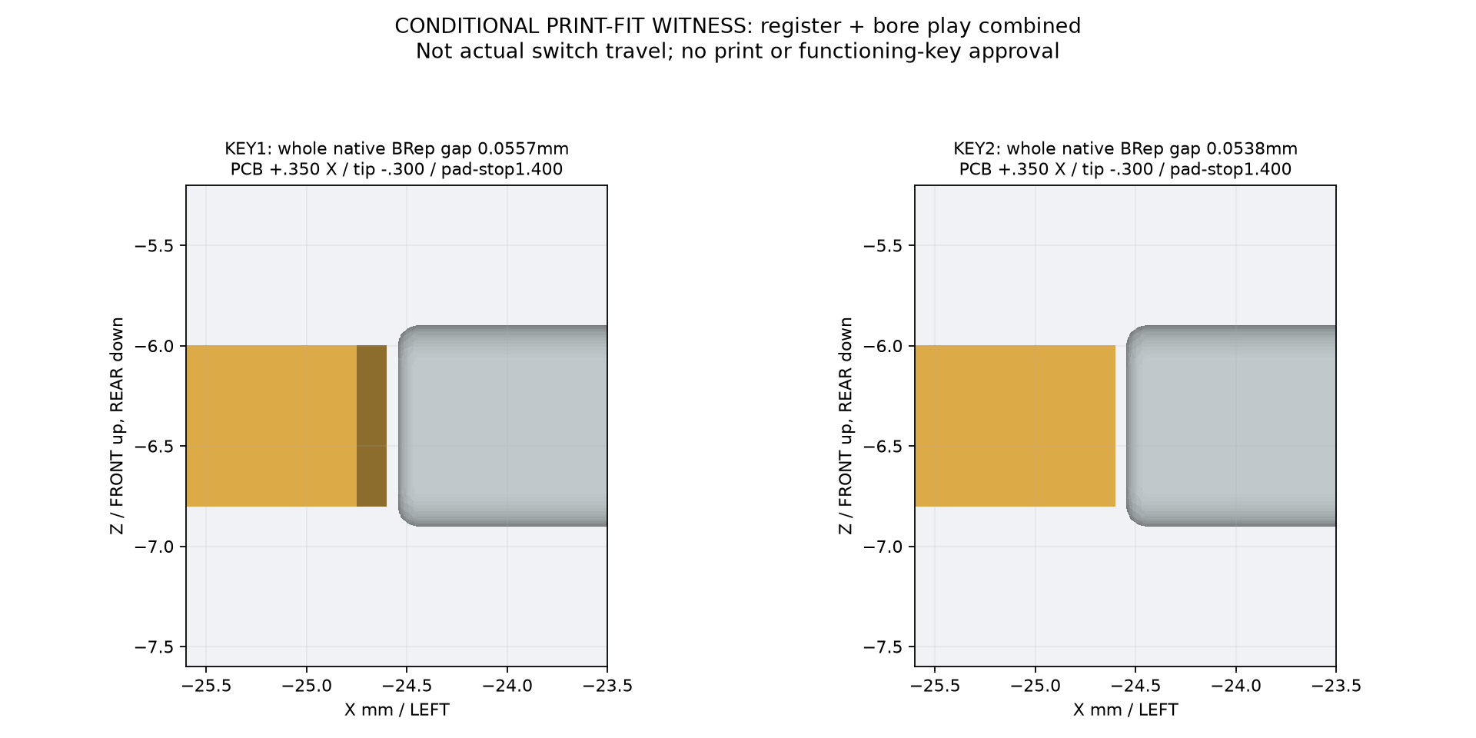
deliverables/t0-g-v1/combined_register_bore_print_reach.png
