Gadil123/esp32-design/deliverables/t0-g/assembly_sequence.png

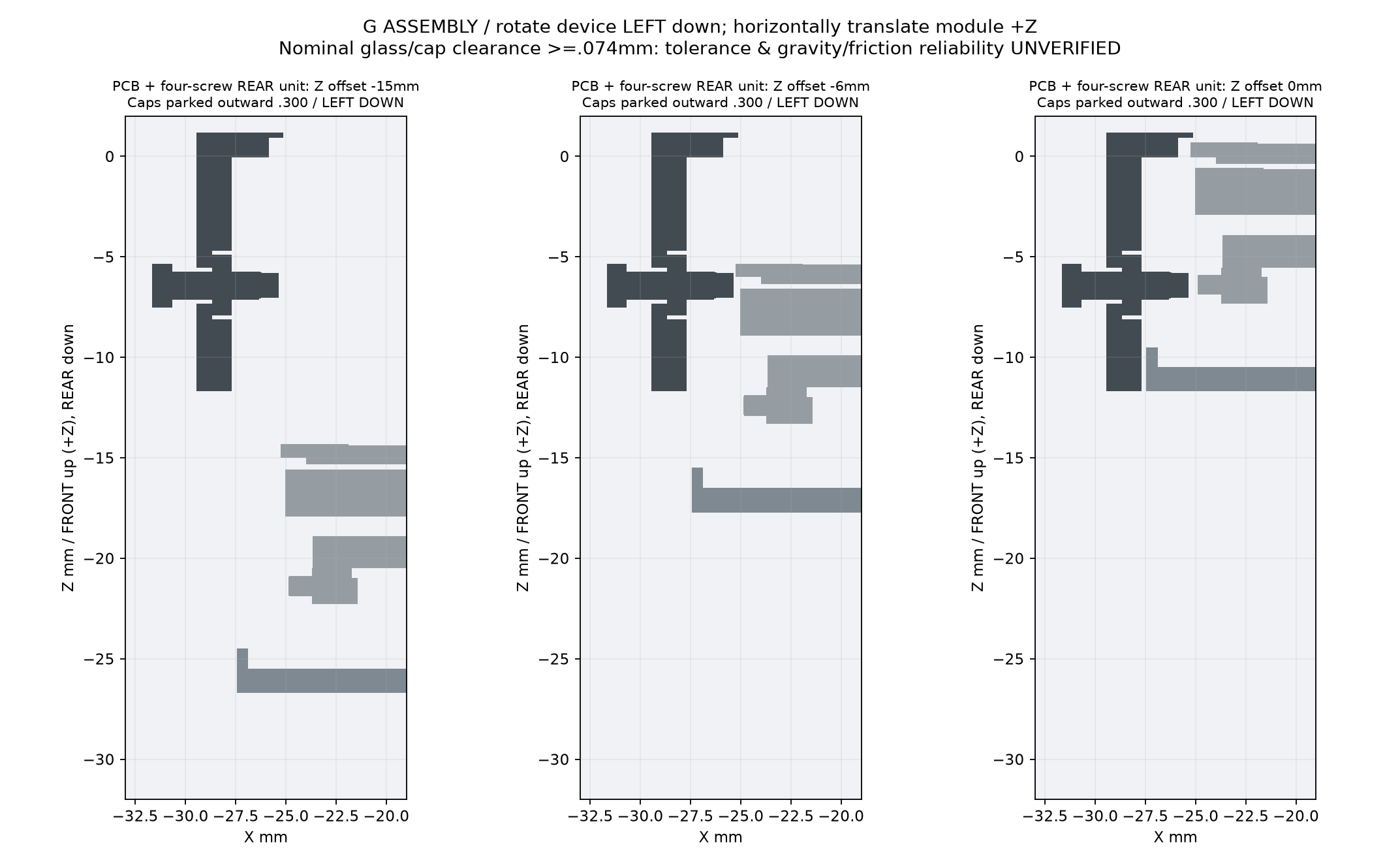
deliverables/t0-g/assembly_sequence.png
