Gadil123/esp32-design/docs/07_cad_measurements.md

# 07 · 官方 STEP 实测：三键、USB-C、麦克风与机壳机械基准

**分析日期：2026-10-16 前后；数据来源：用户上传的微雪原始 `.stp`、`.dxf`、尺寸 `.pdf`。**
状态：**已用 OpenCascade/OCP 直接读入 STEP 并展开组件装配树**，不是按图片目测的尺寸；但**没有完成按键活动行程与麦克风声孔的实物核对**。

## 一、模型核验及最重要的方向定义

- STEP 文件：`ESP32-C5-Touch-LCD-2.8.stp`，约 26MB，Creo Parametric 导出（文件头时间 2026-06-24）；OpenCascade 正常读取/装配展开。
- PDF：官方单页视图，包含前视/侧视/PCB 背面视图和尺寸标注。
- DXF：官方 2D 图纸，可解析。
- STEP 中明确包含 `KEY1/KEY2/KEY3`、同名 `SWITCH-TS24CA` 开关、`MIC1`、`J2`（位于 USB-C 端的连接器模型）、`BOARD` 等实体。

### STEP 原始坐标（非常重要）

以下坐标是 STEP **原生坐标**，不是已经旋转好的壳体坐标；单位 mm：

- **+X = 三颗侧键所在 PCB 边；−X = 板载麦克风所在 PCB 边。**
- **−Y = USB-C 所在短边；+Y = 另一短边。**
- **+Z = 屏幕正面；−Z = 主板元件及后背方向。**
- 从屏幕正面观察该原始坐标时：USB-C 原本朝**下**，按键在**右**。如果主板在屏幕平面内旋转 **180°**，使 USB-C 朝**上**，从屏幕正面看**按键变为左边**；从 PCB 背面看**按键是右边、麦克风左边**。
- 这与用户指出的“将**官方横向 PCB 背面图**顺时针旋转 90°：USB-C 顶部、MIC 左侧、按键右侧”一致。**正反视图左右是镜像，严禁将背面右侧当作用户正面右侧。**

## 二、从 STEP 解出的组件包围盒

坐标采用 `xmin..xmax, ymin..ymax, zmin..zmax`，单位 mm；**为名义 CAD 外包络，保留到 0.01mm 供定位，不代表厂家制造公差或 3D 打印精度**。

| 组件（STEP 装配名） | X 范围 | Y 范围 | Z 范围 | 外包络尺寸 (X×Y×Z) |
| --- | ---: | ---: | ---: | ---: |
| 整板屏幕+PCB 总装配 | -25.27..25.27 | -39.53..33.53 | -9.51..0.70 | **50.55 × 73.07 × 10.22** |
| `2_8INCH` 屏幕总成 | -25.27..25.27 | -39.53..33.53 | -6.32..0.70 | **50.54 × 73.06 × 7.02** |
| `BOARD` PCB 基体 | -24.94..24.98 | -37.41..31.61 | -5.50..-3.90 | **49.92 × 69.02 × 1.61** |
| `KEY1` (SWITCH-TS24CA) | 21.24..24.90 | 1.35..5.90 | -7.30..-5.10 | **3.66 × 4.55 × 2.20** |
| `KEY3` (SWITCH-TS24CA) | 21.24..24.90 | 9.17..13.72 | -7.30..-5.10 | **3.66 × 4.55 × 2.20** |
| `KEY2` (SWITCH-TS24CA) | 21.24..24.90 | 16.98..21.54 | -7.30..-5.10 | **3.66 × 4.55 × 2.20** |
| `MIC1` | -24.14..-21.54 | -3.09..0.31 | -6.60..-5.60 | **2.60 × 3.40 × 1.00** |
| `J2`（USB-C 端连接器，需以图核对命名） | -4.79..4.79 | -38.28..-30.57 | -8.75..-4.59 | **9.58 × 7.71 × 4.16** |

上表是提取三维模型的 axis-aligned **外包围盒**：不能直接拿来替代按钮接触头、焊脚或外壳净空图。模型可能包含静态焊盘/终端细节；每种尺寸的真正用途需结合几何接触面识别。

### 三键中心与间距（仅作为定位基准）

| STEP 名称 | X 中心 | Y 中心 | Z 中心 | 与上一个键 Y 间距 |
| --- | ---: | ---: | ---: | ---: |
| KEY1 | 23.07 | **3.62** | -6.20 | — |
| KEY3 | 23.07 | **11.44** | -6.20 | **7.82** |
| KEY2 | 23.07 | **19.26** | -6.20 | **7.82** |

- **关键：按照原始 STEP 的 Y 升序是 KEY1 → KEY3 → KEY2，不是 KEY1 → KEY2 → KEY3。**
- 还没有通过原理图/丝印可靠映射 **KEY1/KEY2/KEY3 ↔ BOOT/RESET/BAT_PWR**；这些 STEP 名称只是机械装配名，**不可未经核查便当作功能按键名**。
- 三颗开关的模型最大 X≈24.90mm，PCB 基体最大 X≈24.98mm，**模型端部相对于 PCB 右边外轮廓内缩约 0.08mm**；屏幕总成最大 X≈25.27mm，端部相比屏幕外沿内缩约 **0.37mm**。
- 所以新键帽不能假设原生开关头“天然伸出整个设备侧壁”：它实际上大致与 PCB 边齐平，**还位于屏幕边缘内侧**。需要在后壳适当深度设置接触柱、捕获限位和独立外侧按压面。

### 厚度参考

- STEP 中 `BOARD` 基体 z≈−5.50 至 −3.90。
- 三键 z≈−7.30 至 −5.10：布置在**PCB 背面/下侧**的同一深度层。
- MIC1 z≈−6.60 至 −5.60：也偏向 **PCB 背面**。
- 整套带屏幕板（不含另外选择的电池/独立喇叭）最大总厚度约 **10.22mm**，范围来自屏幕正面 z≈+0.70 至 PCB 最后方支柱 z≈−9.51。它**不是成品整机厚度**。

## 三、已经证明 vs 仍不能从 STEP 证明的事项

| 事项 | 状态 | 依据与下一步 |
| --- | --- | --- |
| 三键存在、位置、间距、静态外形 | **已由原始 STEP 实测** | `KEY1,KEY2,KEY3`，共同引用 `SWITCH-TS24CA` |
| 开关是否为侧向轻触类型 | **有较强外部佐证** | TS24CA 同系列在 DigiKey/LCSC 描述为 `Side Actuated / Right Angle`；但尚未识别微雪装配的**确切制造商、后缀及实际件** |
| 静态按键头的接触面位置 | **尚待局部几何投影/实物核实** | 外包络是完整开关（含壳和引脚），不是活动按帽的单独测量 |
| 按下后的实际行程 | **STEP 无运动状态、不能直接得出** | STEP 含单一静态 `SWITCH-TS24CA` 几何；需制造商对应款 datasheet 或微雪确认 |
| 操作力/机械寿命 | **未确认微雪具体子型号** | 市面同名 TS24CA 规格显示 0.2–0.25mm 行程、寿命/力度随制造商与变种改变；**不能取为原装保证** |
| 具体 BOOT/RESET/BAT_PWR 各是哪一个 KEYn | **未确认** | 对照丝印、原理图 BOM/位号与清晰官方实物图 |
| 麦克风位置与后侧元件包络 | **由 STEP 提取** | `MIC1` |
| 麦克风声孔朝哪个方向 | **未确认** | 不能把“MIC 在 PCB 左边”理解成“必须在设备左侧壁开孔”；先判断器件声孔面，可能应开在背盖 |
| USB-C 空间位置 | **由 STEP 提取** | `J2` 位于 USB 端；需再校验公/母插头有效插拔通道 |
| 螺钉孔中心距 | **官方 PDF 可核对 41×60mm** | 用 STEP/DXF 复测孔的实际轴心与公差，不能用支柱外包络中心替代孔中心 |
| 电池、独立扬声器 | **不在本次原厂整板 STEP 交付物内** | 用户到货后提供型号/实测尺寸，届时建模 |

## 四、与开关供应商资料的交叉核对（不是官方实装保证）

微雪 STEP 只给 `SWITCH-TS24CA` 这个模型名字。其他可信电子元件销售与供应商资料中，同名 TS24CA 被描述为侧按 SMD：

- [DigiKey：Shouhan TS24CA](https://www.digikey.my/en/products/detail/shenzhen-shouhan-technology-co-ltd/TS24CA/30280601)：标记 Side Actuated，某列示型号约 **0.25mm** 行程、**50,000** 次机械寿命。
- [LCSC：Shouhan TS24CA C393942](https://www.lcsc.com/product-detail/Tactile-Switches_SHOU-HAN-TS24CA_C393942.html)：侧按、标注不同机械寿命/操作力数据。
- [另一家 TS24CA 制造商 Hanxia](https://www.hx-switch.eu/product/automotive-tactile-switch/)：给出 **0.2±0.05mm** 行程、20,000 次等规格。

⚠️ **不能证明微雪实际焊上去的就是这几家其中任何一家的特定批次。** 只可用于确认此类微型侧按开关的存在与设计行程数量级；键帽预留间隙、硬限位和具体行程应待确认实装料号。半年试用目标不要求为极端寿命加复杂机构，但不能设计成长期预压、卡键或压断焊点。

## 五、V1 结构建议（依据本次测量修正）

1. 原生 **USB-C 朝上**，不使用延长线。
2. 两颗实际需手指操作的原生功能键：BOOT、BAT_PWR，采用**独立短行程帽 + 壳体限位**；RESET 优先隐藏维护孔。
3. **因开关头几乎不越过 PCB 边缘，键帽必须从侧壁伸入至正确接触面**；仅在壳壁上开孔并让原生按钮“自然伸出来”是不成立的。
4. 按钮距离 7.82mm，允许两颗凸起键帽不连续布置；三颗的真实功能/次序核定后再定按键帽样式及维护针孔。
5. 确认声学拾音口朝向前，**不要按麦克风在左边就直接在左侧壁开孔**。
6. 装配最好先做一个侧键配合小样件，验证键帽导向、接触高度、按压余量、RESET 不误触，再打印整机。

## 六、可机器读取的数据

见 [data/step_component_bounds.csv](../data/step_component_bounds.csv)。它包含这次实际测量的元件 bounding boxes。**不包含制造公差**。

**后续 CAD 必须继续引用微雪原始 [STEP](https://github.com/waveshareteam/ESP32-C5-Touch-LCD-2.8/blob/main/dimensions/ESP32-C5-Touch-LCD-2.8.stp)**；本文是定位参考及限制说明，不能直接代替装配体。
