Gadil123/esp32-design/(commit log)

2026-10-15 docs: record confirmed official 2D dimensions while retaining CAD verification gate
2026-10-15 data: add measured STEP component bounding boxes in mm
    [step_component_bounds.csv]
2026-10-15 docs: mark completed STEP measurements and outstanding tactile-switch checks
2026-10-16 cad: add independent T0 12mm layout and 12.4mm comparison
    [assembly_light.step, front_shell.step, front_shell.stl, key1_cap.step, key1_cap.stl, key2_cap.step, key2_cap.stl, key3_cap.step]
2026-10-16 chore: keep CAD exports binary and normalize source formatting
    [t0_interface_bounds.csv]
2026-10-16 docs: link complete T0 review assemblies and keep rendering headless
2026-10-16 cad: add compact snap-only T0 A and honest key contact gates
    [assembly_light.step, front_shell.step, front_shell.stl, key1_cap.step, key1_cap.stl, key1_low_candidate.step, key1_low_candidate.stl, key2_cap.step]
2026-10-16 docs: specify T0 PA12 simplified four-snap and four-mount design study
2026-10-16 cad: document C assembly gate failure and add PA12 local coupons
    [C1_four_mount_static_BLOCKED.step, C2_two_native_M2_5_REAR_local_ONLY.step, RESET_2_2_fixture_context_NOT_PRINT.step, RESET_hole_2_0.step, RESET_hole_2_0.stl, RESET_hole_2_2.step, RESET_hole_2_2.stl, RESET_hole_2_5.step]
2026-10-16 cad: study one Passport-style short tooth and expose PCB axial restraint gap
    [D_four_nests_open_frame_BLOCKED.step, D_one_short_tooth_pair_LOCAL.step]
2026-10-16 cad: complete T0 E three-clip shell with independent closure stops
    [assembly_light.step, front_shell.step, front_shell.stl, key1_cap.step, key1_cap.stl, key2_cap.step, key2_cap.stl, key3_cap.step]
2026-10-16 docs: scope G recessed full-wrap shell CAD candidate alongside frozen E
2026-10-16 cad: add T0 G recessed enclosure and expose assembly tolerance blockers
    [assembly_light.step, four_NBK_SSH_M2_5_4_envelopes.step, front_shell.step, front_shell.stl, key1_cap.step, key1_cap.stl, key2_cap.step, key2_cap.stl]
2026-10-16 docs: scope G-V1 flush 12.4mm easy-assembly revision
2026-10-16 cad: stop G-V1 at verified rear keycap insertion interference
    [deep_front_GATE_ONLY.step, deep_front_GATE_ONLY.stl, key1_blocked_section.step, key1_cap.step, key1_cap.stl, key2_blocked_section.step, key2_cap.step, key2_cap.stl]
2026-10-16 docs: commission integrated PA12 side buttons for G-V1
2026-10-17 cad: add integrated PA12 G-V1 candidate and cumulative-fit blocking evidence
    [assembly_light.step, front_integrated_GATE_ONLY.step, front_integrated_GATE_ONLY.stl, front_shell.step, front_shell.stl, key1_rest_section.step, key2_rest_section.step, rear_shell.step]
2026-10-17 docs: scope G-V1 BOOT rectangular flexure and accessible assembly viewer
2026-10-17 cad: revise BOOT to rounded PA12 leaf and verify private viewer downloads
    [assembly_light.step, front_local_GATE_ONLY.step, front_shell.step, front_shell.stl]
2026-10-17 docs: freeze G-V1 CAD candidate and defer real-part measurements MIC1
2026-10-17 docs: make G-V1 frozen candidate current repository entrypoint
2026-10-19 cad: assess arrived G-V1 bodies and gate MIC and bay changes
2026-10-19 docs: clarify loose old battery tray and centered-pose assessment
